zeruns/xt60-power-meter/03-Datasheet/_命名规范.md

# 03-Datasheet 命名规范

> 2026-09-05 整理。目的：统一规格书/文档命名，便于检索与复购。

## 命名格式

| 来源 | 格式 | 示例 |
|---|---|---|
| 立创商城器件 | `型号_分类_规格书[_语言]_C编号.pdf` | `SY8511BADC_DC-DC电源芯片_规格书_中文机翻_C4944084.pdf` |
| 厂商原版文档 | `型号_描述_文档类型_语言.pdf` | `TPS2116_电源多路复用器_规格书_英文.pdf` |
| 应用笔记/参考 | `厂商-文档号_主题_类型_语言.pdf` | `TI-ZHCA068_模数转换术语词汇表_中文.pdf` |
| 显示模组资料 | 子目录 `模组型号_描述`，内部 `模组型号_内容类型_版本.zip` | `TK018F3716_例程_ESP32_LVGL_QSPI.zip` |

**规则**：

1. **型号永远放在文件名最前面**，同型号多份文档（规格书/手册/EVM）靠前缀自然聚在一起排序；
2. 扩展名一律小写 `.pdf`；
3. 语言后缀：存在多语言版本时区分 `英文` / `中文` / `中文机翻`；单一中文原版可不加；
4. 立创商城文件的 **C 编号固定放在文件名最后**（复购检索键），WJ 文档编号已去除；
5. 机翻文档一律带 `中文机翻` 标记，以区别原厂中文文档。

## 器件身份备注（原名无法辨识的 4 份）

| 文件 | 身份 |
|---|---|
| `HSS2P10_100V-P沟道MOSFET_规格书_英文.pdf` | 华笙半导体 hs-semi，P 沟道 100V 快速开关 MOSFET，SOT-23L |
| `LRA8551A-T_零漂移轨到轨运放_规格书_中文.pdf` | 洛瑞微 lorysemi，零漂移低噪声轨到轨 CMOS 运放（SOT23-5，覆盖 LRA8551/8552/8554） |
| `NV3030B_TFT控制器驱动IC_规格书_英文.pdf` | 上海新相微，240RGB×320 TFT 控制器驱动 IC（TK018F3716 屏配套） |
| `TI-ZHCA068_模数转换术语词汇表_中文.pdf` | TI 应用报告 ZHCA068《术语词汇表：模数转换的规格和性能特点》 |

## 已完成整改（2026-09-05）

全部 22 项（根目录 17 文件 + 屏模组资料目录及其内部 8 项）均已按上述规范重命名完毕。
