zeruns/xt60-power-meter/05-生产文件/02-贴片/02-上板_V1/01-上板_V1-BOM.xlsx

No. | Quantity | Comment | Designator | Footprint | Manufacturer Part | 规格 | 单价 | 价格 | 立创商城编号 | 淘宝购买链接 | 备注：表中单价为立创商城商品页当前标价（人民币），查询日期 2026-09-16；总价见末行
1 | 1 | 4kHz | BUZZER1 | BUZ-SMD_3P-L5.0-W5.0-BL | SMD-5025-0340-12Ω | 贴片无源蜂鸣器，SMD-5025-0340-12Ω，3V/4kHz/5x5mm | ￥3.010 | ￥3.010 | C2693575
2 | 11 | 4.7uF | C1,C3,C6,C9,C10,C14,C20,C26,C27,C28,C31 | C0402 | CL05A475KP5NRNC | 贴片电容，0402，4.7uF/10V/±10%/X5R | ￥0.102 | ￥1.127 | C368809 | https://s.click.taobao.com/t
3 | 4 | 22uF | C2,C5,C8,C12 | C0402 | CL05A226MQ5QUNC | 贴片电容，0402，22uF/6.3V/±20%/X5R | ￥0.828 | ￥3.310 | C105226
4 | 15 | 100nF | C4,C7,C15,C21,C22,C23,C24,C29,C32,C37,C38,C42,C43,C45,C46 | C0402 | CL05A104KA5NNNC | 贴片电容，0402，100nF/25V/±10%/X5R | ￥0.037 | ￥0.552 | C100072 | https://s.click.taobao.com/t
5 | 1 | 100nF | C11 | C0603 | 0603B104K101NT | 贴片电容，0603，100nF/100V/±10%/X7R | ￥0.074 | ￥0.074 | C88219
6 | 4 | 10uF | C13,C18,C19,C30 | C0402 | CL05A106MQ5NUNC | 贴片电容，0402，10uF/6.3V/±20%/X5R | ￥0.157 | ￥0.629 | C15525
7 | 1 | 4.7uF | C16 | C1206 | GRM31CC72A475KE11L | 贴片电容，1206，4.7uF/100V/±10%/X7S | ￥2.669 | ￥2.669 | C237304
8 | 1 | 1uF | C17 | C1206 | 1206B105K101NT | 贴片电容，1206，1uF/100V/±10%/X7R | ￥0.356 | ￥0.356 | C91151
9 | 1 | 47pF | C25 | C0402 | 0402CG470J500NT | 贴片电容，0402，47pF/50V/±5%/C0G | ￥0.050 | ￥0.050 | C1567
10 | 4 | 220nF | C33,C34,C40,C44 | C0402 | CL05B224KO5NNNC | 贴片电容，0402，220nF/16V/±10%/X7R | ￥0.031 | ￥0.124 | C16772
11 | 1 | 1uF | C35 | C0402 | CL05A105KA5NQNC | 贴片电容，0402，1uF/25V/±10%/X5R | ￥0.060 | ￥0.060 | C52923
12 | 2 | 10nF | C36,C39 | C0402 | CL05B103KB5NNNC | 贴片电容，0402，10nF/50V/±10%/X7R | ￥0.030 | ￥0.061 | C15195
13 | 1 | 10pF | C41 | C0402 | CL05C100JB5NNNC | 贴片电容，0402，10pF/50V/±5%/C0G | ￥0.038 | ￥0.038 | C32949
14 | 1 | BTB0.408-24PLBDR-M41 | CN1 | CONN-SMD_BTB0.408-24PLBDR-M41 | BTB0.408-24PLBDR-M41 | 板对板连接器，BTB0.408-24PLBDR-M41，0.4mm间距/24P/双排立贴/镀金 | ￥1.309 | ￥1.309 | C42420567
15 | 1 | HX PM2.0-1x6P TP-YQ | CN2 | CONN-SMD_6P-P2.00_HX-PM2.0-1X6P-TP-YQ | HX PM2.0-1x6P TP-YQ | 排母连接器，HX PM2.0-1x6P TP-YQ，2.0mm间距/1×6P/立贴 | ￥1.248 | ￥1.248 | C42379205
16 | 4 | CUS10S30,H3F | D1,D3,D4,D13 | SOD-323_L1.8-W1.3-LS2.5-RD | CUS10S30,H3F | 肖特基二极管，CUS10S30，SOD-323，30V/300mA | ￥0.303 | ￥1.214 | C146335
17 | 4 | ESD9B5.0ST5G | D2,D5,D6,D7 | SOD-923_L0.8-W0.6-LS1.0-BI | ESD9B5.0ST5G | TVS二极管，ESD9B5.0ST5G，SOD-923，5V双向ESD防护/钳位15V | ￥0.280 | ￥1.120 | C111566
18 | 3 | ESD9B3.3ST5G-N | D8,D10,D11 | DFN1006-2L-BI | ESD9B3.3ST5G-N | ESD二极管，ESD9B3.3ST5G-N，DFN1006-2，3.3V双向/钳位8V | ￥0.149 | ￥0.448 | C316039
19 | 1 | SS210B | D9 | SMB_L4.6-W3.6-LS5.3-RD | SS210B | 肖特基二极管，SS210B，SMB(DO-214AA)，100V/2A | ￥0.241 | ￥0.241 | C18199186
20 | 1 | BZT52C12 | D12 | SOD-123_L2.7-W1.6-LS3.7-RD | BZT52C12 | 稳压二极管，BZT52C12，SOD-123，12V/350mW | ￥0.103 | ￥0.103 | C19077410 | https://s.click.taobao.com/t
21 | 2 | SMD0805-200-9V | F1,F2 | F0805 | SMD0805-200-9V | 自恢复保险丝，SMD0805-200-9V，0805，9V/保持2A/触断4A | ￥0.483 | ￥0.967 | C2843996
22 | 1 | S1206-FC-1.0A | F3 | F1206 | S1206-FC-1.0A | 一次性贴片保险丝，S1206-FC-1.0A，1206，1A/100V | ￥1.360 | ￥1.360 | C2691993
23 | 1 | ZX-MX1.25-2PWT | J1 | CONN-SMD_2P-P1.25_MEGASTAR_ZX-MX1.25-2PWT | ZX-MX1.25-2PWT | 线对板连接器，ZX-MX1.25-2PWT，1.25mm间距/2P/侧卧贴/1A | ￥0.179 | ￥0.179 | C7430468 | https://s.click.taobao.com/t
24 | 1 | 2.2uH | L1 | IND-SMD_L2.0-W1.6-B | FTC201610S2R2MBCA | 功率电感，FTC201610S2R2，0806，2.2uH/2.5A/饱和3A | ￥0.272 | ￥0.272 | C5832344
25 | 1 | 47uH | L2 | IND-SMD_L6.0-W6.0_FNR60XXS | FNR6045S470MT | 功率电感，FNR6045S470MT，6x6mm，47uH/1.3A/饱和1.5A/磁屏蔽 | ￥0.434 | ￥0.434 | C168087 | https://s.click.taobao.com/t
26 | 3 | BLM18PG121SN1D | L3,L4,L5 | L0603 | BLM18PG121SN1D | 贴片磁珠，BLM18PG121SN1D，0603，120Ω@100MHz/2A/DCR 50mΩ | ￥0.096 | ￥0.289 | C14709 | https://s.click.taobao.com/t
27 | 1 | XL-3210SURUGC | LED1 | LED-SMD_4P-L3.2-W1.5_XL-3210SURUGC | XL-3210SURUGC | 贴片LED，XL-3210SURUGC，3210侧发光，红(625nm)+翠绿(525nm)双色 | ￥0.196 | ￥0.196 | C965883 | https://s.click.taobao.com/t
28 | 1 | KT-0603R | LED2 | LED-SMD_L1.6-W0.8-R-RD | KT-0603R | 贴片LED，KT-0603R，0603，红色/645nm/20mA | ￥0.045 | ￥0.045 | C2286 | https://s.click.taobao.com/t
29 | 1 | SP30P25DNJ | Q1 | PDFN3333-8_L3.3-W3.3-P0.65-LS3.4-BL | SP30P25DNJ | P沟道MOSFET，SP30P25DNJ，PDFNWB-8L(3.3x3.3)，-30V/10A | ￥0.611 | ￥0.611 | C41355085
30 | 1 | AO3401A | Q2 | SOT-23_L2.9-W1.3-P1.90-LS2.4-BR | AO3401A | P沟道MOSFET，AO3401A，SOT-23，-30V/4.2A | ￥0.225 | ￥0.225 | C347476 | https://s.click.taobao.com/t
31 | 2 | AO3400A | Q3,Q5 | SOT-23-3_L2.9-W1.3-P1.90-LS2.4-BR | AO3400A | N沟道MOSFET，AO3400A，SOT-23，30V/5.8A | ￥0.228 | ￥0.456 | C347475 | https://s.click.taobao.com/t
32 | 1 | HSS2P10 | Q4 | SOT-23-3_L2.9-W1.6-P1.90-LS2.8-BR | HSS2P10 | P沟道MOSFET，HSS2P10，SOT-23L，-100V/2A | ￥0.788 | ￥0.788 | C845592
34 | 12 | 10kΩ | R1,R7,R10,R13,R18,R20,R21,R22,R32,R38,R41,R42 | R0402 | 0402WGF1002TCE | 贴片电阻，0402，10kΩ/±1%/62.5mW | ￥0.021 | ￥0.246 | C25744 | https://s.click.taobao.com/t
35 | 3 | 5.1kΩ | R2,R3,R4 | R0402 | 0402WGF5101TCE | 贴片电阻，0402，5.1kΩ/±1%/62.5mW | ￥0.013 | ￥0.040 | C25905 | https://s.click.taobao.com/t
36 | 1 | 32.4kΩ | R5 | R0402 | 0402WGF3242TCE | 贴片电阻，0402，32.4kΩ/±1%/62.5mW | ￥0.016 | ￥0.016 | C26974 | https://s.click.taobao.com/t
37 | 2 | 100kΩ | R6,R24 | R0402 | 0402WGF1003TCE | 贴片电阻，0402，100kΩ/±1%/62.5mW | ￥0.014 | ￥0.028 | C25741 | https://s.click.taobao.com/t
38 | 1 | 5.1Ω | R8 | R0402 | 0402WGJ051JTCE | 贴片电阻，0402，5.1Ω/±5%/62.5mW | ￥0.010 | ￥0.010 | C25174 | https://s.click.taobao.com/t
39 | 4 | 10Ω | R9,R23,R26,R40 | R0402 | 0402WGF100JTCE | 贴片电阻，0402，10Ω/±1%/62.5mW | ￥0.016 | ￥0.064 | C25077 | https://s.click.taobao.com/t
40 | 7 | 2.2kΩ | R11,R16,R19,R43,R44,R45,R46 | R0402 | 0402WGF2201TCE | 贴片电阻，0402，2.2kΩ/±1%/62.5mW | ￥0.032 | ￥0.227 | C25879 | https://s.click.taobao.com/t
41 | 1 | 10Ω | R12 | R0603 | 0603WAJ0100T5E | 贴片电阻，0603，10Ω/±5%/100mW | ￥0.013 | ￥0.013 | C25202 | https://s.click.taobao.com/t
42 | 1 | 470kΩ | R14 | R0805 | 0805W8F4703T5E | 贴片电阻，0805，470kΩ/±1%/125mW | ￥0.013 | ￥0.013 | C17709 | https://s.click.taobao.com/t
43 | 2 | 150kΩ | R15,R17 | R0805 | 0805W8F1503T5E | 贴片电阻，0805，150kΩ/±1%/125mW | ￥0.027 | ￥0.054 | C17470 | https://s.click.taobao.com/t
44 | 1 | 1kΩ | R25 | R0402 | 0402WGF1001TCE | 贴片电阻，0402，1kΩ/±1%/62.5mW | ￥0.013 | ￥0.013 | C11702 | https://s.click.taobao.com/t
45 | 2 | 0Ω | R27,R28 | R0402 | 0402WGF0000TCE | 贴片电阻（0Ω跳线），0402，0Ω/62.5mW | ￥0.015 | ￥0.030 | C17168 | https://s.click.taobao.com/t
46 | 4 | 49.9Ω | R30,R31,R35,R37 | R0402 | 0402WGF499JTCE | 贴片电阻，0402，49.9Ω/±1%/62.5mW | ￥0.015 | ￥0.061 | C25120 | https://s.click.taobao.com/t
47 | 1 | 100kΩ | R33 | R0805 | RT0805BRD07100KL | 贴片精密电阻，0805，100kΩ/±0.1%/125mW | ￥0.255 | ￥0.255 | C122537 | https://s.click.taobao.com/t
48 | 2 | 22Ω | R34,R36 | R0402 | 0402WGF220JTCE | 贴片电阻，0402，22Ω/±1%/62.5mW | ￥0.016 | ￥0.032 | C25092 | https://s.click.taobao.com/t
49 | 1 | 1kΩ | R39 | R0805 | RT0805BRD071KL | 贴片精密电阻，0805，1kΩ/±0.1%/125mW | ￥0.269 | ￥0.269 | C110774 | https://s.click.taobao.com/t
50 | 1 | MST-12D18G4 SPDT Slide Switch | SW1 | SW-SMD_MST-12D18G4-SPDT-SLIDE-SWITCH | MST-12D18G4 SPDT Slide Switch | 拨动开关，MST-12D18G4，SPDT/卧贴/12V 100mA | ￥0.486 | ￥0.486 | C49023767
51 | 2 | TS-1045-A13B3-D2 | SW2,SW4 | SW-SMD_L7.5-W8.0-P4.50_TS-1045-A13B3-D2 | TS-1045-A13B3-D2 | 轻触开关，TS-1045-A13B3-D2，SMD侧按/250gf/带定位柱/8x7.5mm | ￥0.628 | ￥1.256 | C557898
52 | 1 | TS-1088-AR02016 | SW3 | SW-SMD_L3.9-W3.0-P4.45 | TS-1088-AR02016 | 轻触开关，TS-1088-AR02016，SMD/160gf/12V/10万次，小龟按键 | ￥0.314 | ￥0.314 | C720477 | https://s.click.taobao.com/t
53 | 1 | TLV62084DSGR | U1 | WSON-8_L2.0-W2.0-P0.50-BL-EP_DSG | TLV62084DSGR | DC-DC同步降压芯片，TLV62084DSGR，WSON-8(2x2)，2MHz/2A/输入2.5~6V | ￥0.945 | ￥0.945 | C181488 | https://s.click.taobao.com/t
54 | 1 | TP4057 | U2 | SOT-23-6_L2.9-W1.6-P0.95-LS2.8-BR | TP4057 | 锂电池充电管理芯片，TP4057，SOT-23-6，输入4~6.5V/恒流恒压充电 | ￥0.250 | ￥0.250 | C725791 | https://s.click.taobao.com/t
55 | 1 | SY8511BADC | U3 | TSOT-23-6_L2.9-W1.6-P0.95-LS2.8-BR | SY8511BADC | DC-DC降压芯片，SY8511BADC，TSOT-23-6，输入100V/1.2A/200kHz | ￥4.070 | ￥4.070 | C4944084
56 | 1 | ESP32-S3-WROOM-1-N16R8 | U4 | WIRELM-SMD_ESP32-S3-WROOM-1 | ESP32-S3-WROOM-1-N16R8 | 主控WiFi+蓝牙模组，ESP32-S3-WROOM-1-N16R8，16MB Flash/8MB PSRAM/PCB天线 | ￥31.600 | ￥31.600 | C2913202 | https://s.click.taobao.com/t
57 | 1 | 8.192MHz | U5 | OSC-SMD_4P-L3.2-W2.5-CJ13-320001210A20 | OT2JI-111-8.192M | 有源晶振，OT2JI-111-8.192M，SMD3225-4P，8.192MHz/±10ppm/1.8~3.3V | ￥2.940 | ￥2.940 | C7425393 | https://s.click.taobao.com/t?skuId=4412713765749
58 | 1 | ADS131M02IRUKR | U6 | WQFN-20_L3.0-W3.0-P0.40-TL-EP1.7 | ADS131M02IRUKR | ADC芯片，ADS131M02IRUKR，WQFN-20(3x3)，双通道24位ΔΣ同步采样 | ￥16.800 | ￥16.800 | C5215160 | https://s.click.taobao.com/t
59 | 1 | LRA8551A-T | U7 | SOT-23-5_L2.9-W1.6-P0.95-LS2.8-BR | LRA8551A-T | 运算放大器，LRA8551A-T，SOT-23-5，零漂移/轨到轨/1.7MHz | ￥1.273 | ￥1.273 | C54333729
60 | 1 | SC7A20HTR | U8 | LGA-12_L2.0-W2.0-P0.50-TL | SC7A20HTR | 三轴加速度计，SC7A20HTR，LGA-12(2x2)，I2C/SPI/±16g/12bit | ￥1.749 | ￥1.749 | C19274408 | https://s.click.taobao.com/t
61 | 1 | AHT20 | U9 | SENSOR-SMD_L3.0-W3.0-P1.00-BR | AHT20 | 温湿度传感器，AHT20，SMD，I2C/±2%RH/±0.3℃ | ￥4.890 | ￥4.890 | C2757850
62 | 1 | TYPE-C 16PIN 2MD(073) | USB1 | USB_TYPE-C-16P | TYPE-C 16PIN 2MD(073) | USB连接器，TYPE-C 16PIN 2MD(073)，16P母座/卧贴/5V | ￥0.434 | ￥0.434 | C2765186
 |  |  |  |  |  |  | 总价 | ¥152.941
 |  |  |  |  |  |  | 元器件 | ￥91.944
 | 1 |  |  |  |  | 聚合物锂电池，带保护板/500mAh/MX1.25反向公插，长宽高 51x22x5mm | ￥8.200 | ￥8.200 |  | https://s.click.taobao.com/t
 | 1 |  |  |  |  | 导光柱，直径3mm，长5.5mm | ￥0.209 | ￥0.209 |  | https://uland.taobao.com/coupon/edetail?traceId=213e0aaa17899884014852849e0cd6
 | 1 |  |  |  |  | 1.83寸电容触摸LCD屏，240×284，QSPI，NV3030B，TK018F3716 | ￥14.810 | ￥14.810 |  | https://item.taobao.com/item.htm?id=1001917382287
 | 1 |  |  |  |  | 青稞纸，贴电池用 | ￥2.380 | ￥2.380 |  | https://s.click.taobao.com/t
 | 8 |  |  |  |  | 热熔螺母，M2.5*3.5*3.5 | ￥0.062 | ￥0.498 |  | https://uland.taobao.com/coupon/edetail?traceId=215048c017899891999342969e0c20
 | 2 |  |  |  |  | XT60带线接头 | ￥5.500 | ￥11.000 |  | https://s.click.taobao.com/t
 | 1 |  |  |  |  | 3D打印外壳 | ￥15.000 | ￥15.000
 | 1 |  |  |  |  | SMT钢网 | ￥8.900 | ￥8.900 |  | https://s.click.taobao.com/t
 |  |  |  |  |  |  |  |  | 立创商城优惠券领取链接 | https://activity.szlcsc.com/invite/D03E5B9CEAAE70A4.html
 |  |  |  |  |  |  |  | 128.33
