zeruns/xt60-power-meter/05-生产文件/02-贴片/01-下板/01-下板-BOM.xlsx

No. | Quantity | Comment | Designator | Footprint | Manufacturer Part | 规格 | 单价 | 价格 | 立创商城编号 | 淘宝购买链接 | 备注：表中单价为立创商城商品页当前标价（人民币），查询日期 2026-09-16；总价见末行
1 | 1 | XT60PW-M | CN1 | CONN-TH_XT60PW-M | XT60PW-M | XT60电源连接器（公头），AMASS XT60PW-M，卧式穿板焊接 | ￥3.300 | ￥3.300 | C98732 | https://s.click.taobao.com/t
2 | 1 | XT60PW-F | CN2 | TH_2P-XT60PW-F | XT60PW-F | XT60电源连接器（母头），AMASS XT60PW-F，卧式穿板焊接 | 3.9400 | ￥3.940 | C428722 | https://s.click.taobao.com/t
3 | 5 | BTC-1842-BT01 | CU1,CU2,CU3,CU4,CU5 | CONN-SMD_BTC-1842-BT01 | BTC-1842-BT01 | 导电铜块，BTC-1842-BT01，SMD/18×4×2mm/黄铜镀锡 | 0.9886 | ￥4.943 | C42455226 | https://s.click.taobao.com/t
4 | 1 | SMBJ100A | D1 | SMB_L4.6-W3.6-LS5.3-RD | SMBJ100A | TVS二极管，SMBJ100A，SMB(DO-214AA)，单向100V/600W/钳位162V | 0.6880 | ￥0.688 | C151249 | https://s.click.taobao.com/t
5 | 1 | HX PZ2.0-1x6P TP-YQ | H1 | HDR-SMD_6P-P2.00-V-M-LS4.4-L_XKB-R1 | HX PZ2.0-1x6P TP-YQ | 排母连接器，2.0mm间距/1×6P/立贴/反脚位/针长10mm | 0.4706 | ￥0.471 | C41417345 | https://s.click.taobao.com/t
6 | 1 | 1mΩ | R1 | RES-SMD_SBB-M-1F-Y-T5 | SBB-M-1F-Y-T5 | 四端开尔文分流电阻，SBB-M-1F-Y-T5，1mΩ/5W/±1%/±75ppm | 3.6900 | ￥3.690 | C469457 | https://s.click.taobao.com/t
 |  |  |  |  |  |  | 总价 | ￥17.031
 |  |  |  |  |  |  |  |  | 立创商城优惠券领取链接 | https://activity.szlcsc.com/invite/D03E5B9CEAAE70A4.html
