zeruns/xt60-power-meter/05-生产文件/03-外壳3D打印文件/上盖.3MF

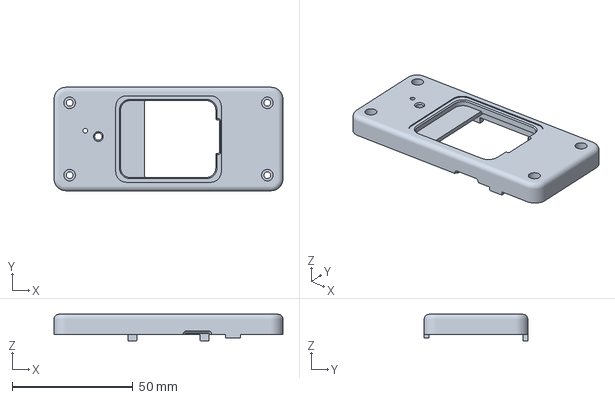
[picture p3: CAD file, 2026-10-08]
05-生产文件/03-外壳3D打印文件/上盖.3MF
95.0 x 43.0 x 11.0 mm
