zeruns/xt60-power-meter/05-生产文件/03-外壳3D打印文件/合并打印.3mf

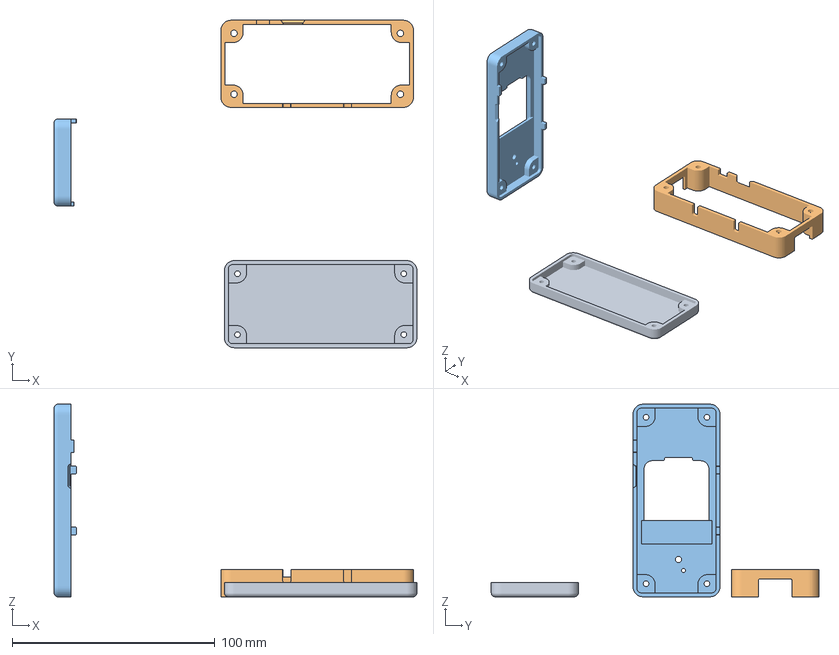
[picture p4: CAD file, 2026-10-08]
05-生产文件/03-外壳3D打印文件/合并打印.3mf
178.9 x 161.5 x 95.0 mm
底盖
中框
上盖
