zeruns/xt60-power-meter/04-外壳设计/中框.SLDPRT

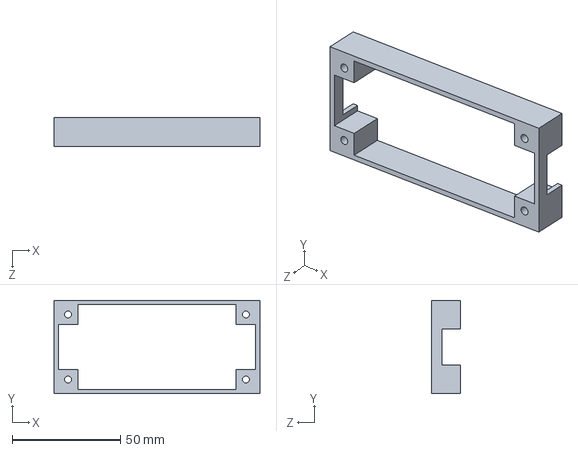
[picture p5: CAD file, 2026-10-08]
04-外壳设计/中框.SLDPRT
95.0 x 43.0 x 13.5 mm
