zeruns/xt60-power-meter/05-生产文件/03-外壳3D打印文件/中框.3MF

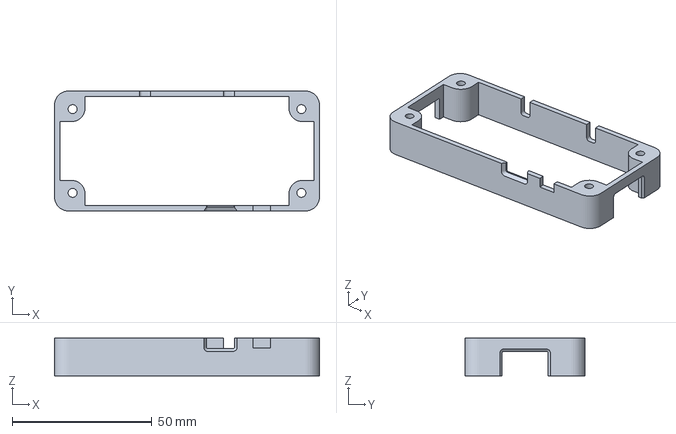
[picture p6: CAD file, 2026-10-08]
05-生产文件/03-外壳3D打印文件/中框.3MF
95.0 x 43.0 x 13.5 mm
