zeruns/xt60-power-meter/05-生产文件/03-外壳3D打印文件/底盖.3mf

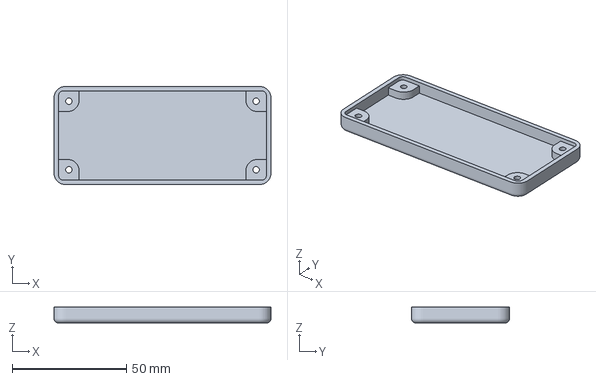
[picture p7: CAD file, 2026-10-08]
05-生产文件/03-外壳3D打印文件/底盖.3mf
95.0 x 43.0 x 7.00 mm
