zeruns/xt60-power-meter/04-外壳设计/外壳装配体.SLDASM

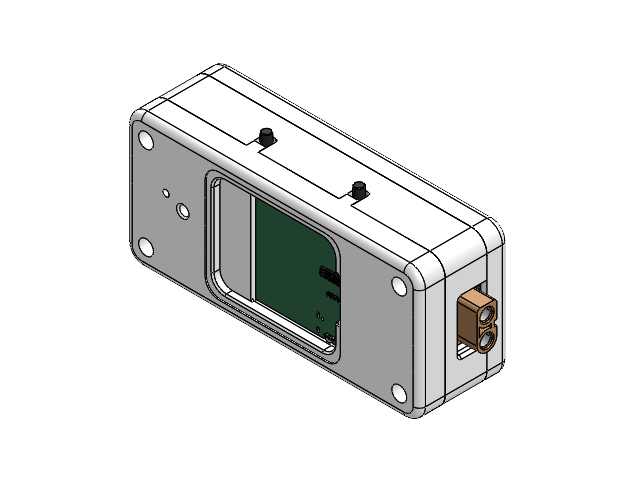
[picture p8: CAD file, 2026-10-08]
04-外壳设计/外壳装配体.SLDASM
SMB_L4.6-W3.6-LS5.3-RD~SMB_L4.6-W3.6-LS5.3-RD~CHkK.step
CONN-TH_XT60PW-M~CONN-TH_XT60PW-M~NLxI.step
TH_2P-XT60PW-F~TH_2P-XT60PW-F~r0KK.step
RES-SMD_SBB-M-1F-Y-T5~RES-SMD_SBB-M-1F-Y-T5~DRAF.step
CONN-SMD_BTC-1842-BT01~CONN-SMD_BTC-1842-BT01~lrje.step x 5
HDR-SMD_6P-P2.00-V-M-LS4.4-L_XKB-R1~HDR-SMD_6P-P2.00-V-M-LS4.4-L_XKB-R1~AGqm.step
Board~lj8n.step
中框
C0402~C0402_L1.0-W0.5-H0.5~iRhJ.step x 43
SOT-23-3_L2.9-W1.6-P1.90-LS2.8-BR~SOT-23-3L_L2.9-W1.6-H1.1-LS2.8-P0.95~3Ph4.step
WQFN-20_L3.0-W3.0-P0.40-TL-EP1.7~WQFN-20_L3.0-W3.0-H0.8-P0.40-TL-EP1.7~yOUk.step
PDFN3333-8_L3.3-W3.3-P0.65-LS3.4-BL~PDFN3333-8_L3.3-W3.3-P0.65-LS3.4-BL~Qcuu.step
WIRELM-SMD_ESP32-S3-WROOM-1~WIRELM-SMD_ESP32-S3-WROOM-1~ZIDr.step
SOD-323_L1.8-W1.3-LS2.5-RD~SOD-323_L1.8-W1.3-LS2.5-RD~OhwX.step x 4
C1206~C1206_L3.2-W1.6-H1.3~eSGD.step x 2
TSOT-23-6_L2.9-W1.6-P0.95-LS2.8-BR~TSOT-23-6_L2.9-W1.6-H1.1-LS2.8-P0.95~vyBI.step
SENSOR-SMD_L3.0-W3.0-P1.00-BR~SENSOR-SMD_L3.0-W3.0-P1.00-BL~TEV3.step
CONN-SMD_2P-P1.25_MEGASTAR_ZX-MX1.25-2PWT~CONN-SMD_2P-P1.25_MEGASTAR_ZX-MX1.25-2PWT~wOmS.step
SOT-23-6_L2.9-W1.6-P0.95-LS2.8-BR~SOT-23-6_L2.9-W1.6-H1.5-LS2.8-P0.95~tY5K.step
IND-SMD_L2.0-W1.6-B~IND-SMD_L2.0-W1.6-B~Fn8O.step
R0603~R0603~Tp1J.step
R0805~R0805_L2.0-W1.3-H0.6~w2o1.step x 5
F0805~F0805_L2.1-W1.4-H0.8~PwN9.step x 2
R0402~R0402_L1.0-W0.5-H0.4~yztK.step x 39
SW-SMD_MST-12D18G4-SPDT-SLIDE-SWITCH~SW-SMD_MST-12D18G4-SPDT-SLIDE-SWITCH~sU5d.step
SOT-23-3_L2.9-W1.3-P1.90-LS2.4-BR~SOT-23-3P_L2.9-W1.3-H1.0-LS2.4-P0.95~x4Bm.step x 2
SOT-23_L2.9-W1.3-P1.90-LS2.4-BR~SOT-23-3P_L2.9-W1.3-H1.0-LS2.4-P0.95~x4Bm.step
CONN-SMD_BTB0.408-24PLBDR-M41~CONN-SMD_BTB0.408-24PLBDR-M41~3VoG.step
CONN-SMD_6P-P2.00_HX-PM2.0-1X6P-TP-YQ~CONN-SMD_6P-P2.00_HX-PM2.0-1X6P-TP-YQ~gmyt.step
WSON-8_L2.0-W2.0-P0.50-BL-EP_DSG~WSON-8_L2.0-W2.0-H0.8-P0.50~izss.step
IND-SMD_L6.0-W6.0_FNR60XXS~IND-SMD_L6.0-W6.0-H2.8~AGfr.step
OSC-SMD_4P-L3.2-W2.5-CJ13-320001210A20~OSC-SMD_4P-L3.2-W2.5-CJ13-320001210A20~qHqt.step
SOD-123_L2.7-W1.6-LS3.7-RD~SOD-123_L2.7-W1.6-H1.4-LS3.7~TlDH.step
C0603~C0603_L1.6-W0.8-H0.8~jHWH.step
SMB_L4.6-W3.6-LS5.3-RD~SMB_L4.6-W3.6-LS5.3-RD~uK23.step
L0603~L0603_L1.6-W0.8-H0.5_BEAD~0wL0.step x 3
LED-SMD_L1.6-W0.8-R-RD~LED0603_L1.6-W0.8-H0.6~hOrp.step
USB_TYPE-C-16P~USB-C-SMD_TYPE-C-6PIN-2MD-073~608R.step
SOD-923_L0.8-W0.6-LS1.0-BI~SOD-923_L0.8-W0.6-H0.5-LS1.0~RgEq.step x 4
LED-SMD_4P-L3.2-W1.5_XL-3210SURUGC~LED-SMD_4P-L3.2-W1.5_XL-3210SURUGC~yK8K.step
BUZ-SMD_3P-L5.0-W5.0-BL~BUZ-SMD_3P-L5.0-W5.0-H3.0-BL~VJEj.step
DFN1006-2L-BI~DFN1006-2L-BI~nblW.step x 3
F1206~F1206_L3.2-W1.7-H0.6~HgEj.step
SW-SMD_L3.9-W3.0-P4.45~SW-SMD_L3.9-W2.9-H2.0-LS4.8~3HFB.step
SW-SMD_L7.5-W8.0-P4.50_TS-1045-A13B3-D2~SW-SMD_L7.5-W8.0-P4.50_TS-1045-A13B3-D2~0YKv.step x 2
LGA-12_L2.0-W2.0-P0.50-TL~LGA-12_L2.0-W2.0-H1.0-P0.50~G2pr.step
SOT-23-5_L2.9-W1.6-P0.95-LS2.8-BR~SOT-23-5_L2.9-W1.6-P0.95-LS2.8-BR~QRz2.step
Board~DWGG.step
上盖
底盖
