zeruns/xt60-power-meter/(list of files, cad)

Other CAD files:
03-Datasheet/TK018F3716_1.83寸LCD模组资料/TK018F3716_机构图.dwg
04-外壳设计/上盖.SLDPRT
04-外壳设计/底盖.SLDPRT
