zeruns/xt60-power-meter/02-Software/XT60-Power-Meter-Firmware/docs/images/oshwhub/ui-measure.png

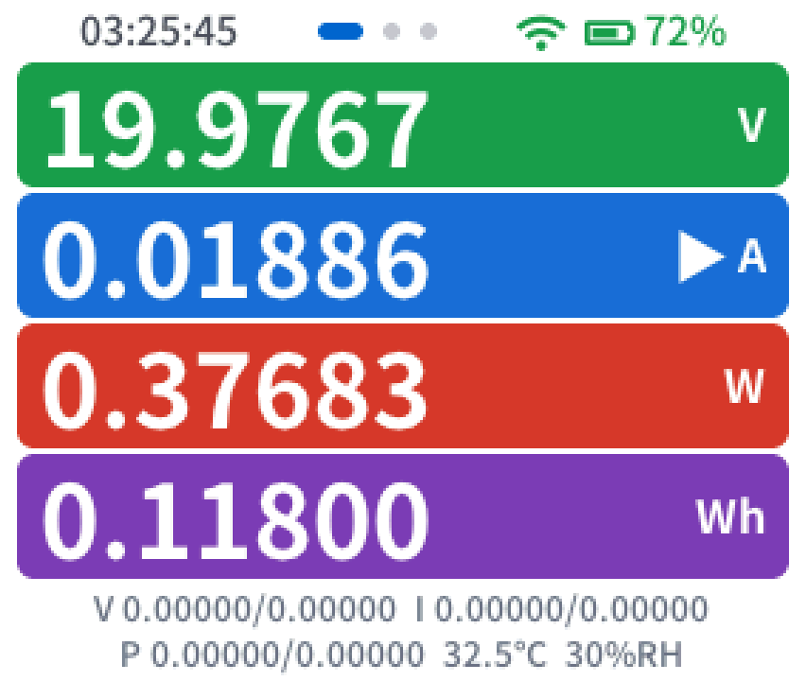
02-Software/XT60-Power-Meter-Firmware/docs/images/oshwhub/ui-measure.png
