zeruns/xt60-power-meter/01-Hardware/02-上板原理图_V2.pdf

# 3.3V Buck DC/DC（USB/电池供电）

## 最大输出电流2A

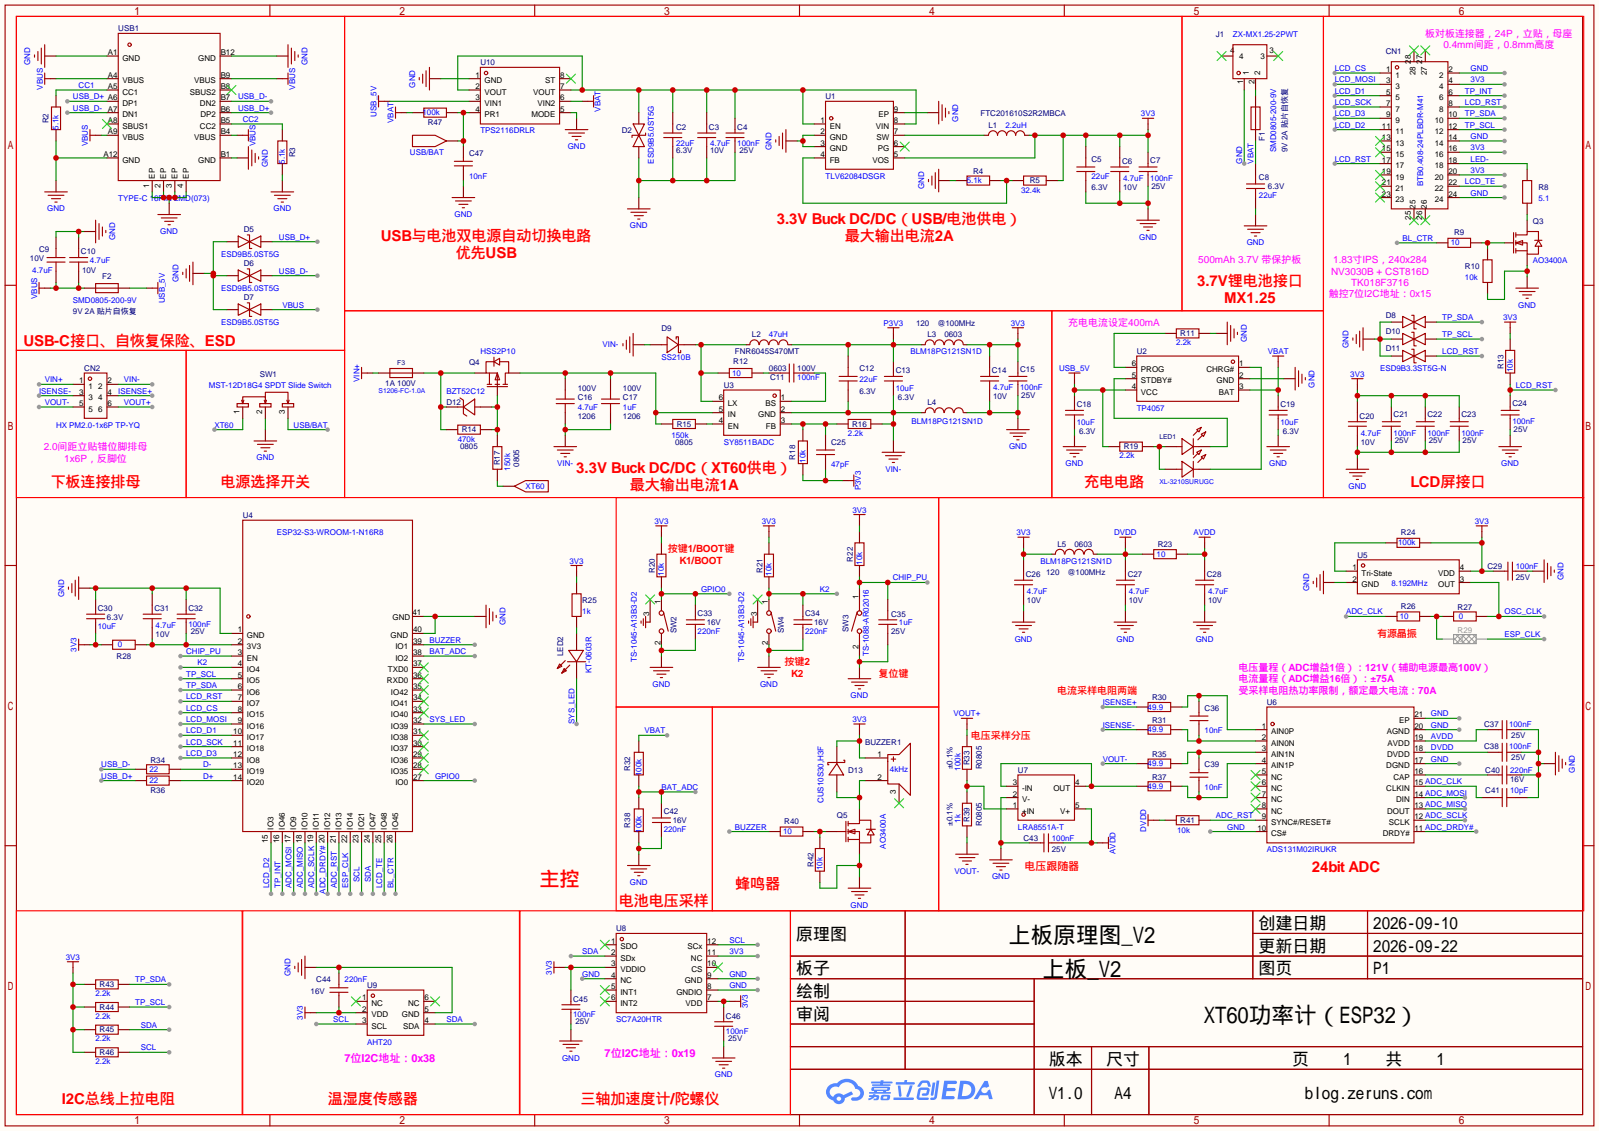
[picture p10: page 1]

USB-C接口、自恢复保险、ESD

MST-12D18G4 SPDT Slide Switch

原理图 | 上板原理图_V2 | 创建日期 | 2026-09-10

更新日期 | 2026-09-22

V1.0 | A4 | blog.zeruns.com
