zeruns/xt60-power-meter/01-Hardware/02-下板原理图.pdf

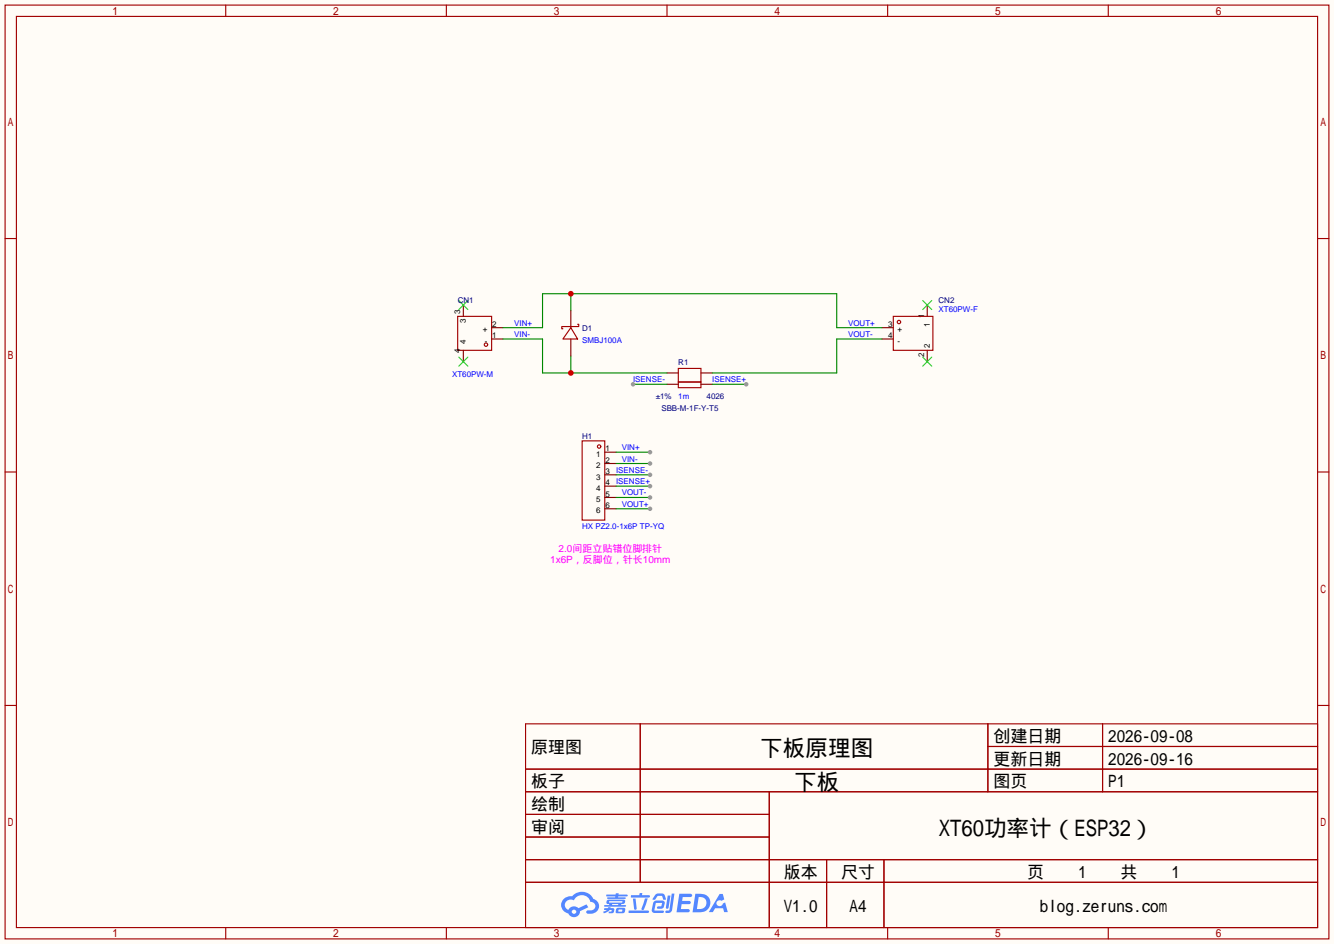
[picture p11: page 1]

原理图 | 下板原理图 | 创建日期 | 2026-09-08

更新日期 | 2026-09-16

板子 | 下板 | 图页 | P1
绘制 | | XT60功率计（ESP32）
审阅

V1.0 | A4 | blog.zeruns.com
