zeruns/xt60-power-meter/05-生产文件/02-贴片/01-下板/03-下板-位号图.pdf

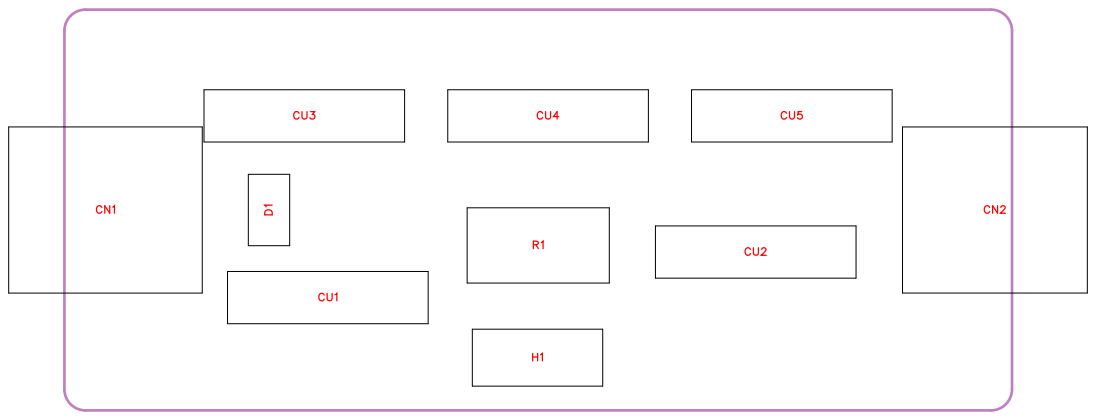
[picture p12: page 1]

# XT60功率计-下板_V1.0

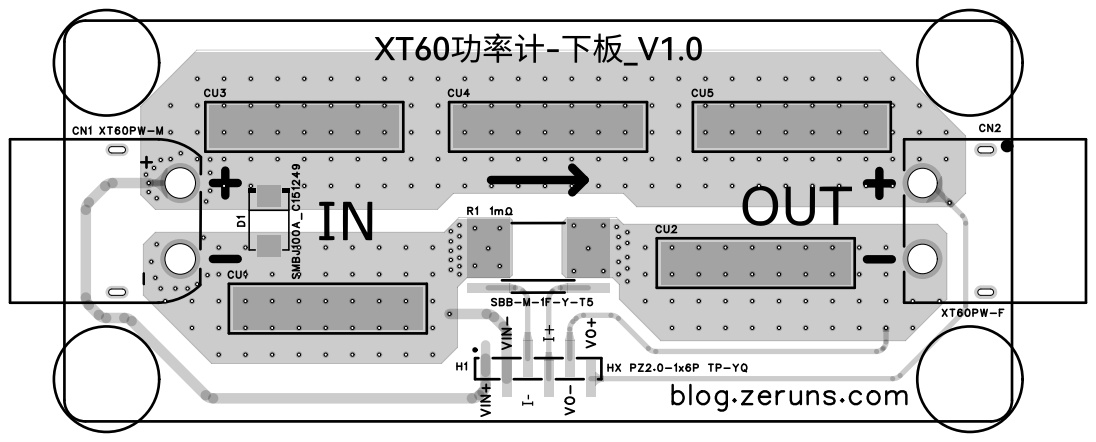
[picture p13: page 3]

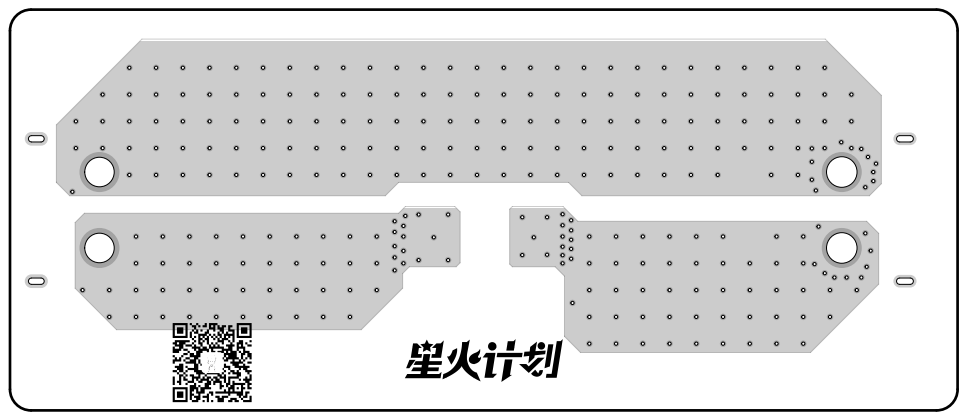
[picture p14: page 4]
