zeruns/xt60-power-meter/05-生产文件/02-贴片/02-上板_V1/03-上板_V1-位号图.pdf

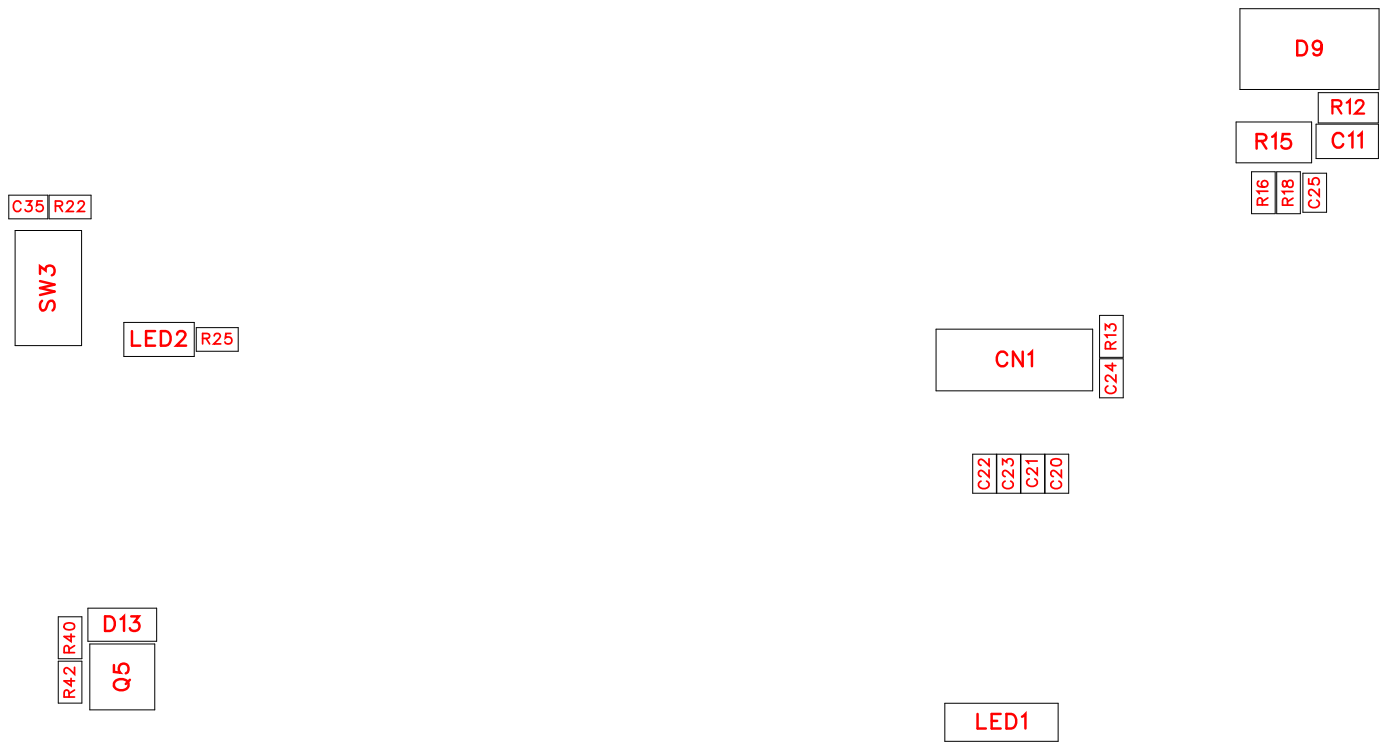
[picture p15: page 1]

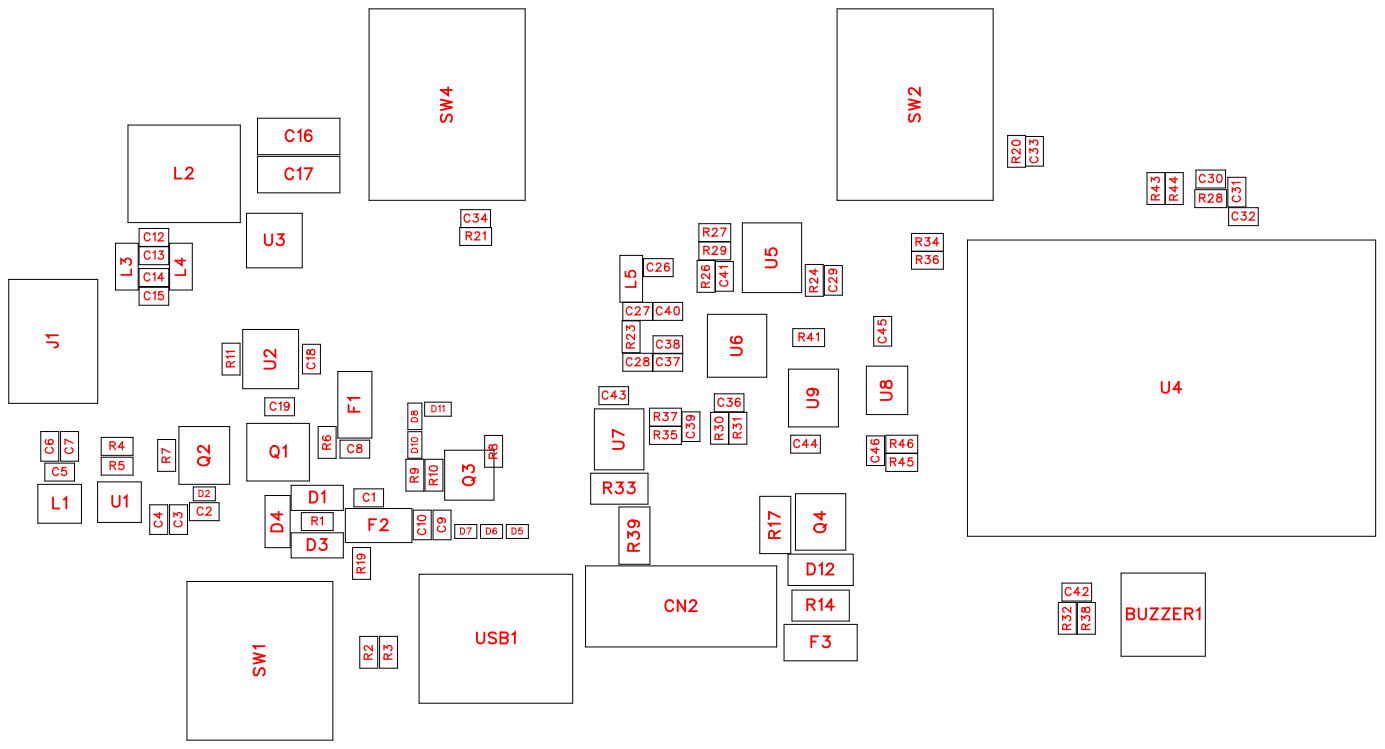
[picture p16: page 2]

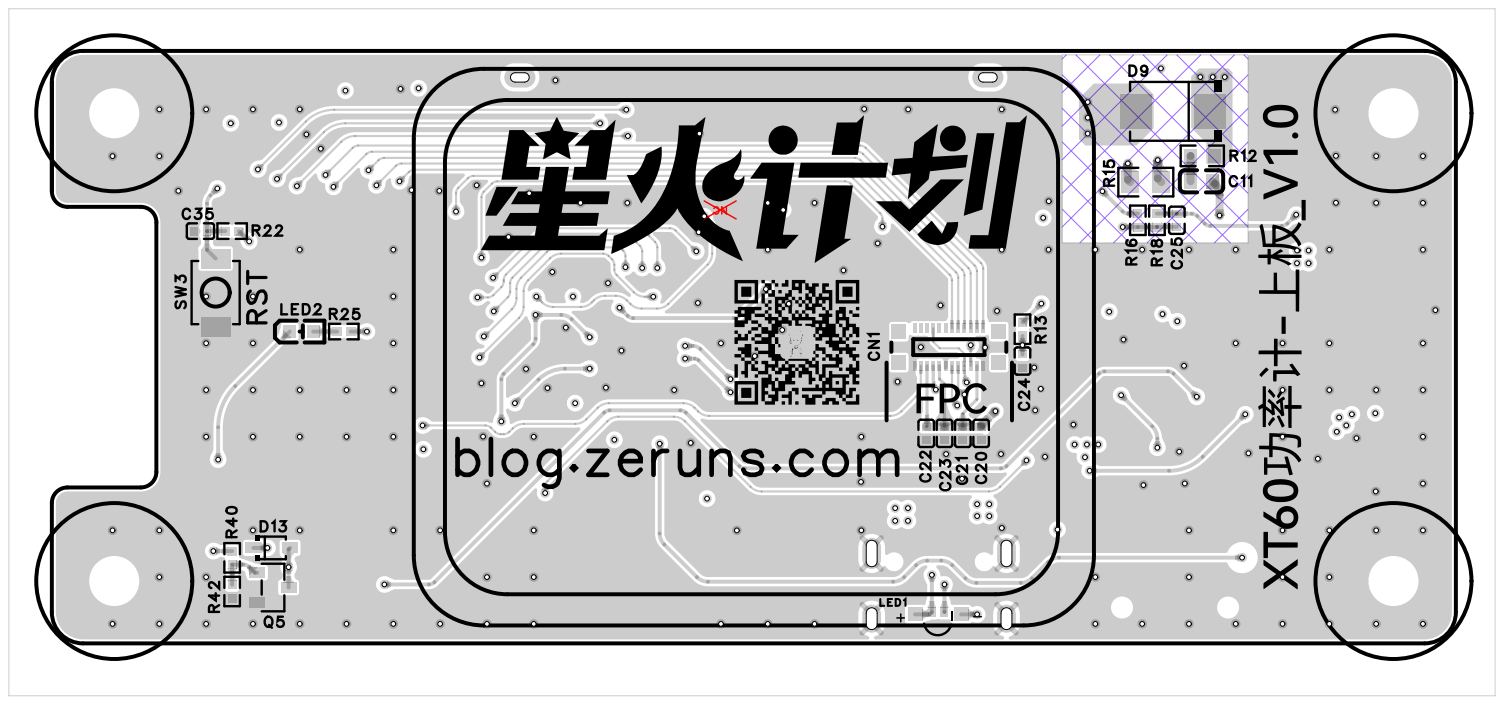
[picture p17: page 3]

K2 | K1/BOOT

# SW4 C¹⁰ C⁹

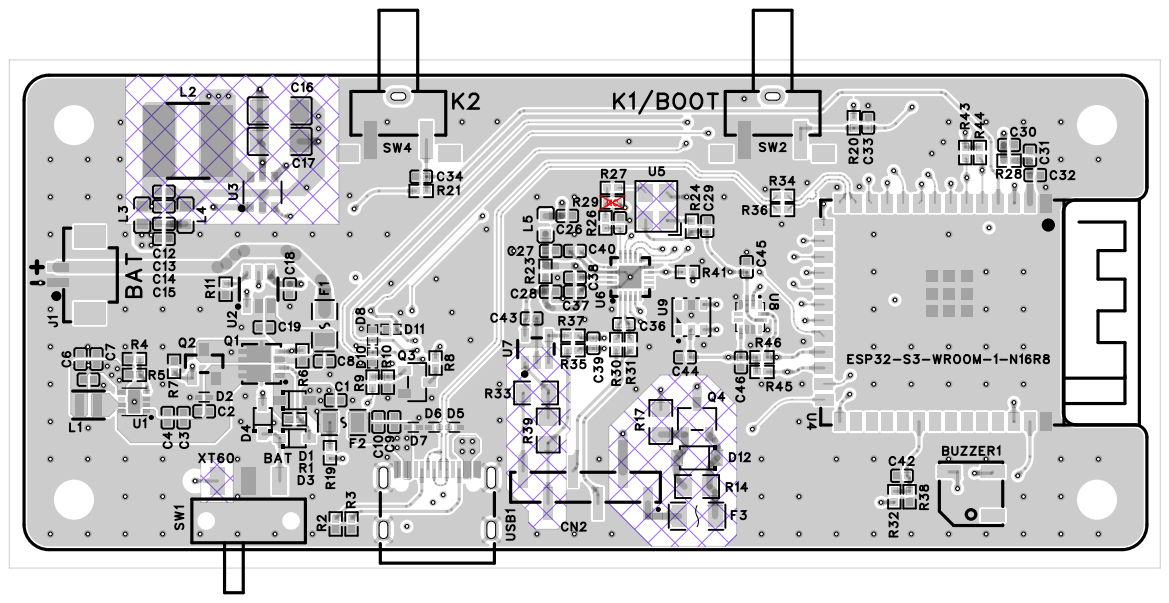
[picture p18: page 4]

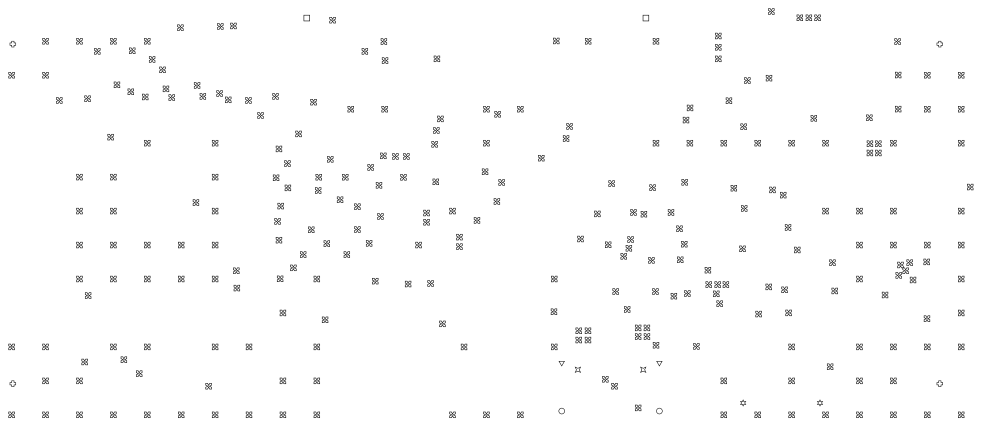
[picture p19: page 5]
