zeruns/xt60-power-meter/05-生产文件/02-贴片/03-上板_V2/03-上板_V2-位号图.pdf

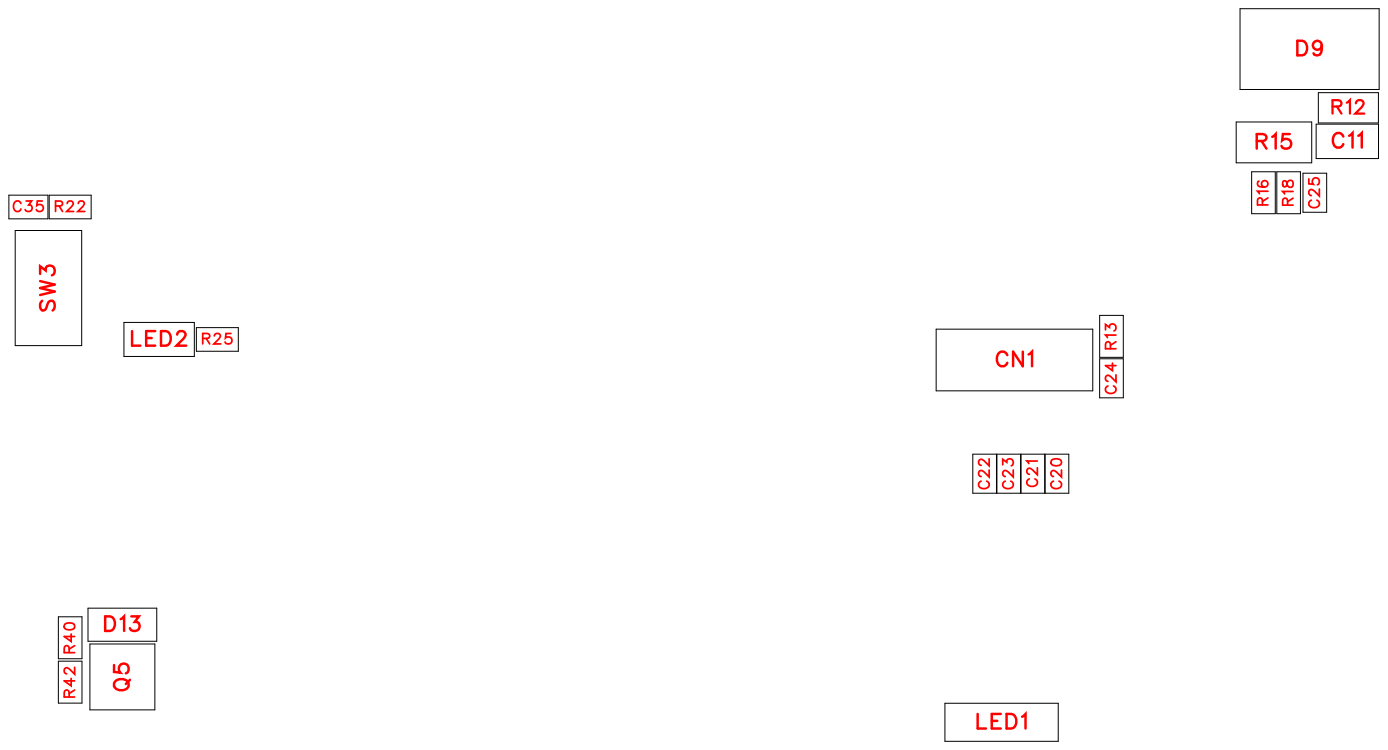
[picture p20: page 1]

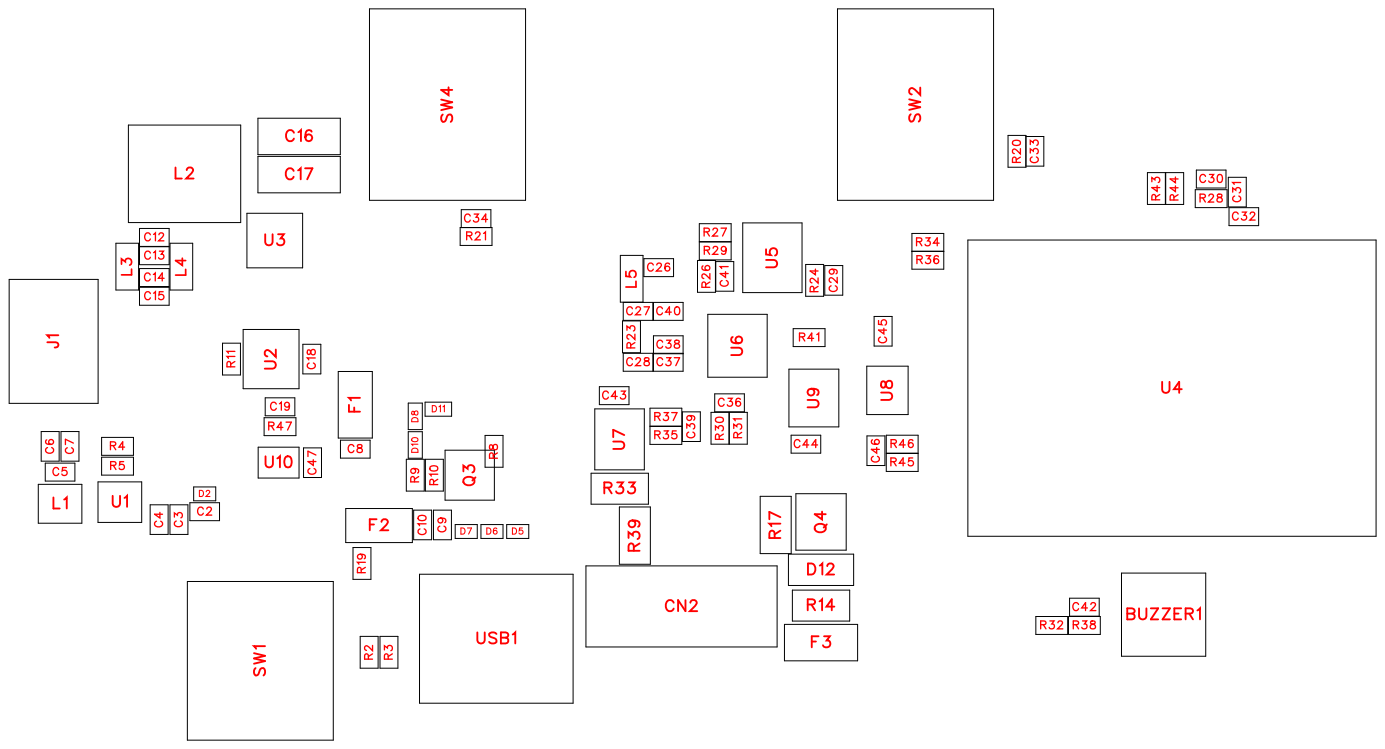
[picture p21: page 2]

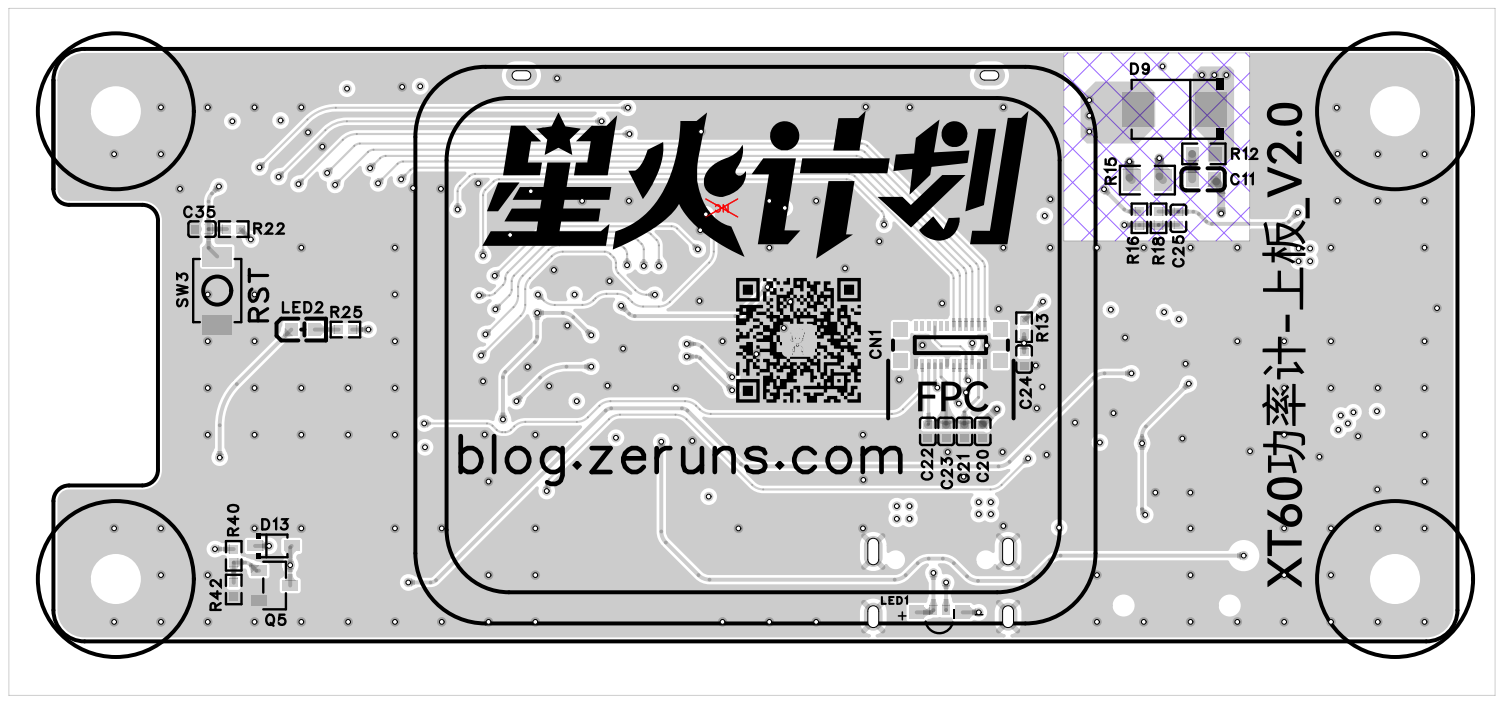
[picture p22: page 3]

K2 | K1/BOOT

# SW4 C¹⁰ C⁹

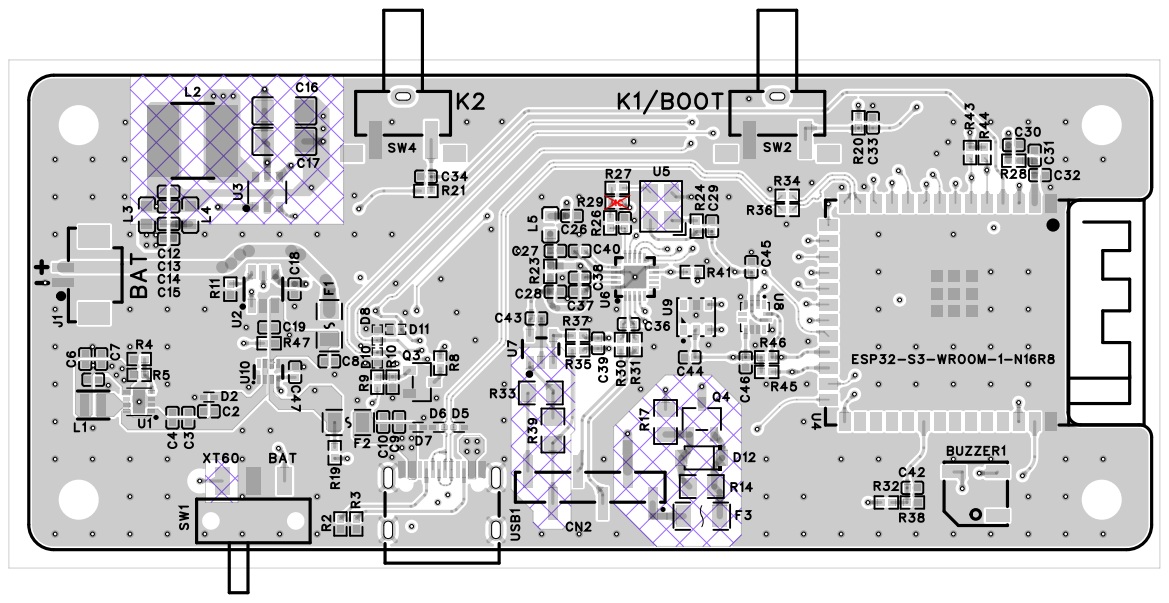
[picture p23: page 4]

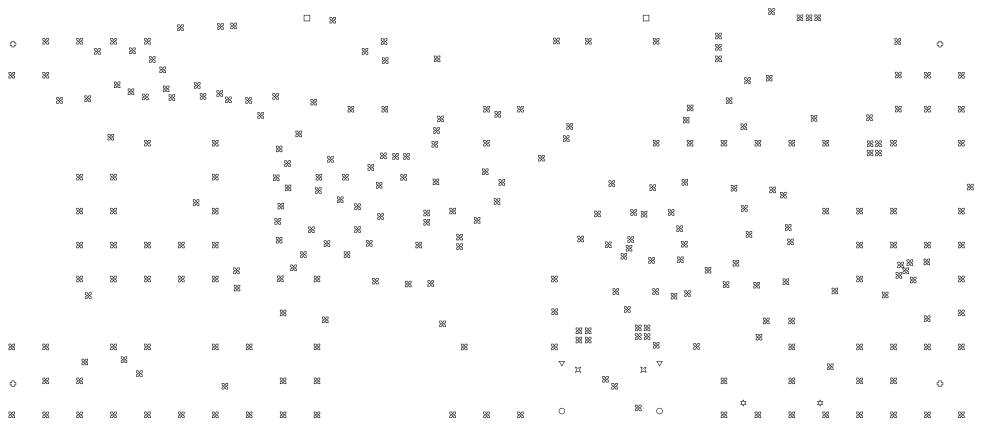
[picture p24: page 5]
