zeruns/xt60-power-meter/01-Hardware/02-上板原理图_V1.pdf

## 3.7V锂电池接口

# 3.3V Buck DC/DC（USB/电池供电）

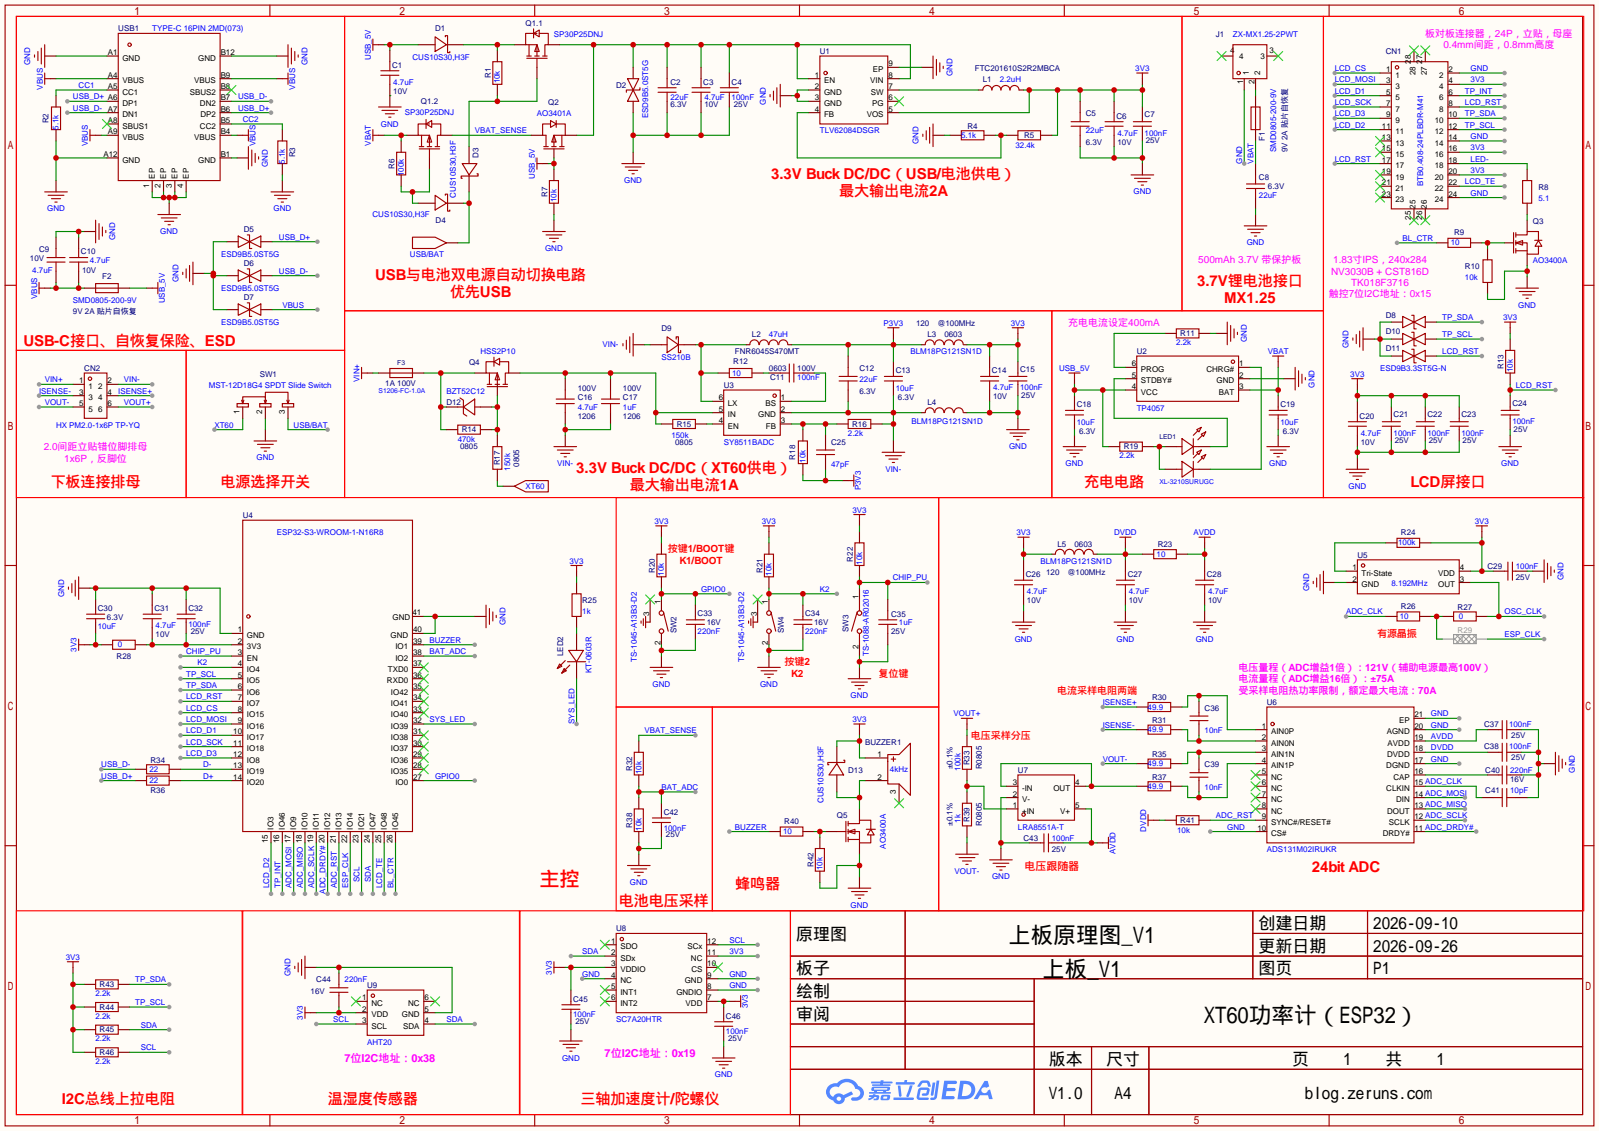
[picture p25: page 1]

USB-C接口、自恢复保险、ESD

MST-12D18G4 SPDT Slide Switch

原理图 | 上板原理图_V1 | 创建日期 | 2026-09-10

更新日期 | 2026-09-26

板子 | 上板_V1 | 图页 | P1
绘制 | | XT60功率计（ESP32）
审阅

V1.0 | A4 | blog.zeruns.com
