zeruns/xt60-power-meter/02-Software/XT60-Power-Meter-Firmware/components/drivers/ads131m02/src/ads131m02.c

/**
 * @file ads131m02.c
 * @brief ADS131M02 双通道 24bit 同步采样 ΔΣ ADC 驱动（SPI3+GDMA 引擎，DRDY ISR 直启）
 *
 * 器件：TI ADS131M02，2 通道同步采样 24bit ΔΣ ADC。
 *   AIN0 —— **电流**，PGA 增益 16x（1mΩ 四端开尔文分流器 ISENSE±）
 *   AIN1 —— **电压**，PGA 增益 1x（U7 电压跟随器 + 101:1 精密分压 R33 100kΩ / R39 1kΩ）
 * ⚠ 通道与直觉相反，依据上板原理图 V2 的实际接法；GAIN1 = 0x04，详见 ADS_GAIN1_VALUE 注释。
 * 引脚：见 board_pins.h 的 BOARD_PIN_ADC_*。
 *
 * 阅读顺序建议：
 *   ① 命令编码宏（下方 ADS_CMD_* / ADS_CMD_RREG / ADS_CMD_WREG）；
 *   ② ads131m02_engine（ads131m02_engine.c）—— SPI3+GDMA 帧引擎：
 *      DRDY ISR 内直接启动一帧 96bit DMA 传输（M2，见该文件头注释）；
 *   ③ ads131m02_init()  —— 建引擎、硬复位、UNLOCK、写 GAIN1/CLOCK、装 DRDY 中断；
 *   ④ ads131m02_read()  —— 从引擎消费一帧 -> CRC 校验 -> 取 CH0 / CH1。
 *
 * ============================================================
 * SPI 时序要点（TI 数据手册）
 * ============================================================
 *   · SPI mode 1（CPOL = 0, CPHA = 1）：SCLK 空闲低；数据在 SCLK 上升沿改变、
 *     下降沿锁存（主机与从机一致），故主机侧使用 mode 1。
 *   · 命令与数据都是 24bit 字、MSB 先出；16bit 命令码 MSB 对齐（cmd << 8）。
 *   · 命令响应出现在「命令帧之后的那一帧」的首字（TI 手册原文：the device outputs
 *     the register contents in the command response word of the following frame）。
 *     因此读寄存器分两次事务、各时钟一整帧，响应在第二帧首字。见 ads_read_reg()。
 *   · 转换数据帧 = [STATUS][CH0][CH1][输出CRC] = 4 个 24bit 字 = 12 字节。
 *     输出 CRC 恒在帧尾（不可关闭），必须整帧 4 字读取（见 ADS_FRAME_WORDS 注释）。
 *
 * ============================================================
 * 为什么用 SPI3_HOST，而不是文档里写的「独占 SPI2」
 * ============================================================
 * docs/hardware_pinout.md §5 要求 ADS131M02「独占 SPI2」，但其本意是
 * 「测量链路独占一条不被其他设备事务插入打断的总线」，不是字面上的外设编号
 * ——该结论写在 LCD 分配之前。当前 LCD（QSPI 4bit）已占用 SPI2_HOST，
 * 而 ESP32-S3 的一个 SPI 外设同一时刻只能映射一组引脚（LCD 在 IO15~18，
 * ADC 在 IO9~12，无法共存），因此这里改用 SPI3_HOST：同样满足「独占、不被打断」，
 * 且不改动已经跑通的 LCD 驱动。
 *
 * ============================================================
 * 硬件注意：本板 ADS131M02 没有片选（CS）引脚
 * ============================================================
 * hardware_pinout.md 的连接表只有 SCLK / MOSI / MISO / DRDY# / RESET# / CLK 六项，
 * 没有 CS —— 即片选在硬件上常接地、器件永远处于选中状态。因此：
 *   · spi_device 配置 spics_io_num = -1（不让 SPI 主机去驱动不存在的片选）；
 *   · 帧边界只能靠「24bit 字的整数倍」保证，故一次采样必须放在同一个 SPI 事务里
 *     连续交换 4 个字 = 一整帧（STATUS+CH0+CH1+CRC，ads_xfer_raw 就是这么做的），
 *     绝不可拆成多次事务，否则帧错位。
 *   · 若上板后读数恒为乱码或固定值，先确认硬件 CS 是否真的接地。
 *
 * ============================================================
 * 上板调试要点（读不到 / 读数不对时按顺序排查）
 * ============================================================
 *   · 【时钟来源】本板 ADC 的 MCLK 由 R27 / R29 两个 0Ω 电阻二选一：
 *       R27 = 由 ESP32 在 IO14(BOARD_PIN_ADC_CLK) 输出 8.192MHz；
 *       R29 = 板载 8.192MHz 有源晶振直接供给。
 *     本驱动默认按「板载晶振」实现——IO14 只配成高阻输入、不输出时钟。
 *     若实焊的是 R27，ADC 就没有时钟：DRDY# 永远不来，ads131m02_read() 会恒返回
 *     ESP_ERR_TIMEOUT。此时需要另行实现 IO14 的 8.192MHz 输出
 *     （LEDC 无法精确产生该频率，建议用 MCPWM 或 RMT 分频）。
 *   · 【通信锚点】复位后读 ID 寄存器，其高字节固定为 0x22（手册复位值 22xxh，
 *     低 8 位“可能变化”）。ID 读不到/高字节不对，说明 SPI 通路或字序有问题。
 *   · 【响应槽位】寄存器访问的响应在「命令帧之后那一帧」的首字（rx[0]）。
 *     若读回值随每次上电变化（像转换数据），说明时钟的字数没凑够整帧、
 *     没走到响应帧——这是本驱动曾踩过的坑，见 ADS_FRAME_WORDS 注释。
 *     需要看原始字时把本文件日志级别开到 DEBUG，ads_read_reg() 会打印帧内原始字。
 *   · 【帧错位】没有 CS 时若帧错位，读出的电压/电流会呈现规律的错位关系。
 *     排查点：MODE 寄存器里的字长设置、是否启用了 CRC。
 *   · 【中断与内存】DRDY ISR 内只做三件事：计数、唤醒消费者（xSemaphoreGiveFromISR）、
 *     重臂 DMA 描述符并启动一帧（内存写 + inline LL，全是 IRAM 安全操作），
 *     不做阻塞调用、不读 flash；且 ISR 与 ads131m02_read() 均不访问 PSRAM
 *     （见 hardware_pinout.md §6 的硬约束）。
 * ============================================================
 */
#include "ads131m02.h"
#include "ads131m02_engine.h"

#include <stdbool.h>
#include <stdint.h>
#include <stdatomic.h>

#include "board_pins.h"

#include "driver/gpio.h"
#include "esp_attr.h"
#include "esp_log.h"
#include "freertos/FreeRTOS.h"
#include "freertos/semphr.h"
#include "freertos/task.h"

/** 日志标签 */
static const char *TAG = "ads131m02";

/* ============================================================
 * SPI 参数（引擎 init 的输入）
 * ============================================================ */
/** 目标 SCLK = 20MHz（M2 正式档；4MHz 为二分实验档已排除 burst 因素）。 */
#define ADS_SPI_CLK_HZ (20 * 1000 * 1000)
/** 从机数据有效延迟（SCLK 沿→MISO 数据有效）：t_p(SCDO) 最大 20ns，供引擎时序补偿 */
#define ADS_SPI_INPUT_DELAY_NS 20

/** 24bit 字长（字节） */
#define ADS_WORD_BYTES 3
/**
 * 一帧 = STATUS + CH0 + CH1 + 输出CRC，共 4 个 24bit 字（12 字节）。
 * ⚠ 手册 §8.5.1.7：输出 CRC **不可关闭、恒在帧尾**（16bit CRC 占第 4 字
 * 高 2 字节，末字节补 0）。此前驱动只读 3 字（漏掉 CRC 字）——无 CS 接法
 * 下一次 DRDY 假边沿/时钟抖动就会让字计数错位，读到 [CH1][STATUS][CH0]
 * 这类错位帧，毛刺值恰为 STATUS 字本身（实测 I 尖峰=0x050300=STATUS<<8），
 * 且错位持续数秒不自愈。整帧 4 字读取 + CRC-16 校验可根治。
 */
#define ADS_FRAME_WORDS 4
/** 输出 CRC 字节覆盖范围：帧前 3 字（STATUS+CH0+CH1）共 9 字节 */
#define ADS_CRC_COVER_BYTES (3 * ADS_WORD_BYTES)

/**
 * 帧同步模型（本驱动所有 SPI 访问都遵守，出问题先看这里）
 *
 * 本器件的**帧边界由 DRDY# 界定**：主机在每个 DRDY 下降沿之后时钟**恰好一帧**
 * （4 个字 = 12 字节）。命令字放在帧的首字，其**响应出现在下一帧的首字**
 * （TI 手册：the device outputs the register contents in the command response
 *   word of the following frame；TI E2E 亦明确"next frame"）。
 *
 * 所以寄存器访问 = 「等 DRDY → 时钟一帧发命令」+「等 DRDY → 时钟一帧读响应」，
 * 见 ads_read_reg() / ads_write_reg() / ads_send_cmd()——引擎的
 * ads_engine_xfer_frame() 把「等 DRDY + 交换一帧」打包成不可分割的一次调用。
 * 流式采样帧由 DRDY ISR 在引擎内直接 kick（M2），消费者只管按序取帧。
 *
 * ⚠ 曾踩的坑：不等 DRDY、一次性时钟两个帧就想一次读完响应。结果帧边界漂移，
 *   读到的"响应"其实是转换数据 —— 表现为读回值随每次上电都不同
 *   （GAIN1 读到 0x0013/0x40A6/0x00A6，ID 读到 0x2818/0x333E）。
 *   而 ads131m02_read()（等 DRDY 后读一帧）一直是对的，正说明帧同步是关键。
 */

/**
 * 并发模型（所有 SPI 访问的串行化规则，出并发问题先看这里）
 *
 * 访问者有两类，且运行期可能并发：
 *   ① ads131m02_read()        —— 测量核高频采样（消费引擎流式帧）；
 *   ② ads_read_reg/write_reg/send_cmd() —— init 写配置 + 运行期诊断/自检读寄存器。
 * 本板无片选，帧边界只靠「DRDY 后时钟整帧」维持（见上）：两路访问一旦
 * 交错时钟，就会互相吞 DRDY、帧错位，读到的值全乱。
 *
 * 规则：**任何 SPI 访问都必须持有 s_bus_mutex**。维护访问（②）在锁内
 * 额外「暂停流式 → 两帧交换 → 恢复流式」（ads_engine_set_stream）：
 *   · 暂停后 DRDY ISR 只打时间戳不再 kick，维护帧独占总线；
 *   · 采样侧取不到锁只丢几帧（4kHz 下一帧 250µs），槽环由引擎计数，
 *     不产生错位；ADS_MUTEX_TIMEOUT_MS 按一次两帧维护访问的最坏持锁取值。
 */

/* ============================================================
 * 命令编码（手册 Table 8-11）
 * ============================================================ */
#define ADS_CMD_NULL   0x0000u /**< 空命令：响应为 STATUS 寄存器 */
#define ADS_CMD_UNLOCK 0x0655u /**< 解锁寄存器写保护（与 LOCK 0x0555 成对） */

/**
 * RREG：格式 101a aaaa annn nnnn
 *   6bit 寄存器地址在 [12:7]，7bit 字数（寄存器个数 - 1）在 [6:0]
 *   （对应本文件宏实现里的 addr << 7 与 n 掩码 0x7F）。
 * @param addr 起始寄存器地址
 * @param n 连续读取的寄存器个数（1 ~ 128）
 */
#define ADS_CMD_RREG(addr, n) \
    (0xA000u | (((uint32_t)(addr) & 0x7Fu) << 7) | (((uint32_t)(n) - 1u) & 0x7Fu))

/**
 * WREG：格式 011a aaaa annn nnnn（位域含义同 RREG）
 * @param addr 起始寄存器地址
 * @param n 连续写入的寄存器个数（1 ~ 128）
 */
#define ADS_CMD_WREG(addr, n) \
    (0x6000u | (((uint32_t)(addr) & 0x7Fu) << 7) | (((uint32_t)(n) - 1u) & 0x7Fu))

/* ============================================================
 * 寄存器
 * ============================================================ */
#define ADS_REG_ID    0x00u /**< 器件 ID（只读，手册典型值见 ADS_DEV_ID_TYPICAL） */
#define ADS_REG_CLOCK 0x03u /**< 时钟/采样率：CH_EN、TBM、OSR[2:0]、PWR[1:0] */
#define ADS_REG_GAIN1 0x04u /**< 增益：CH0 = PGAGAIN0[2:0]（低 3 位），CH1 = PGAGAIN1[2:0]（bit6:4） */
/**
 * CH0(AIN0) = 16x（电流）、CH1(AIN1) = 1x（电压）→ 0x04。
 *
 * ⚠ 两处曾出错，都在此注释固化（依据：手册 §8.6.5 Table 8-18 + 原理图 V2）：
 *
 * 1) 增益编码是**线性表**，不是反向表（手册 Table 8-18 原文）：
 *      PGAGAINn[2:0]: 000b=1, 001b=2, 010b=4, 011b=8, 100b=16, 101b=32, 110b=64, 111b=128
 *
 * 2) **通道接法与直觉相反**（见 01-Hardware/02-上板原理图_V2.pdf）：
 *      AIN0P/AIN0N（CH0）← ISENSE+ / ISENSE-，即**电流**（1mΩ 四端分流器，需 16x）
 *      AIN1P/AIN1N（CH1）← 电压跟随器 U7 输出 / VOUT-，即**电压**（101:1 分压，需 1x）
 *    原理图标注亦印证：电压量程 121V@1x、电流量程 ±75A@16x。
 *
 *    曾误写 0x40（把 CH0 当电压、CH1 当电流），导致电压/电流互换；
 *    还曾误按"反向增益表"写 0x37，把电流通道设成 8x、电压通道设成 128x。
 *
 * CH1 = 000b → 1x（bit6:4）；CH0 = 100b → 16x（bit2:0）=> 0x04。
 */
#define ADS_GAIN1_VALUE 0x0004u
/** 器件 ID 手册典型值；作为本驱动最可靠的通信验证锚点（已上板实测一致） */
#define ADS_DEV_ID_TYPICAL 0x2205u

/* ============================================================
 * CLOCK 寄存器位定义（手册 §8.6.4 Table 8-17，复位值 0x030E）
 *   bit9    CH1_EN / bit8 CH0_EN：两通道均使能；
 *   bit5    TBM：0 = OSR 由 bit[4:2] 决定（1 = Turbo，OSR 固定 64）；
 *   bit[4:2] OSR[2:0]：000=128 / 001=256 / 010=512 / 011=1024（本工程）
 *                      / 100=2048 / 101=4096 / 110=8192 / 111=16384；
 *   bit[1:0] PWR[1:0]：10 = HR（高分辨率，保持复位值 10）。
 *
 * HR 模式 f_MOD = f_CLKIN/2 = 4.096MHz，ODR = f_MOD/OSR = 4000 Hz
 * （本工程档位，恰为芯片复位档；写入值 0x030E = 复位值，仍显式写入并回读
 *   以保证采样率确定）。
 *
 * ⚠ DRDY 抑制机制（SBAS853 §8.5.1.5 原文）：
 *   "The DRDY pulse is blocked when new conversions complete while conversion
 *    data are read."——主机读取窗口跨越转换完成时刻时 DRDY 被抑制。
 *   2026-10 排查实录：当时 4MHz SPI + 任务调度路径下"等 DRDY+读帧"周期约 3ms，
 *   在 4kHz 档（250µs/帧）必然跨越转换完成，DRDY 塌到 ~310Hz；曾以
 *   OSR=8192（ODR=500Hz）加余量绕过。
 *   现方案（M1 基线）：SPI 提到 20MHz + DMA 把读窗压到 µs 级，读窗固定在
 *   DRDY 之后 µs 级启动、远离下一个 250µs 转换完成时刻，从机制上避开抑制
 *   条件，恢复 4kHz。DRDY→SPI 启动延迟 δ 由 ads131m02_get_stats() 实测
 *   （验收 p99≤20µs），频率护栏保证任何自动降档都不影响该预算。
 *   （若实测 ODR 需调整，改 OSR 档位即可：每 +1 档 ODR 减半。）
 * ============================================================ */
#define ADS_CLOCK_CH_EN_MASK  0x0300u /**< CH1_EN | CH0_EN */
#define ADS_CLOCK_OSR_SHIFT   2
#define ADS_CLOCK_OSR_1024    (0x03u << ADS_CLOCK_OSR_SHIFT) /**< OSR[2:0]=011 → 过采样 1024×（= 芯片复位档） */
#define ADS_CLOCK_PWR_HR      (0x02u)                         /**< PWR[1:0]=10 HR */
#define ADS_CLOCK_VALUE       (ADS_CLOCK_CH_EN_MASK | ADS_CLOCK_OSR_1024 | ADS_CLOCK_PWR_HR) /**< 0x030E（恰为复位值） */
/** 配置后的输出数据率（Hz）：4.096MHz ÷ 1024 = 4000Hz（250µs/样本） */
#define ADS_ODR_HZ            4000u

/* ============================================================
 * 时序参数
 * ============================================================ */
#define ADS_RESET_LOW_MS    2   /**< RESET# 低电平保持（手册要求 ≥ 2048·t_CLKIN，
                                 *   8.192MHz 下约 250µs；取 2ms 留裕量） */
#define ADS_POWERUP_MS      50  /**< 复位释放后等待（上电 + 时钟起振） */
#define ADS_CMD_GAP_MS      2   /**< 命令之间留出的间隔 */
#define ADS_DRDY_TIMEOUT_MS 100 /**< 等 DRDY# 超时（一帧 250µs，100ms 为数百倍余量） */
/**
 * 取总线互斥锁超时。
 * 「等 DRDY + 交换帧」整个序列都在锁内（见文件头并发模型），因此一次两帧的
 * 寄存器访问最坏持锁 ≈ 2×ADS_DRDY_TIMEOUT_MS，取 300ms 留裕量；
 * 采样侧取不到锁只丢一帧（4kHz 下一帧 250µs），不构成问题。
 */
#define ADS_MUTEX_TIMEOUT_MS 300

/** 是否已初始化 */
static bool s_initialized = false;
/** SPI 事务互斥锁：读采样与维护访问统一持锁，见文件头并发模型 */
static SemaphoreHandle_t s_bus_mutex = NULL;
/** 采样侧统计（单写者：采样任务；诊断/验收用，δ 统计在引擎侧） */
static uint32_t s_read_ok = 0;      /**< 成功读取帧数 */
static uint32_t s_crc_fail = 0;     /**< CRC 校验失败帧数 */
static uint32_t s_read_timeout = 0; /**< 等帧超时次数（槽满丢帧是瞬态，不计入） */
static uint32_t s_crc_fail_streak = 0; /**< 连续 CRC 失败计数（M3 重同步触发用） */

/** 连续 CRC 失败多少帧判定帧错位并请求重同步（无 CS 下 4 连败即不自愈） */
#define ADS_CRC_RESYNC_AFTER 4u

/** 帧重同步请求（read() 置位、采样循环经 ads131m02_resync_if_needed 消费） */
static atomic_bool s_resync_req = false;

/**
 * @brief 16bit 命令/寄存器值 -> 线上 24bit 字（MSB 对齐）
 */
#define ADS_W(value16) (((uint32_t)(value16)&0xFFFFu) << 8)

/**
 * @brief 把 24bit 码值按二进制补码符号扩展到 32bit
 * @param word24 24bit 原始码值
 * @return 符号扩展后的 32bit 有符号值
 */
static inline int32_t ads_sign_extend24(uint32_t word24)
{
    return (int32_t)((word24 & 0x800000u) ? (word24 | 0xFF000000u) : word24);
}

/**
 * @brief CRC-16/CCITT（手册 §8.3.12 表 8-7 默认多项式）
 *
 * 多项式 x¹⁶+x¹²+x⁵+1（0x1021），初值 0xFFFF，MSB 先入、不反转。
 * 覆盖帧内前 3 字（STATUS+CH0+CH1）共 9 字节；结果与第 4 字高 2 字节比对。
 */
static uint16_t ads_crc16_ccitt(const uint8_t *data, size_t len)
{
    uint16_t crc = 0xFFFFu;
    for (size_t i = 0; i < len; i++) {
        crc ^= (uint16_t)data[i] << 8;
        for (int b = 0; b < 8; b++) {
            crc = (crc & 0x8000u) ? (uint16_t)((crc << 1) ^ 0x1021u) : (uint16_t)(crc << 1);
        }
    }
    return crc;
}

/**
 * @brief DRDY# 处理与帧传输全部在引擎内（M2）：
 *   DRDY ISR 直接 kick 一帧 GDMA 传输（drdy_isr → engine_kick，
 *   见 ads131m02_engine.c）；本文件不再自持 ISR/信号量/传输原语。
 */

/**
 * @brief 交换一帧（4 字 × 24bit）：引擎的「等 DRDY + DMA 传输」一体调用
 *
 * 引擎把「等 DRDY → 启动帧」打包（ads_engine_xfer_frame），帧边界仍由
 * DRDY 界定。本驱动的两帧寄存器协议 = 连续两次本调用（见 ads_read_reg）。
 *
 * @param tx 待发送 4 字（NULL=全 NULL 帧）
 * @param rx 输出 4 字
 * @param word_count 字数（引擎帧长固定 4，参数保留兼容调用方）
 * @return ESP_OK 成功；ESP_ERR_TIMEOUT 等 DRDY 超时
 */
static esp_err_t ads_xfer_raw(const uint32_t *tx, uint32_t *rx, size_t word_count)
{
    (void)word_count;
    return ads_engine_xfer_frame(tx, rx, ADS_DRDY_TIMEOUT_MS);
}

/**
 * @brief 取总线互斥锁（所有 SPI 访问的统一入口，见文件头「并发模型」）
 *
 * @return true 已持锁；false 超时（有其他访问者长时间占用）
 */
static bool ads_bus_lock(void)
{
    /* xSemaphoreTake：申请互斥锁，最多等待 ADS_MUTEX_TIMEOUT_MS 毫秒。
     * pdMS_TO_TICKS 把毫秒换算成 FreeRTOS 的 tick（系统节拍），直接把毫秒数
     * 传进去会算错等待时长。返回 pdTRUE = 拿到锁，pdFALSE = 等待超时。 */
    return xSemaphoreTake(s_bus_mutex, pdMS_TO_TICKS(ADS_MUTEX_TIMEOUT_MS)) == pdTRUE;
}

/** @brief 归还总线互斥锁（与 ads_bus_lock() 成对） */
static void ads_bus_unlock(void)
{
    xSemaphoreGive(s_bus_mutex);
}

/**
 * @brief 读一个寄存器（DRDY 同步的「两帧」访问，维护模式）
 *
 * ⚠ 关键：本器件的帧边界由 DRDY# 界定，主机必须「每个 DRDY 周期时钟恰好一帧」。
 *   事务结构：
 *     帧 N   ：[RREG 命令字][dummy][dummy]       ← 命令放在帧首字
 *     帧 N+1 ：[寄存器内容][dummy][dummy]        ← 响应出现在下一帧的首字
 *   因此分两次事务、各等一次 DRDY（引擎的 xfer_frame 内含等待）。
 *
 *   曾踩的坑：一次性时钟 2 帧（不等 DRDY）→ 帧边界漂移，读到的"响应"是转换数据，
 *   表现为读回值随每次上电变化、ID 读出 0x2818/0x333E 这类非法值。
 *   （TI 手册：the device outputs the register contents in the command
 *     response word of the following frame；TI E2E 亦明确"next frame"。）
 *
 * @param addr  寄存器地址
 * @param value 输出：寄存器值（16bit）
 * @return ESP_OK 成功；ESP_ERR_TIMEOUT 等 DRDY 超时；其他为 SPI 错误
 */
static esp_err_t ads_read_reg(uint8_t addr, uint16_t *value)
{
    uint32_t tx[ADS_FRAME_WORDS] = { 0 };
    uint32_t rx[ADS_FRAME_WORDS] = { 0 };

    /* 维护访问：持锁 + 暂停流式（帧起点/总线独占，见文件头并发模型）。
     * 两帧都完成才放锁，中途任何错误路径都统一在解锁处归还。 */
    if (!ads_bus_lock()) {
        return ESP_ERR_TIMEOUT;
    }
    const bool stream_was_on = ads_engine_set_stream(false);

    /* 帧 N：发 RREG（xfer_frame 内含「等 DRDY」） */
    tx[0] = ADS_W(ADS_CMD_RREG(addr, 1));
    esp_err_t err = ads_xfer_raw(tx, rx, ADS_FRAME_WORDS);
    if (err != ESP_OK) {
        ESP_LOGE(TAG, "RREG 0x%02X 命令帧失败: %s", addr, esp_err_to_name(err));
        goto done;
    }

    /* 帧 N+1：帧首字即寄存器内容 */
    tx[0] = ADS_W(ADS_CMD_NULL);
    err = ads_xfer_raw(tx, rx, ADS_FRAME_WORDS);
    if (err != ESP_OK) {
        ESP_LOGE(TAG, "RREG 0x%02X 响应帧失败: %s", addr, esp_err_to_name(err));
        goto done;
    }

    *value = (uint16_t)(rx[0] >> 8);

    /* 诊断：开 DEBUG 级日志可看到整帧原始字，便于核对 */
    ESP_LOGD(TAG, "RREG 0x%02X -> 0x%04X（响应帧: %06X %06X %06X）", addr, *value, (unsigned)rx[0],
             (unsigned)rx[1], (unsigned)rx[2]);

done:
    ads_engine_set_stream(stream_was_on);
    ads_bus_unlock();
    return err;
}

/**
 * @brief 写一个寄存器（DRDY 同步的「两帧」访问）
 *
 * 帧 N   ：[WREG 命令字][要写入的数据][dummy]   ← WREG 的数据字紧跟命令字
 * 帧 N+1 ：[WREG 应答字][dummy][dummy]
 * 应答字格式 010a aaaa ammm mmmm（mmm mmmm = 实际写入个数 - 1），
 * 借它确认写入真的生效（未解锁时 WREG 会被静默丢弃）。
 *
 * @param addr  寄存器地址
 * @param value 待写入的值（16bit）
 * @return ESP_OK 成功；ESP_ERR_INVALID_RESPONSE 应答格式不符；其他为 DRDY/SPI 错误
 */
static esp_err_t ads_write_reg(uint8_t addr, uint16_t value)
{
    uint32_t tx[ADS_FRAME_WORDS] = { 0 };
    uint32_t rx[ADS_FRAME_WORDS] = { 0 };

    /* 维护访问：持锁 + 暂停流式，两帧完成才放锁 */
    if (!ads_bus_lock()) {
        return ESP_ERR_TIMEOUT;
    }
    const bool stream_was_on = ads_engine_set_stream(false);

    /* 帧 N：发 WREG + 数据（xfer_frame 内含「等 DRDY」） */
    tx[0] = ADS_W(ADS_CMD_WREG(addr, 1));
    tx[1] = ADS_W(value);
    esp_err_t err = ads_xfer_raw(tx, rx, ADS_FRAME_WORDS);
    if (err != ESP_OK) {
        ESP_LOGE(TAG, "WREG 0x%02X 命令帧失败: %s", addr, esp_err_to_name(err));
        goto done;
    }

    /* 帧 N+1：取应答字 */
    tx[0] = ADS_W(ADS_CMD_NULL);
    err = ads_xfer_raw(tx, rx, ADS_FRAME_WORDS);
    if (err != ESP_OK) {
        ESP_LOGE(TAG, "WREG 0x%02X 应答帧失败: %s", addr, esp_err_to_name(err));
        goto done;
    }

    const uint16_t ack = (uint16_t)(rx[0] >> 8);
    /* 应答高 3 位应为 010b（0x4000 段），低 7 位为「写入个数 - 1」= 0 */
    if ((ack & 0xE000u) != 0x4000u || (ack & 0x7Fu) != 0u) {
        ESP_LOGE(TAG, "WREG 0x%02X=0x%04X 应答异常: 0x%04X（应答帧: %06X %06X %06X）", addr, value,
                 ack, (unsigned)rx[0], (unsigned)rx[1], (unsigned)rx[2]);
        err = ESP_ERR_INVALID_RESPONSE;
        goto done;
    }
    ESP_LOGI(TAG, "WREG 0x%02X=0x%04X 已确认（应答 0x%04X）", addr, value, ack);

done:
    ads_engine_set_stream(stream_was_on);
    ads_bus_unlock();
    return err;
}

/**
 * @brief 发送一条无数据命令，并可选取回它在下一帧的响应字
 *
 * @param cmd      16bit 命令码
 * @param response 输出：下一帧首字（高 16bit 对齐）；为 NULL 则不多读一帧
 * @return ESP_OK 成功；其他为 DRDY/SPI 错误
 */
static esp_err_t ads_send_cmd(uint16_t cmd, uint16_t *response)
{
    uint32_t tx[ADS_FRAME_WORDS] = { 0 };
    uint32_t rx[ADS_FRAME_WORDS] = { 0 };

    /* 命令同样是维护访问：持锁 + 暂停流式 */
    if (!ads_bus_lock()) {
        return ESP_ERR_TIMEOUT;
    }
    const bool stream_was_on = ads_engine_set_stream(false);

    /* 帧 N：发命令（xfer_frame 内含「等 DRDY」） */
    tx[0] = ADS_W(cmd);
    esp_err_t err = ads_xfer_raw(tx, rx, ADS_FRAME_WORDS);
    if (err != ESP_OK) {
        ESP_LOGE(TAG, "命令 0x%04X 帧失败: %s", cmd, esp_err_to_name(err));
        goto done;
    }

    if (response == NULL) {
        goto done;
    }

    /* 帧 N+1：响应帧 */
    tx[0] = ADS_W(ADS_CMD_NULL);
    err = ads_xfer_raw(tx, rx, ADS_FRAME_WORDS);
    if (err != ESP_OK) {
        ESP_LOGE(TAG, "命令 0x%04X 响应帧失败: %s", cmd, esp_err_to_name(err));
        goto done;
    }
    *response = (uint16_t)(rx[0] >> 8);

done:
    ads_engine_set_stream(stream_was_on);
    ads_bus_unlock();
    return err;
}

/**
 * @brief 应用寄存器配置序列：UNLOCK → GAIN1 → CLOCK（init 与运行期重同步共用）
 *
 * 提取自 ads131m02_init() 的 ⑦⑨⑩.1：任何需要"重新配置芯片"的路径
 * （初始化、CRC 连败重同步）都走同一份序列，避免两处漂移。
 *
 * @return ESP_OK 全部写入并回读一致；其他=关键寄存器配置失败
 */
static esp_err_t ads_apply_config(void)
{
    /* 解锁寄存器写保护（WREG 前必须，否则写入被静默丢弃） */
    esp_err_t err = ads_send_cmd(ADS_CMD_UNLOCK, NULL);
    if (err != ESP_OK) {
        return err;
    }
    /* vTaskDelay：让当前任务休眠指定 tick 数，休眠期间 CPU 让给其他任务运行；
     * 这里留出芯片处理命令的间隔（ADS_CMD_GAP_MS = 2ms）。 */
    vTaskDelay(pdMS_TO_TICKS(ADS_CMD_GAP_MS));

    /* GAIN1：CH0=16x（电流）/ CH1=1x（电压） */
    err = ads_write_reg(ADS_REG_GAIN1, ADS_GAIN1_VALUE);
    if (err != ESP_OK) {
        ESP_LOGE(TAG, "GAIN1 写入未确认: %s", esp_err_to_name(err));
    }
    vTaskDelay(pdMS_TO_TICKS(ADS_CMD_GAP_MS));

    /* 回读校验 GAIN1（写入未生效如未解锁，这里会暴露） */
    uint16_t gain1_readback = 0;
    err = ads_read_reg(ADS_REG_GAIN1, &gain1_readback);
    if (err != ESP_OK) {
        return err;
    }
    if (gain1_readback == ADS_GAIN1_VALUE) {
        ESP_LOGI(TAG, "GAIN1 写入并回读一致（0x%04X），寄存器访问正常", gain1_readback);
    } else {
        ESP_LOGE(TAG, "GAIN1 回读不一致（回读=0x%04X 写入=0x%04X）", gain1_readback,
                 ADS_GAIN1_VALUE);
    }
    vTaskDelay(pdMS_TO_TICKS(ADS_CMD_GAP_MS));

    /* CLOCK：HR 模式 + OSR=1024 档 → ODR=4000SPS */
    err = ads_write_reg(ADS_REG_CLOCK, ADS_CLOCK_VALUE);
    if (err != ESP_OK) {
        ESP_LOGE(TAG, "CLOCK(采样率) 写入未确认: %s", esp_err_to_name(err));
    }
    vTaskDelay(pdMS_TO_TICKS(ADS_CMD_GAP_MS));

    uint16_t clock_readback = 0;
    if (ads_read_reg(ADS_REG_CLOCK, &clock_readback) == ESP_OK) {
        if (clock_readback == ADS_CLOCK_VALUE) {
            ESP_LOGI(TAG, "CLOCK 回读 0x%04X：HR 模式 OSR=1024 档，ODR=%u SPS", clock_readback,
                     ADS_ODR_HZ);
        } else {
            ESP_LOGW(TAG, "CLOCK 回读 0x%04X 与目标 0x%04X 不符", clock_readback, ADS_CLOCK_VALUE);
        }
    }
    return ESP_OK;
}

/**
 * @brief 运行期重同步（M3 容错）：CRC 连败 → 硬复位 + 重新配置
 *
 * 无 CS 接法下帧错位不自愈（手册 §8.5.1.7），连续 CRC 失败即判定帧边界
 * 已错乱。最小闭环：停流式 → RESET# 硬复位 → 重新应用配置 → 清计数。
 * 仍然失败由调用方再触发（有限次），避免无限复位循环。
 *
 * @return ESP_OK 重同步完成（配置生效）；其他=复位后仍配置失败
 */
static esp_err_t ads_resync(void)
{
    ESP_LOGW(TAG, "帧重同步：RESET# 硬复位 + 重新配置（连续 CRC 失败触发）");
    ads_engine_set_stream(false);

    /* SYNC#/RESET# 低电平 2ms（≥ 手册 2048·t_CLKIN≈250µs）→ 等 POR 完成 */
    gpio_set_level(BOARD_PIN_ADC_RST, 0);
    vTaskDelay(pdMS_TO_TICKS(ADS_RESET_LOW_MS));
    gpio_set_level(BOARD_PIN_ADC_RST, 1);
    vTaskDelay(pdMS_TO_TICKS(ADS_POWERUP_MS));

    const esp_err_t err = ads_apply_config();
    if (err == ESP_OK) {
        ESP_LOGI(TAG, "重同步完成：寄存器配置已恢复");
    }
    return err;
}

esp_err_t ads131m02_init(void)
{
    if (s_initialized) {
        ESP_LOGW(TAG, "已初始化，忽略重复调用");
        return ESP_ERR_INVALID_STATE;
    }

    esp_err_t err = ESP_OK;

    /* ---- ① 同步对象：SPI 事务互斥锁（DRDY 同步由引擎内部处理） ---- */
    /* xSemaphoreCreateMutex：创建一个 FreeRTOS 互斥量，保证同一时刻只有一个任务
     * 能进入「SPI 访问」临界区；同任务重复取锁会死锁（故 read() 内不调 ads_resync）。
     * 返回 NULL 表示堆内存不足。 */
    s_bus_mutex = xSemaphoreCreateMutex();
    if (s_bus_mutex == NULL) {
        ESP_LOGE(TAG, "创建互斥锁失败（内存不足）");
        err = ESP_ERR_NO_MEM;
        goto fail_sync;
    }

    /* ---- ② RESET#(SYNC#) 脚：输出，先保持高（不复位） ---- */
    /* gpio_config 一次性配置一个引脚的默认电平/方向/上下拉/中断：
     *   pin_bit_mask ：位掩码，bit n 对应 GPIO n（1ULL << 引脚号）；
     *   mode         ：GPIO_MODE_OUTPUT = 推挽输出；
     *   pull_up/down ：本脚由驱动外部拉高，不需要内部上下拉；
     *   intr_type    ：主机不用该脚中断，禁用（DRDY 中断在引擎里单独装）。 */
    const gpio_config_t rst_cfg = {
        .pin_bit_mask = 1ULL << BOARD_PIN_ADC_RST,
        .mode = GPIO_MODE_OUTPUT,
        .pull_up_en = GPIO_PULLUP_DISABLE,
        .pull_down_en = GPIO_PULLDOWN_DISABLE,
        .intr_type = GPIO_INTR_DISABLE,
    };
    err = gpio_config(&rst_cfg);
    if (err != ESP_OK) {
        ESP_LOGE(TAG, "RESET# 脚 IO%d 配置失败: %s", BOARD_PIN_ADC_RST, esp_err_to_name(err));
        goto fail_sync;
    }
    gpio_set_level(BOARD_PIN_ADC_RST, 1);

    /* ---- ③ CLKIN 脚：高阻输入（时钟默认由板载晶振供给，见文件头调试要点） ---- */
    const gpio_config_t clk_cfg = {
        .pin_bit_mask = 1ULL << BOARD_PIN_ADC_CLK,
        .mode = GPIO_MODE_INPUT,
        .pull_up_en = GPIO_PULLUP_DISABLE,
        .pull_down_en = GPIO_PULLDOWN_DISABLE,
        .intr_type = GPIO_INTR_DISABLE,
    };
    err = gpio_config(&clk_cfg);
    if (err != ESP_OK) {
        ESP_LOGE(TAG, "时钟脚 IO%d 配置失败: %s", BOARD_PIN_ADC_CLK, esp_err_to_name(err));
        goto fail_sync;
    }

    /* ---- ④ 建 SPI3+GDMA 帧引擎（M2：DRDY ISR 直启） ----
     * ⚠ MISO 时序护栏：t_p(SCDO) 最大 20ns（SBAS853 §6.7），20MHz 半周期
     * 仅 25ns，裕量趋近 0；引擎按 input_delay_ns 做时序补偿，20MHz 下的位错
     * 由 CRC 帧校验兜底（crc_fail 计数即告警），必要时降频重测（4kHz 不受影响）。 */
    err = ads_engine_init(BOARD_PIN_ADC_MOSI, BOARD_PIN_ADC_MISO, BOARD_PIN_ADC_SCLK,
                          ADS_SPI_CLK_HZ, ADS_SPI_INPUT_DELAY_NS);
    if (err != ESP_OK) {
        ESP_LOGE(TAG, "SPI3+GDMA 引擎初始化失败: %s", esp_err_to_name(err));
        goto fail_sync;
    }

    /* ---- ⑤ DRDY# 下降沿中断 ----
     * 必须**早于**任何寄存器访问安装：本器件的帧由 DRDY 界定，
     * 寄存器访问与采样同样「等 DRDY 再时钟一帧」，
     * 否则帧边界漂移、读到的"响应"其实是转换数据（详见 ads_read_reg 注释）。 */
    err = ads_engine_attach_drdy(BOARD_PIN_ADC_DRDY);
    if (err != ESP_OK) {
        ESP_LOGE(TAG, "DRDY# 中断安装失败（IO%d）: %s", BOARD_PIN_ADC_DRDY, esp_err_to_name(err));
        goto fail_sync;
    }

    /* ---- ⑥ 硬复位：RESET# 低脉冲，随后等待上电与时钟起振 ---- */
    gpio_set_level(BOARD_PIN_ADC_RST, 0);
    vTaskDelay(pdMS_TO_TICKS(ADS_RESET_LOW_MS));
    gpio_set_level(BOARD_PIN_ADC_RST, 1);
    vTaskDelay(pdMS_TO_TICKS(ADS_POWERUP_MS));

    /* ---- ⑦⑨⑩⑩.1 应用寄存器配置：UNLOCK → GAIN1 → CLOCK ----
     * 详细序列（含各步取舍）见 ads_apply_config()；init 与运行期重同步
     * （CRC 连败自恢复）共用同一份配置，避免两处漂移。
     * 不发软件 RESET 的原因（依据手册 §8.4.1.3 / §8.5.1.11）：
     *   软件 RESET(0011h) 只在"整帧时钟完整"时才被锁存，帧不完整时器件只会
     *   回显 0011h 且不复位；第⑥步的 SYNC/RESET# 引脚硬复位已经完整完成复位。 */
    err = ads_apply_config();
    if (err != ESP_OK) {
        goto fail_dev;
    }

    /* ---- ⑪ 通信判定：读器件 ID ----
     * 手册 ID 寄存器（00h）复位值标注为 22xxh：高字节（含 CHANCNT）固定为 0x22，
     * 低 8 位为保留位且“可能变化（subject to change）”。因此只校验高字节 0x22，
     * 不把低 8 位写死（早期代码精确比对 0x2205，换硅片版本会误报警告）。 */
    uint16_t dev_id = 0;
    err = ads_read_reg(ADS_REG_ID, &dev_id);
    if (err != ESP_OK) {
        goto fail_dev;
    }
    if ((dev_id & 0xFF00u) == (ADS_DEV_ID_TYPICAL & 0xFF00u)) {
        ESP_LOGI(TAG, "通信验证通过（器件 ID=0x%04X，高字节与手册 0x22 一致）", dev_id);
    } else {
        ESP_LOGW(TAG, "器件 ID 回读 0x%04X，高字节应为 0x22（手册复位值 22xxh），"
                      "排查见文件头调试要点", dev_id);
    }

    /* ---- ⑫ 寄存器体检：把决定"读数怎么解释"的位逐一打印出来 ----
     * 这一步是"核查驱动与硬件是否一致"的依据（对应手册 §8.6）：
     *   MODE(02h)   ：WLENGTH（字长，必须 24bit）、CRC 是否启用（启用则一帧变 4 字）、
     *                 DRDY_SEL / DRDY_FMT（DRDY 行为）；
     *   STATUS(01h) ：WLENGTH 回读、RESET/F_RESYNC（是否发生过复位/重同步）、
     *                 DRDY0/DRDY1（哪些通道有新数据）；
     *   CH0/CH1_CFG ：MUX（必须 00=外部 AIN 输入）、DCBLK（默认关闭）、PHASE；
     *   THRSHLD_LSB ：DCBLOCK[3:0]（0=直流阻断滤波器关闭，本工程读直流必须为 0）。
     * 任何一项与预期不符，都会直接导致"读数不对"，因此开机就查。 */
    {
        uint16_t mode = 0, status = 0, ch0cfg = 0, ch1cfg = 0, thr = 0, gain = 0;
        bool ok = true;
        ok &= (ads_read_reg(0x02u, &mode) == ESP_OK);
        ok &= (ads_read_reg(0x01u, &status) == ESP_OK);
        ok &= (ads_read_reg(0x09u, &ch0cfg) == ESP_OK);
        ok &= (ads_read_reg(0x0Eu, &ch1cfg) == ESP_OK); /* 0x0E = CH1_CFG（0x0A 是 CH0_OCAL_MSB） */
        ok &= (ads_read_reg(0x08u, &thr) == ESP_OK);
        ok &= (ads_read_reg(ADS_REG_GAIN1, &gain) == ESP_OK);
        if (ok) {
            const uint16_t wlen_mode = (uint16_t)((mode >> 8) & 0x03u);
            const uint16_t wlen_stat = (uint16_t)((status >> 8) & 0x03u);
            uint16_t dcblock = (uint16_t)(thr & 0x0Fu);
            uint16_t mux0 = (uint16_t)(ch0cfg & 0x03u);
            uint16_t mux1 = (uint16_t)(ch1cfg & 0x03u);
            /* GAIN1: PGAGAIN1[2:0] = bit6:4（CH1=电压）, PGAGAIN0[2:0] = bit2:0（CH0=电流）
             * 线性编码：000b=1x 001b=2x 010b=4x 011b=8x 100b=16x 101b=32x 110b=64x 111b=128x */
            static const uint16_t gain_lut[8] = { 1, 2, 4, 8, 16, 32, 64, 128 };
            const uint16_t g0 = (uint16_t)(gain & 0x07u);          /* CH0 = 电流 */
            const uint16_t g1 = (uint16_t)((gain >> 4) & 0x07u);   /* CH1 = 电压 */
            /* MODE bit13 = REG_CRC_EN，bit12 = RX_CRC_EN；bit4 = TIMEOUT */
            const bool crc_on = ((mode >> 12) & 0x03u) != 0u;
            ESP_LOGI(TAG, "寄存器体检: MODE=0x%04X(字长=%s CRC=%s 超时保护=%s) "
                          "STATUS=0x%04X(字长=%s DRDY=%u%u) "
                          "GAIN1=0x%04X(CH0电流=%ux CH1电压=%ux) "
                          "CH0_CFG=0x%04X(MUX0=%u) CH1_CFG=0x%04X(MUX1=%u) DCBLOCK=%u",
                     mode, (wlen_mode == 1) ? "24bit" : "非24bit(异常)",
                     crc_on ? "开(一帧4字!)" : "关",
                     ((mode >> 4) & 0x01u) ? "开" : "关",
                     status, (wlen_stat == 1) ? "24bit" : "异常",
                     (unsigned)((status >> 1) & 1u), (unsigned)(status & 1u),
                     gain, gain_lut[g0], gain_lut[g1],
                     ch0cfg, mux0, ch1cfg, mux1, dcblock);
            if (g0 != 4u) {
                ESP_LOGE(TAG, "CH0(电流通道) PGA 增益 = %ux，应为 16x（PGAGAIN0=100b）", gain_lut[g0]);
            }
            if (g1 != 0u) {
                ESP_LOGE(TAG, "CH1(电压通道) PGA 增益 = %ux，应为 1x（PGAGAIN1=000b）", gain_lut[g1]);
            }
            if (wlen_mode != 1 || wlen_stat != 1) {
                ESP_LOGE(TAG, "字长不是 24bit：一帧字数与驱动假设不符，采样数据会错位，"
                              "请把 WLENGTH 改为 01b");
            }
            if (mux0 != 0u) {
                ESP_LOGE(TAG, "CH0 MUX=%u 不是外部 AIN0 输入（应为 00b）", mux0);
            }
            if (mux1 != 0u) {
                ESP_LOGE(TAG, "CH1 MUX=%u 不是外部 AIN1 输入（应为 00b）", mux1);
            }
            if (dcblock != 0u) {
                ESP_LOGW(TAG, "DCBLOCK=%u 非 0：直流阻断滤波器已启用，直流电压/电流会被滤掉，"
                              "本工程读直流必须为 0", dcblock);
            }
            if (crc_on) {
                ESP_LOGE(TAG, "输入/寄存器 CRC 已启用（RX_CRC_EN/REG_CRC_EN）：帧内容与驱动假设"
                              "不同（驱动按 [STATUS][CH0][CH1][输出CRC] 固定 4 字解析），需人工核对");
            }
        } else {
            ESP_LOGW(TAG, "寄存器体检失败（读寄存器出错），跳过");
        }
    }

    /* 开启流式：此后 DRDY ISR 每个边沿直接 kick 一帧（M2 数据面正式启动） */
    ads_engine_set_stream(true);

    s_initialized = true;
    ESP_LOGI(TAG, "初始化完成（SPI3 引擎 mode1 %d Hz，CH0=16x 电流 / CH1=1x 电压，"
                  "ODR=%u SPS，DRDY#=IO%d）",
             ADS_SPI_CLK_HZ, ADS_ODR_HZ, BOARD_PIN_ADC_DRDY);
    return ESP_OK;
fail_dev: /* 设备层错误路径标签（寄存器配置阶段沿用），落回 fail_sync */
fail_sync:
    if (s_bus_mutex != NULL) {
        vSemaphoreDelete(s_bus_mutex);
        s_bus_mutex = NULL;
    }
    return err;
}

esp_err_t ads131m02_read(ads131m02_sample_t *out)
{
    if (out == NULL) {
        return ESP_ERR_INVALID_ARG;
    }
    if (!s_initialized) {
        return ESP_ERR_INVALID_STATE;
    }

    /* 串行化整段「取帧 + 解析」：与维护访问共用同一把锁（见文件头并发模型） */
    if (!ads_bus_lock()) {
        return ESP_ERR_TIMEOUT;
    }

    /* 从引擎消费一帧：DRDY ISR 已直接 kick（M2），这里等信号 + 取槽。
     * 【B8 故障分流】ESP_ERR_INVALID_STATE = 槽满丢帧（瞬态，不计超时统计）；
     * ESP_ERR_TIMEOUT = 等 DRDY 超时（真故障候选，计数供故障判定）。 */
    uint32_t rx[ADS_FRAME_WORDS] = { 0 };
    esp_err_t err = ads_engine_read_frame(rx, ADS_DRDY_TIMEOUT_MS);
    if (err == ESP_ERR_INVALID_STATE) {
        ads_bus_unlock();
        return ESP_ERR_INVALID_STATE; /* 丢帧：透传给调用方区分处理 */
    }
    if (err != ESP_OK) {
        s_read_timeout++;
        ads_bus_unlock();
        return ESP_ERR_TIMEOUT;
    }

    if (err == ESP_OK) {
        /* rx[0] 是 STATUS，rx[1]/rx[2] 为 24bit 补码，rx[3] 高 16bit 为帧 CRC。
         * ⚠ 通道接法与直觉相反（见原理图 V2）：
         *   rx[1] = CH0 = AIN0 = ISENSE± = **电流**
         *   rx[2] = CH1 = AIN1 = 分压/跟随器 = **电压** */
        out->status = (uint32_t)(rx[0] >> 8);
        out->current_raw = ads_sign_extend24(rx[1]); /* CH0 = AIN0 = 电流 */
        out->voltage_raw = ads_sign_extend24(rx[2]); /* CH1 = AIN1 = 电压 */

        /* CRC-16 校验（覆盖帧前 3 字的 9 字节）：错位/损坏帧必须剔除——
         * 毛刺帧的 STATUS 位判据（DRDY0/DRDY1=11b）有 1/4 概率误判为真，
         * 而 CRC 是 16bit，误判率 1/65536，是唯一可靠的帧完整性判据。 */
        uint8_t raw9[ADS_CRC_COVER_BYTES];
        for (int i = 0; i < 3; i++) {
            raw9[i * 3 + 0] = (uint8_t)(rx[i] >> 16);
            raw9[i * 3 + 1] = (uint8_t)(rx[i] >> 8);
            raw9[i * 3 + 2] = (uint8_t)(rx[i]);
        }
        const uint16_t crc_calc = ads_crc16_ccitt(raw9, sizeof(raw9));
        const uint16_t crc_rx = (uint16_t)(rx[3] >> 8); /* 第 4 字高 16bit */
        out->crc_ok = (crc_calc == crc_rx);
        if (!out->crc_ok) {
            s_crc_fail++;
            /* M3 重同步状态机（最小闭环）：连续 4 帧 CRC 错 → 判定帧错位
             * （无 CS 接法下错位不自愈，手册 §8.5.1.7）→ 置重同步请求。
             * ⚠ 不在本函数内直接调 ads_resync()：read() 持有总线锁，而
             * ads_apply_config() 内的寄存器访问函数自带同一把锁，同任务
             * 嵌套取锁即死锁。改为置标志，由采样循环在无锁上下文消费
             * （ads131m02_resync_if_needed）。 */
            if (++s_crc_fail_streak >= ADS_CRC_RESYNC_AFTER) {
                s_crc_fail_streak = 0;
                atomic_store(&s_resync_req, true);
                ESP_LOGW(TAG, "连续 %u 帧 CRC 失败，请求帧重同步", ADS_CRC_RESYNC_AFTER);
            }
        } else {
            s_crc_fail_streak = 0;
        }

        /* 每 4096 帧（≈1s @4kHz）采样一次基线统计（M2 验收观测口）。
         * 【v0.6.3 性能】由 ESP_LOGI 降为 ESP_LOGD：这行每秒一条、走同步 UART，
         * 而读帧路径在 Core1 的采样任务里，串口等待会挤占 DRDY 读取窗口。
         * 默认 log level 为 INFO，故默认**不再输出**；需要验收取数时用
         *   esp_log_level_set("ads131m02", ESP_LOG_DEBUG)
         * 打开即可看到完全相同的字段（app_task 的巡检行也长期提供同一组数据）。 */
        const uint32_t n = ++s_read_ok;
        if ((n & 0xFFFu) == 0u) {
            ads_engine_stats_t es;
            ads_engine_get_stats(&es);
            ESP_LOGD(TAG, "[基线统计] DRDY=%u kick=%u 丢=%u ok=%u crc_fail=%u timeout=%u "
                          "| δ(DRDY→SPI)µs min/avg/max=%u/%u/%u",
                     (unsigned)es.drdy_count, (unsigned)es.kick_count, (unsigned)es.drop_count,
                     (unsigned)n, (unsigned)s_crc_fail, (unsigned)s_read_timeout,
                     es.lat_min_us, es.lat_avg_us, es.lat_max_us);
        }
    }

    ads_bus_unlock();
    return err;
}

esp_err_t ads131m02_resync_if_needed(void)
{
    /* atomic_exchange：原子地「读出旧值 + 写入 false」，即一次性取走请求标志；
     * 采样任务与读帧上下文可能并发，用原子操作可避免重复消费或丢标志。 */
    if (!atomic_exchange(&s_resync_req, false)) {
        return ESP_OK; /* 无请求：常态快速返回 */
    }
    esp_err_t err = ads_resync();
    if (err == ESP_OK) {
        /* 重同步成功恢复流式采样（ads_resync 内部已停流式） */
        ads_engine_set_stream(true);
    } else {
        ESP_LOGE(TAG, "重同步后配置仍失败: %s（保持停流，等待下轮再试）", esp_err_to_name(err));
    }
    return err;
}

uint32_t ads131m02_get_sample_rate_hz(void)
{
    return s_initialized ? ADS_ODR_HZ : 0;
}

void ads131m02_get_stats(ads131m02_stats_t *out)
{
    if (out == NULL) {
        return;
    }
    ads_engine_stats_t es;
    ads_engine_get_stats(&es);
    out->drdy_count = es.drdy_count;
    out->edge_ok = es.kick_count;   /* 语义（M2）：成功 kick 的帧数 */
    out->edge_busy = es.drop_count; /* 语义（M2）：槽满丢弃的帧数 */
    out->read_ok = s_read_ok;
    out->crc_fail = s_crc_fail;
    out->read_timeout = s_read_timeout;
    out->lat_min_us = es.lat_min_us;
    out->lat_avg_us = es.lat_avg_us;
    out->lat_max_us = es.lat_max_us;
}

/** 自检连续采样帧数：全部为 0 才判定"数据无意义"，单帧为 0 属正常 */
#define ADS_SELFTEST_FRAMES 8

esp_err_t ads131m02_selftest(void)
{
    if (!s_initialized) {
        return ESP_ERR_INVALID_STATE;
    }

    /* ---- ① 芯片存在性锚点：ID 寄存器（00h）高字节必须是 0x22 ----
     * 手册复位值 22xxh（高字节含 CHANCNT 固定，低 8 位可变）。
     * 芯片没焊时 MISO 悬空（ESP32 内部弱上下拉下读 0 或随机），
     * ID 读回 0x0000/乱码 → 此处判失败。
     * ⚠ init() 里 ID 不符只告警不失败（兼容硅片版本差异），
     *   但启动自检必须把它当硬失败——这正是"自检通过但测量全 0"的盲区。 */
    uint16_t dev_id = 0;
    esp_err_t err = ads_read_reg(ADS_REG_ID, &dev_id);
    if (err != ESP_OK) {
        ESP_LOGE(TAG, "自检：读 ID 寄存器失败: %s（SPI 通路断或无 DRDY）", esp_err_to_name(err));
        return err;
    }
    if ((dev_id & 0xFF00u) != (ADS_DEV_ID_TYPICAL & 0xFF00u)) {
        ESP_LOGE(TAG, "自检失败：ID=0x%04X 高字节不是 0x22——ADS131M02 缺失/虚焊或 SPI 通路异常",
                 dev_id);
        return ESP_ERR_INVALID_RESPONSE;
    }

    /* ---- ② 寄存器通路可信：GAIN1 回读必须与初始化写入一致 ----
     * init() 写 GAIN1 时若未解锁会被静默丢弃（那里只告警），这里再验一道。 */
    uint16_t gain1 = 0;
    err = ads_read_reg(ADS_REG_GAIN1, &gain1);
    if (err != ESP_OK) {
        ESP_LOGE(TAG, "自检：读 GAIN1 失败: %s", esp_err_to_name(err));
        return err;
    }
    if (gain1 != ADS_GAIN1_VALUE) {
        ESP_LOGE(TAG, "自检失败：GAIN1 回读 0x%04X ≠ 配置 0x%04X（寄存器写入未生效）", gain1,
                 ADS_GAIN1_VALUE);
        return ESP_ERR_INVALID_RESPONSE;
    }

    /* ---- ③ 数据可信度：连续多帧码值不能全 0 ----
     * 芯片在但测量前端未接入（分压/分流器虚焊）时码值恒 0：
     * read() 不报错、旧自检照样通过，但测量数据全是 0——正是待排查现象。
     * 本设备由被测电源供电，正常运行时电压通道必有码值，全 0 即异常。 */
    bool any_nonzero = false;
    for (int i = 0; i < ADS_SELFTEST_FRAMES; i++) {
        ads131m02_sample_t s;
        err = ads131m02_read(&s);
        if (err != ESP_OK) {
            ESP_LOGE(TAG, "自检：第 %d/%d 帧读取失败: %s", i + 1, ADS_SELFTEST_FRAMES,
                     esp_err_to_name(err));
            return err;
        }
        if (s.voltage_raw != 0 || s.current_raw != 0) {
            any_nonzero = true;
            break;
        }
    }
    if (!any_nonzero) {
        ESP_LOGE(TAG, "自检失败：连续 %d 帧电压/电流码值全 0——芯片存在(ID=0x%04X)但测量数据无效，"
                      "排查前端分压 R33/R39、分流器 ISENSE± 是否接入",
                 ADS_SELFTEST_FRAMES, dev_id);
        return ESP_ERR_INVALID_RESPONSE;
    }

    ESP_LOGI(TAG, "自检通过（ID=0x%04X，GAIN1=0x%04X，采样数据非全 0）", dev_id, gain1);
    return ESP_OK;
}

uint32_t ads131m02_drdy_count(void)
{
    ads_engine_stats_t es;
    ads_engine_get_stats(&es);
    return es.drdy_count;
}
