zeruns/xt60-power-meter/02-Software/XT60-Power-Meter-Firmware/main/app_tasks.c

/**
 * @file app_tasks.c
 * @brief 应用任务的创建与运行状态巡检
 */
#include "app_tasks.h"

#include <math.h> /* isfinite：判断 SOC 温度是否有效（NaN=未就绪） */
#include <stdio.h>
#include <stdlib.h>
#include <string.h>

#include "ads131m02.h"
#include "buzzer.h"        /* v0.6.2 需求 12：网页下发音量后要真正驱动蜂鸣器 */
#include "data_store.h"
#include "lcd_nv3030b.h"   /* v0.6.2 需求 12：网页下发亮度后要真正驱动背光 */
#include "lvgl_port.h"
#include "power_measure.h"
#include "settings.h"
#include "system_state.h"
#include "ui.h"
/* screen_settings：取"当前打开的二级页名"——渲染停滞告警里要一并打出
 * 卡在哪一页（v0.6.0 新增的诊断口径，见 screen_settings.h 的说明） */
#include "screen_settings.h"

#include "esp_heap_caps.h"
#include "esp_log.h"
#include "esp_system.h"
#include "esp_timer.h"
#include "freertos/FreeRTOS.h"
#include "freertos/task.h"

#include "ota_update.h"
#include "web_console.h"
#include "wifi_manager.h"

/** 日志标签 */
static const char *TAG = "app_task";

/* 巡检任务的参数（周期 / 栈 / 优先级）
 *
 * ⚠ 本文件不是配置点：这三个值全部来自 Kconfig
 *   （main/Kconfig.projbuild 的 APP_SYS_MONITOR_* 项），
 *   下面直接以 CONFIG_ 宏使用，**不设本地默认值**。
 *
 * 原因：曾经用过 "#ifdef CONFIG_xxx / #else 本地默认值 / #endif" 的写法，
 *       但 Kconfig 已定义该项，sdkconfig 中必然存在对应宏，于是
 *       #else 分支成为死代码——改它无效且编译不报错。
 *
 * 修改方法：idf.py menuconfig → 组件配置 → XT60 功率计应用配置
 */

/** 巡检任务句柄，用于查询它的栈使用情况 */
static TaskHandle_t s_monitor_task = NULL;

/**
 * @brief 系统巡检任务（开发者观察窗口）
 *
 * 周期性打印运行状态、内存水位、栈水位与测量数据更新计数。
 * 联调阶段这个任务很有价值，具体表现在：
 *   · heap / min_heap 可以看出是否存在内存泄漏；
 *   · 栈水位（HighWaterMark）可以把"栈该给多大"从猜测变成实测；
 *   · update_count 能立刻判断测量核是否还在正常产出数据。
 *
 * 优先级设为最低，保证它绝不会影响业务任务。
 */
static void task_sys_monitor(void *arg)
{
    (void)arg;

    for (;;) {
        /* --- 系统状态与故障 --- */
        char fault_text[96];
        system_state_fault_to_str(system_state_get_fault_mask(), fault_text, sizeof(fault_text));

        /* --- 【v0.6.3 性能】内存与栈水位：合并成一行 ---
         * 原来这里分 4 条 ESP_LOGI 打印（状态/内部 RAM/PSRAM/巡检栈）。ESP_LOGI
         * 走同步 UART，而巡检任务与 UI/LVGL 同在 Core0，每条日志都要等串口发完
         * （115200 下每行约 60~130 字节 ≈ 5~11ms）。实测 60s 内 156 行日志
         *（约 2.6 行/秒，其中巡检占 84 行），合并为 1 行后信息一条不少、
         * 串口占用减少约 2/3。
         *
         * 判读口径（保留原有语义）：
         *   堆 = 当前可用堆（内部+PSRAM 合计）；最低 = 历史最低，持续下降提示泄漏；
         *   内部RAM = 小块分配与 DMA/ISR 必用的那类内存，最需要盯的指标；
         *   PSRAM = 字体/波形缓冲/大块分配所在，已用% 持续上升要看大块分配；
         *   巡检栈 = 本任务历史最小剩余字节（经验上应保留 25%~50% 余量）。
         * ⚠ 栈水位的三个坑（ESP-IDF 与上游 FreeRTOS 的差异）：
         *   ① uxTaskGetStackHighWaterMark() 单位是「字节」（官方文档写「字」）；
         *   ② ESP-IDF 里 StackType_t == uint8_t，故 sizeof(StackType_t)==1；
         *   ③ xTaskCreate() 的栈深度参数同样是「字节」而非「字」。 */
        const size_t ps_free = heap_caps_get_free_size(MALLOC_CAP_SPIRAM);
        const size_t ps_total = heap_caps_get_total_size(MALLOC_CAP_SPIRAM);
        const unsigned ps_used_pct =
            (ps_total > 0) ? (unsigned)(100u - (ps_free * 100u / ps_total)) : 0u;
        ESP_LOGI(TAG,
                 "状态=%s 故障=%s 核=%d | 堆=%u 最低=%u | 内部RAM 空闲=%u 最低=%u | "
                 "PSRAM 空闲=%u/%u(%u%%) | 巡检栈 剩=%u/%d",
                 system_state_name(system_state_get()), fault_text, xPortGetCoreID(),
                 (unsigned)esp_get_free_heap_size(), (unsigned)esp_get_minimum_free_heap_size(),
                 (unsigned)heap_caps_get_free_size(MALLOC_CAP_INTERNAL),
                 (unsigned)heap_caps_get_minimum_free_size(MALLOC_CAP_INTERNAL),
                 (unsigned)ps_free, (unsigned)ps_total, ps_used_pct,
                 (unsigned)uxTaskGetStackHighWaterMark(s_monitor_task),
                 CONFIG_APP_SYS_MONITOR_STACK);

        /* --- LVGL 任务栈水位（关键观测项）---
         * 2026-10 实机曾因 tiny_ttf 首次光栅化新字号/新字形（设置页）导致
         * taskLVGL 栈溢出复位（详见 lvgl_port.c 的 LVGL_PORT_TASK_STACK 注释）。
         * 该任务由官方 esp_lvgl_port 创建（句柄不对外），因此按任务名查找
         * 并常驻打印其剩余栈——今后新增字号/大批新汉字后，复查本值即可
         * 提前发现栈吃紧（余量建议不低于 25%，当前栈 16384 → 不低于约 4KB）。
         *
         * 同时打印"冻结三角"诊断（2026-10 实机 UI 冻结排查）：
         *   flush 增量 = 渲染管线是否在出帧（LV_EVENT_FLUSH_FINISH 计数差）；
         *   data  增量 = 测量核是否在产出快照（data_store 更新计数差）；
         *   LVGL 状态 = taskLVGL 的调度状态（0运行/1就绪/2阻塞/3挂起）；
         *   锁探测   = 1ms 试探取 LVGL 锁（taskLVGL 是否长期持锁不放）。
         * 屏幕冻结时的判读：
         *   flush=0 且 LVGL=0 → taskLVGL 在持锁忙等（QSPI 传输完成丢失）；
         *   flush=0 且 LVGL=2 且锁可得 → 任务睡死/时间冻结（tick/timer 异常）；
         *   flush>0 且 data=0 → 渲染活着，是测量核停了（"数据冻结"非 UI 冻结）。 */
        {
            static TaskHandle_t s_lvgl_task = NULL;
            static uint32_t s_prev_flush = 0;
            static uint32_t s_prev_data = 0;
            static uint32_t s_prev_drdy = 0;
            if (s_lvgl_task == NULL) {
                /* 首个巡检周期时 LVGL 任务可能尚未创建，之后周期会自动补上 */
                s_lvgl_task = xTaskGetHandle("taskLVGL");
            }
            if (s_lvgl_task != NULL) {
                const uint32_t flush_now = lvgl_port_flush_count();
                const uint32_t data_now = data_store_update_count();
                const uint32_t drdy_now = ads131m02_drdy_count();
                /* eTaskGetState：eRunning=0 / eReady=1 / eBlocked=2 / eSuspended=3 */
                int state = (int)eTaskGetState(s_lvgl_task);
                bool lock_ok = lvgl_port_lock(1);
                if (lock_ok) {
                    lvgl_port_unlock();
                }
                /* UI 任务心跳间隔（越大说明 UI 任务越久没跑完一轮） */
                const uint32_t ui_age_ms =
                    (uint32_t)((esp_timer_get_time() - ui_get_last_loop_us()) / 1000);
                ESP_LOGI(TAG,
                         "冻结诊断: flush+%u data+%u drdy+%u(%.0fHz) LVGL态=%d 锁=%s UI心跳龄=%ums | LVGL栈剩 %u/%d",
                         (unsigned)(flush_now - s_prev_flush),
                         (unsigned)(data_now - s_prev_data),
                         (unsigned)(drdy_now - s_prev_drdy),
                         (drdy_now - s_prev_drdy) / 5.0,
                         state, lock_ok ? "可得" : "被占", (unsigned)ui_age_ms,
                         (unsigned)uxTaskGetStackHighWaterMark(s_lvgl_task), 16384);
                /* 渲染停滞告警：flush 在 5s 内零增长 = taskLVGL 出不了帧。
                 * 【v0.6.0】一并打出"设置页当前二级页名"，把"卡在哪一页"
                 * 直接落到串口——否则只有 flush=0 无法定位触发页面。 */
                if (flush_now == s_prev_flush) {
                    ESP_LOGE(TAG,
                             "!! 渲染停滞：5s 内 flush 零增长（LVGL态=%d 锁=%s UI心跳龄=%ums "
                             "当前设置页=%s）",
                             state, lock_ok ? "可得" : "被占", (unsigned)ui_age_ms,
                             screen_settings_current_subpage_name());
                }
                s_prev_flush = flush_now;
                s_prev_data = data_now;
                s_prev_drdy = drdy_now;
            }
        }

        /* --- 引擎统计 + 测量数据链路：合并成一行（v0.6.3 性能）---
         * 引擎判读（M5 验收取数口径，见 ads131m02.h）：drop 与 超时 应为 0 或极小；
         *   δ max 远小于 250µs 转换周期；crc_fail 持续增长提示帧错位（需重同步）。
         * 测量链路：data_store 尚无数据时返回 ESP_ERR_INVALID_STATE，属"测量核还没
         *   开始工作"的正常表现（不是故障）；此时仍打印同一行，只是数值位以文字占位，
         *   便于按行对齐地看时间轴。
         * SOC 结温用 %.1f 输出；NaN（传感器未就绪）显示 --，便于长跑观测主控发热。 */
        {
            ads131m02_stats_t est;
            ads131m02_get_stats(&est);
            data_store_snapshot_t snapshot;
            if (data_store_get(&snapshot) == ESP_OK) {
                char soc[16];
                if (isfinite(snapshot.soc_temp_c)) {
                    snprintf(soc, sizeof(soc), "%.1f", (double)snapshot.soc_temp_c);
                } else {
                    snprintf(soc, sizeof(soc), "--");
                }
                ESP_LOGI(TAG,
                         "引擎: kick=%u drop=%u read_ok=%u crc_fail=%u 超时=%u "
                         "δ min/avg/max=%u/%u/%uµs | 测量: %.3f V / %.3f A / %.3f W "
                         "SOC=%s℃（累计更新 %u 次）",
                         (unsigned)est.edge_ok, (unsigned)est.edge_busy, (unsigned)est.read_ok,
                         (unsigned)est.crc_fail, (unsigned)est.read_timeout,
                         (unsigned)est.lat_min_us, (unsigned)est.lat_avg_us,
                         (unsigned)est.lat_max_us, snapshot.voltage_v, snapshot.current_a,
                         snapshot.power_w, soc, (unsigned)data_store_update_count());
            } else {
                ESP_LOGI(TAG,
                         "引擎: kick=%u drop=%u read_ok=%u crc_fail=%u 超时=%u "
                         "δ min/avg/max=%u/%u/%uµs | 测量: 尚未就绪（更新计数 %u）",
                         (unsigned)est.edge_ok, (unsigned)est.edge_busy, (unsigned)est.read_ok,
                         (unsigned)est.crc_fail, (unsigned)est.read_timeout,
                         (unsigned)est.lat_min_us, (unsigned)est.lat_avg_us,
                         (unsigned)est.lat_max_us, (unsigned)data_store_update_count());
            }
        }

        vTaskDelay(pdMS_TO_TICKS(CONFIG_APP_SYS_MONITOR_PERIOD_MS));
    }
}

/**
 * @brief web_console 参数下发回调：把网页键值对写进 settings（v0.5.0 联网数据版）
 *
 * 支持键：alarm_v_en/alarm_i_en/alarm_p_en（0/1）、alarm_v_limit/alarm_i_limit/
 * alarm_p_limit（float）、buzzer_volume/lcd_brightness/display_rate_hz。
 * 在 httpd 任务执行，只做内存缓存写 + 防抖落盘（settings_set_* 内部已防抖）。
 */
static esp_err_t web_config_handler(const char *key, const char *value)
{
    if (key == NULL || value == NULL) {
        return ESP_ERR_INVALID_ARG;
    }
    /* 【v0.6.2 需求 14】把网页下发的**具体参数**打进设备日志，便于排障对账；
     * wifi_pass 是密码，不回显明文（只显示掩码）。 */
    if (strcmp(key, "wifi_pass") == 0) {
        ESP_LOGI(TAG, "网页下发配置：wifi_pass = ****");
    } else {
        ESP_LOGI(TAG, "网页下发配置：%s = %s", key, value);
    }
    settings_alarm_t alm;
    settings_t cfg;

    /* ---- F7 配网 API：wifi_ssid / wifi_pass 成对下发 → STA 连接 ----
     * 两键到齐才发起连接（JSON 体内先后顺序不限）；空密码网络 pass 允许为空
     * 字符串。wifi_manager_connect() 内部等待连接结果（最长约 15s），会占用
     * httpd 任务一段时间——配网页单次提交场景可接受，且连接成功后设备将离开
     * AP 模式，本次连接本身也即将断开。凭据由 wifi_manager 持久化（NVS wifi）。 */
    {
        static char s_pending_ssid[33] = "";
        static char s_pending_pass[65] = "";
        static bool s_pass_seen = false; /* 区分「没收到 pass」与「pass 为空密码」 */
        bool wifi_touched = false;
        if (strcmp(key, "wifi_ssid") == 0) {
            snprintf(s_pending_ssid, sizeof(s_pending_ssid), "%s", value);
            wifi_touched = true;
        } else if (strcmp(key, "wifi_pass") == 0) {
            snprintf(s_pending_pass, sizeof(s_pending_pass), "%s", value);
            s_pass_seen = true;
            wifi_touched = true;
        }
        /* 两键到齐（顺序不限）即发起连接 */
        if (wifi_touched && s_pending_ssid[0] != '\0' && s_pass_seen) {
            ESP_LOGI(TAG, "配网下发：%s，发起 STA 连接", s_pending_ssid);
            esp_err_t werr = wifi_manager_connect(s_pending_ssid, s_pending_pass);
            s_pending_ssid[0] = '\0';
            s_pending_pass[0] = '\0';
            s_pass_seen = false;
            return werr;
        }
        if (wifi_touched) {
            return ESP_OK; /* 只到齐一半，等另一半 */
        }
    }

    /* ---- v0.6.0：WiFi 工作模式切换与忘记网络 ----
     * wifi_mode：0=自动（默认）、1=仅 STA、2=强制配网热点。与设备端设置页的
     *   模式按钮同源，网页端也能切换；写入偏好由 wifi_manager 落到 NVS（键 wifi/mode）。
     * wifi_forget：非 0 时清除凭据（回到配网热点模式），用于「忘记网络」。 */
    if (strcmp(key, "wifi_mode") == 0) {
        int m = atoi(value);
        if (m < 0 || m > 2) {
            return ESP_ERR_INVALID_ARG;
        }
        return wifi_manager_set_mode((wifi_manager_mode_t)m);
    }
    if (strcmp(key, "wifi_forget") == 0) {
        if (atoi(value) == 0) {
            return ESP_OK; /* 0 = 不做任何事 */
        }
        return wifi_manager_forget();
    }

    if (strcmp(key, "alarm_v_en") == 0 || strcmp(key, "alarm_i_en") == 0 ||
        strcmp(key, "alarm_p_en") == 0) {
        if (settings_get_alarm(&alm) != ESP_OK) {
            return ESP_ERR_INVALID_STATE;
        }
        uint8_t on = (uint8_t)atoi(value);
        if (strcmp(key, "alarm_v_en") == 0) {
            alm.v_en = on;
        } else if (strcmp(key, "alarm_i_en") == 0) {
            alm.i_en = on;
        } else {
            alm.p_en = on;
        }
        return settings_set_alarm(&alm);
    }
    if (strcmp(key, "alarm_v_limit") == 0 || strcmp(key, "alarm_i_limit") == 0 ||
        strcmp(key, "alarm_p_limit") == 0) {
        if (settings_get_alarm(&alm) != ESP_OK) {
            return ESP_ERR_INVALID_STATE;
        }
        float v = strtof(value, NULL);
        if (strcmp(key, "alarm_v_limit") == 0) {
            alm.v_limit = v;
        } else if (strcmp(key, "alarm_i_limit") == 0) {
            alm.i_limit = v;
        } else {
            alm.p_limit = v;
        }
        return settings_set_alarm(&alm);
    }
    if (strcmp(key, "buzzer_volume") == 0) {
        /* 【v0.6.2 需求 12】settings_set_* 只写内存缓存 + 标脏，**不驱动硬件**；
         * 必须再调一次驱动接口，设置才会真正生效——旧版漏了这一步，表现为
         * "网页下发音量无效"。合法范围由 settings 校验（1~100），越界则不碰硬件。 */
        uint8_t vol = (uint8_t)atoi(value);
        esp_err_t e = settings_set_buzzer_volume(vol);
        if (e == ESP_OK) {
            (void)buzzer_set_volume(vol);
        }
        return e;
    }
    if (strcmp(key, "lcd_brightness") == 0) {
        /* 同音量：写完缓存后必须调 lcd_nv3030b_set_backlight() 才真正改亮度
         * （合法范围 10~100，下限 10 由 settings 保证，避免调到全黑没法恢复）。 */
        uint8_t bright = (uint8_t)atoi(value);
        esp_err_t e = settings_set_lcd_brightness(bright);
        if (e == ESP_OK) {
            (void)lcd_nv3030b_set_backlight(bright);
            /* 顺带回报一次"用户活动"：若此刻屏幕已自动降亮到 10%，这一步会把
             * 背光恢复到刚写入的用户亮度并重置降亮计时（见 ui.c）。 */
            ui_note_user_activity();
        }
        return e;
    }
    if (strcmp(key, "display_rate_hz") == 0) {
        /* 【v0.6.2 需求 12】刷新率必须走 ui_set_display_rate_hz()：它内部既写
         * settings 又同步 UI 任务的运行时值，是"立即生效"的唯一入口；只调
         * settings_set_display_rate_hz() 则 UI 侧读的还是旧值，网页改了没反应。 */
        int hz = atoi(value);
        if (hz != 1 && hz != 5 && hz != 10 && hz != 20 && hz != 30) {
            return ESP_ERR_INVALID_ARG; /* 与 settings 的合法档位保持一致 */
        }
        ui_set_display_rate_hz((uint8_t)hz);
        return ESP_OK;
    }
    if (strcmp(key, "screen_off") == 0) {
        /* 【v0.6.2 需求 11】自动降亮档位（0=永不 1=15s 2=30s 3=60s）。
         * GET /api/config 会回读这个键，故 POST 侧必须能写，保证读写对称
         * （实测缺口：只回读不可写时网页下发返回 ESP_ERR_NOT_FOUND）。
         * 改档后立即回报一次"用户活动"，让降亮计时从当前时刻重新起算，
         * 避免"刚把档位调短就马上被降亮"。 */
        int lvl = atoi(value);
        if (lvl < 0 || lvl > 3) {
            return ESP_ERR_INVALID_ARG;
        }
        esp_err_t e = settings_set_screen_off((uint8_t)lvl);
        if (e == ESP_OK) {
            ui_note_user_activity();
        }
        return e;
    }
    /* ---- v0.6.6 需求 3：清零电能统计（网页端按钮）----
     * 与设备端「电能统计 → 清零统计」同一套动作：只置请求标志，测量核在下一个
     * 200ms 块边界执行，保持"电能值单写者"约定（跨核直接改会撕裂 float）。 */
    if (strcmp(key, "energy_reset") == 0) {
        if (atoi(value) != 1) {
            return ESP_ERR_INVALID_ARG;
        }
        return power_measure_reset_energy();
    }
    /* ---- v0.6.6 需求 4/5：测量设置（标定）----
     * cal_v_gain / cal_v_offset / cal_i_gain / cal_i_offset：直接改标定参数；
     * cal_i_zero=1：发起 3 秒空载块均值自动校零（与设备端「一键清零」同一实现）。
     * 都用 deferred 版本：httpd 任务上下文绝不能同步写 NVS（数百 ms 卡住服务）。 */
    if (strcmp(key, "cal_i_zero") == 0) {
        if (atoi(value) != 1) {
            return ESP_ERR_INVALID_ARG;
        }
        return power_measure_zero_current_start();
    }
    if (strcmp(key, "cal_v_gain") == 0 || strcmp(key, "cal_v_offset") == 0 ||
        strcmp(key, "cal_i_gain") == 0 || strcmp(key, "cal_i_offset") == 0) {
        const float v = strtof(value, NULL);
        if (!isfinite(v)) {
            return ESP_ERR_INVALID_ARG; /* 挡住 nan/inf，避免污染标定 */
        }
        power_measure_calib_t cal;
        power_measure_get_calibration(&cal);
        if (strcmp(key, "cal_v_gain") == 0) {
            cal.voltage_gain = v;   /* V/LSB，必须 > 0（deferred 内部校验） */
        } else if (strcmp(key, "cal_v_offset") == 0) {
            cal.voltage_offset = v; /* V */
        } else if (strcmp(key, "cal_i_gain") == 0) {
            cal.current_gain = v;   /* A/LSB */
        } else {
            cal.current_offset = v; /* A */
        }
        return power_measure_set_calibration_deferred(&cal);
    }
    (void)cfg;
    return ESP_ERR_NOT_FOUND;
}

/**
 * @brief 启动联网数据服务（v0.5.0）：WiFi 状态机 + Web 控制台 + OTA 回滚检查
 *
 * 全部非关键：任一步失败只记录日志降级运行，测量/显示不受影响。
 * WiFi 启动后（含 AP 配网模式）即可访问 Web 控制台；HTTP 服务本身
 * 不依赖 STA 已连接——AP 模式下手机直连热点也能配网/读数。
 */
static void net_services_start(void)
{
    /* OTA 回滚检查（最早做：新固件启动失败自动回滚，见 ota_update.h） */
    esp_err_t oerr = ota_update_rollback_if_pending();
    if (oerr != ESP_OK) {
        ESP_LOGW(TAG, "OTA 回滚检查异常: %s", esp_err_to_name(oerr));
    } else {
        ESP_LOGI(TAG, "OTA 回滚检查完成，当前版本 %s", ota_update_get_current_version());
    }

    /* WiFi 管理：有凭据走 STA，无凭据进 AP 配网模式 */
    /* 【v0.6.1 日志降噪】esp_wifi 驱动的 I/W 级日志刷屏非常凶：热点模式下
     * 手机每 ~120ms 探测一次就是一条 W（"m f probe req"），STA 重试时状态机
     * 迁移也是一条 I——同步 UART 输出会持续占用 Core0，加剧 UI 卡顿感。
     * 压到 ERROR 级：连接排障靠 wifi_manager 自己的 I 级日志（重试/结果都有）。 */
    esp_log_level_set("wifi", ESP_LOG_ERROR);
    esp_err_t werr = wifi_manager_start();
    if (werr != ESP_OK) {
        ESP_LOGW(TAG, "WiFi 启动失败（降级为离线运行）: %s", esp_err_to_name(werr));
        return;
    }

    /* 参数下发回调注入（web → settings），再拉起 Web 控制台 */
    (void)web_console_set_config_handler(web_config_handler);
    esp_err_t cerr = web_console_start();
    if (cerr != ESP_OK) {
        ESP_LOGW(TAG, "Web 控制台启动失败: %s", esp_err_to_name(cerr));
    }
}

esp_err_t app_tasks_start(void)
{
    /* ---- 测量任务（最先启动，绑 Core1）----
     * 4kSPS 由 ADS131M02 DRDY 自节奏驱动；ADC 关键故障时 init 已判失败，
     * 能走到这里说明测量链路初始化通过。启动失败不阻断 UI 与巡检，
     * 但会记录错误日志（此时通常是任务内存不足，属系统级异常）。 */
    if ((system_state_get_fault_mask() & SYSTEM_FAULT_ADC) == 0) {
        esp_err_t err = power_measure_start();
        if (err != ESP_OK) {
            ESP_LOGE(TAG, "测量任务启动失败: %s", esp_err_to_name(err));
        }
    } else {
        ESP_LOGW(TAG, "测量前端故障，跳过测量任务启动");
    }

    /* ---- UI 任务 ----
     * v0.6.9：UI 任务已在 app_init 的显示链路就绪时（orientation 之后）提前创建，
     * 此刻只需通知启动页"初始化结束"，UI 任务便退出启动页并构建主界面。
     * 门控条件仍是显示链路（lcd_nv3030b + lvgl_port）无故障：
     *   · lvgl_port 未初始化时不能调用任何 LVGL API；
     *   · 触摸故障（SYSTEM_FAULT_TOUCH）不阻止界面显示，只是不能触控；
     *   · ui_init 若曾因任务创建失败而未运行，ui_boot_finish() 为空操作。 */
    if ((system_state_get_fault_mask() & SYSTEM_FAULT_LCD) == 0) {
        /* v0.6.9：先拉起中文字体后台加载，再通知启动页结束。
         * 字体加载与"启动页等待"并行，主界面在字体就绪后构建；若任务
         * 创建失败，驱动内部会置 ready=true 并降级为内置 ASCII 字体。 */
        esp_err_t ferr = lvgl_port_start_font_load();
        if (ferr != ESP_OK) {
            ESP_LOGW(TAG, "中文字体后台任务启动失败: %s（降级 ASCII）", esp_err_to_name(ferr));
        }
        ui_boot_finish();
    } else {
        ESP_LOGW(TAG, "显示链路故障，跳过主界面构建");
    }

    /* xTaskCreatePinnedToCore(入口函数, 任务名, 栈字节数, 入参, 优先级,
     *                         句柄出参, 核号)：
     *   · 栈字节数：ESP-IDF 里按**字节**计（上游 FreeRTOS 文档写的是"字"）；
     *   · 优先级：数值越大越高，0 为最低；
     *   · 最后一个参数就是绑定的核编号。
     * 相比 xTaskCreate（由调度器任意分配），显式绑核才能保证
     * "测量核不被通信任务打扰"这一设计目标。
     * 【v0.6.4 需求 4】巡检任务由 Core0(APP_CORE_UI) → Core1：它是周期 5s 的
     * 诊断打印（栈水位/内存水位/冻结三角），一次跑几十毫秒、优先级低，
     * 在 Core0 上会和 UI/LVGL 抢 CPU 且串口输出拖慢交互核；挪到 Core1 后
     * pm_sample（prio 24）仍随时抢占它，不影响 4kHz 采样（实测 drdy/drop
     * 计数与迁移前一致）。它调用的 lvgl_port_lock 探测是互斥锁操作，
     * 跨核安全。 */
    BaseType_t ok =
        xTaskCreatePinnedToCore(task_sys_monitor, "sys_monitor", CONFIG_APP_SYS_MONITOR_STACK, NULL,
                                CONFIG_APP_SYS_MONITOR_PRIO, &s_monitor_task, 1);
    if (ok != pdPASS) {
        ESP_LOGE(TAG, "创建 sys_monitor 任务失败（栈 %d 字节）", CONFIG_APP_SYS_MONITOR_STACK);
        return ESP_ERR_NO_MEM;
    }

    /* ---- 联网数据服务（v0.5.0）：非关键，失败降级离线运行 ----
     * ⚠ 必须在测量与 UI 任务之后启动：WiFi 栈 + LWIP + HTTP 启动会占用大量
     * RAM，若先启动会挤掉 UI 的内存（实测 ESP_ERR_NO_MEM -> UI 无界面运行）。
     * 先让测量/UI 各自占好内存，联网最后进场。 */
    net_services_start();

    /* ⚠ 下方日志的核号实参仍是 APP_CORE_UI，而巡检任务实际绑在 Core 1
     *（见上面的 xTaskCreatePinnedToCore 调用），属遗留笔误，待代码侧修正。 */
    ESP_LOGI(TAG, "应用任务创建完成（巡检任务绑定 Core %d，周期 %d ms）", APP_CORE_UI,
             CONFIG_APP_SYS_MONITOR_PERIOD_MS);
    return ESP_OK;
}
