zeruns/xt60-power-meter/02-Software/XT60-Power-Meter-Firmware/components/drivers/battery_adc/include/battery_adc.h

/**
 * @file battery_adc.h
 * @brief 电池电压采样驱动（BOARD_PIN_BAT_ADC / IO2）
 *
 * 电路：VBAT -> R32 100kΩ -> IO2 -> R38 100kΩ -> GND，为 1:1 分压，
 * 因此实际电池电压 = 引脚电压 × BOARD_BAT_ADC_DIVIDER_RATIO(=2)。
 * 建议多次采样取均值，并按实际分压电阻误差引入标定系数。
 *
 * 实现要点（详见 src/battery_adc.c）：
 *   使用官方 esp_adc 单次采样 + 校准曲线（硬件支持时）或线性拟合兜底，
 *   内部做 16 次均值；输出已按分压比与标定系数换算成电池端电压。
 */
#pragma once

#include "esp_err.h"

/**
 * @brief 初始化电池采样通道（ADC 单次采样模式）
 * @return ESP_OK 成功
 */
esp_err_t battery_adc_init(void);

/**
 * @brief 读取电池电压
 * @param voltage_mv 输出：电池电压（毫伏），不可为 NULL
 * @return ESP_OK 成功；ESP_ERR_INVALID_STATE 未初始化
 */
esp_err_t battery_adc_read(uint32_t *voltage_mv);
