zeruns/xt60-power-meter/(commit log)

2026-03-04 docs: 添加硬件数据手册并更新README标题
    添加ADS131M02和ESP32-S3系列的数据手册文档
    将README中的项目标题从"or"改为"/"以更准确描述功能
2026-03-05 docs: 添加模数转换器相关规格文档
    添加了三个模数转换器相关的规格文档，包括术语表、ADS131M02中文版机翻文档和ADS131M04评估模块文档
2026-03-09 docs: 将许可证从MIT更改为CERN OHL v2
    更新项目许可证为CERN开放硬件许可证v2强互惠版本，以更好地适应硬件相关项目的需求。新许可证对衍生作品的共享有更严格的要求，并明确了修改版本的发布条件。
2026-10-08 docs(数据手册): 添加多个电源芯片数据手册文档
    添加TPS2116、TLV62084、SY8511BADC等电源芯片的英文及中文版数据手册文档
2026-10-08 新增屏幕资料
    [TK018F3716机构图.dwg]
2026-10-08 docs(数据手册): 规范化数据手册文件命名并补充资料
    - 统一命名为「型号_描述_文档类型_语言[_立创编号].pdf」格式，去除无效的 WJ 文档编号
    - 屏模组资料目录更名为 TK018F3716_1.83寸LCD模组资料，内部例程/图纸同步规范
    - 新增 AHT20 温湿度传感器规格书、TI ZHCA068 模数转换术语表
    - 新增《_命名规范.md》记录命名规则
    [TK018F3716_机构图.dwg]
2026-10-08 chore(生产文件): 新增下板与上板 BOM 生产文件
    - 下板 6 项器件、上板V1 62 项、上板V2 61 项，均含立创商城编号与单价
    - 规格列按采购标准补全：类别/型号/封装/关键参数（精度、功耗、耐压等）
    - 单价为立创商城商品页现价（2026-09-16 查询），价格列含数量×单价合计公式
    [01-上板_V1-BOM.xlsx, 01-上板_V2-BOM.xlsx, 01-下板-BOM.xlsx]
2026-10-08 feat(外壳设计): 新增外壳 SolidWorks 设计与 PCB STEP 模型
    - 外壳装配体：上盖 + 中框（3D 打印件）
    - PCB 参考模型：下板/上板V1 STEP（2026-09-20 导出）
    - 原始 STEP 单文件 55MB 超 Gitee 单文件限制，已加入 .gitignore，以 PCB模型.zip（10.8MB）入库
    - .gitignore 增加 SolidWorks 锁定临时文件（~$*）过滤规则
    [上盖.SLDPRT, 中框.SLDPRT, 外壳装配体.SLDASM]
2026-10-08 feat(硬件工程): 新增立创EDA工程文件与原理图PDF
    - 立创EDA专业版工程（.epro2）：下板/上板V1/上板V2
    - 下板、上板V1、上板V2 原理图 PDF 导出件
2026-10-08 feat(外壳设计): 外壳结构迭代并新增底盖零件
    - 新增底盖.SLDPRT，外壳由上盖+中框+底盖三件式组成
    - 上盖、中框、装配体同步更新（适配板厚与热熔螺母孔位）
    [上盖.SLDPRT, 中框.SLDPRT, 外壳装配体.SLDASM, 底盖.SLDPRT]
2026-10-08 chore(生产文件): 新增 PCB Gerber、贴片辅助文件与外壳 3D 打印文件
    - 01-PCB：下板/上板V1/上板V2 Gerber 压缩包（2026-09-22 导出）
    - 02-贴片：各板贴片坐标(positions)、位号图 PDF、交互式BOM 焊接辅助页
    - 03-外壳3D打印文件：上盖/中框/底盖 3MF 及合并打印文件
    [02-上板_V1-positions.xlsx, 02-上板_V2-positions.xlsx, 02-下板-positions.xlsx, 上盖.3MF, 中框.3MF, 合并打印.3mf, 底盖.3mf]
2026-10-08 chore(生产文件): BOM 单价按立创订单成交价更正
    - 下板/上板V1/上板V2 三份 BOM 的单价统一更正为订单实际成交价
    - 上板V1 恢复总价行 SUM 公式，下板/上板V2 同步重算总价
    - 未直购的 C105226 按替代料 C7432764 成交价 0.8275 元计
    [01-上板_V1-BOM.xlsx, 01-上板_V2-BOM.xlsx, 01-下板-BOM.xlsx]
2026-10-08 feat(外壳设计): 上盖结构迭代并更新 3D 打印文件
    - 上盖模型修改（配合 LCD 沉台与热熔螺母孔位）
    - 重新导出 3D 打印文件：上盖.3MF、底盖.3mf、合并打印.3mf
    - 外壳装配体同步更新
    [上盖.3MF, 上盖.SLDPRT, 合并打印.3mf, 外壳装配体.SLDASM, 底盖.3mf]
2026-10-08 feat(生产文件): 上板改版 V2.1 并更新 Gerber、钢网与 BOM
    - Gerber 上板 V2 → V2.1（板框 90×38mm 不变，移除旧版压缩包）
    - 新增手工焊接用钢网：上板V1/上板V2 钢网文件
    - 上板V1/上板V2 BOM 同步更新
    [01-上板_V1-BOM.xlsx, 01-上板_V2-BOM.xlsx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]
2026-10-08 feat(生产文件): 上板 V1 改版 V1.1 并更新工程与原理图
    - Gerber 上板 V1 → V1.1（板框 90×38mm 不变，移除旧版压缩包）
    - 立创EDA工程与上板V1/V2 原理图 PDF 同步更新
    - 合并打印.3mf 同步调整
    [合并打印.3mf]
2026-10-08 docs(硬件): 添加上下板原理图、外壳设计与生产文件
    - 硬件：上板原理图 V1/V2、下板原理图及立创EDA工程
    - 外壳设计：外壳装配体、PCB 3D 模型与打印模型文件
    - 生产文件：PCB 钢网、贴片位号图与交互式 BOM
    [3D_上板_V1_2026-09-20.step, 3D_下板_2026-09-20.step]
2026-10-08 feat(固件): 添加 XT60 功率计 ESP32-S3 固件工程
    - 基于 ESP-IDF v5.5 的初始固件工程，目标芯片 ESP32-S3
    - 实现 GPIO39 LED 周期闪烁（500ms 翻转）并打印状态日志
    - 控制台配置走 USB-Serial/JTAG，烧录与日志共用 COM5
2026-10-08 feat: 完成 XT60 功率计固件基础架构搭建
    - 新增全部驱动、中间件、服务组件的 CMakeLists.txt
    - 新增各模块头文件接口骨架与核心实现
    - 配置 ESP-IDF 项目分区表与默认 sdkconfig
    - 完成双核任务编排与状态机、板级支持层实现
    [3D_上板_V1_2026-09-20.step, 3D_下板_2026-09-20.step, partitions.csv]
2026-10-08 feat(固件): 实现事件总线与跨核数据仓库
    - 事件总线：FreeRTOS 队列 + 静态订阅表 + 独立分发任务；
    分发时先把回调复制到局部数组、再在临界区外调用，避免回调内部
    再次订阅时自锁死锁
    - 数据仓库：用 seqlock 实现无锁快照，解决测量核 1kHz 写入与
    交互核 30Hz 读取之间的数据撕裂问题（读到的字段不会新旧混搭）
2026-10-08 feat(固件): 实现系统状态机、状态指示灯与蜂鸣器驱动
    - 状态机：改用故障位图自动推导状态，新增降级（DEGRADED）态；
    状态变化通过事件广播，切断了对驱动层的直接依赖（方案 B 依赖倒置）
    - 指示灯：改用 esp_timer 步进式闪烁，不再单独占用任务；
    新增"双闪+长灭"模式以区分降级与正常运行
    - 蜂鸣器：LEDC 输出 4kHz 方波驱动无源蜂鸣器，支持提示音与周期报警；
    响度由编译期常量改为运行时可调变量（Kconfig 降级为出厂默认值）
    - 引脚定义补充蜂鸣器驱动极性与 LEDC 资源分配说明
2026-10-08 feat(固件): 添加配置持久化与设备输出控制服务
    - settings：NVS + 内存缓存 + 防抖落盘三层结构；UI 滑块连续调节时
    只在停止改动 1.5 秒后写一次 Flash，避免加速 NVS 磨损；
    NVS 异常时自动擦除重建，仍失败则用出厂默认值降级运行
    - device_ctrl：订阅系统状态事件驱动指示灯与蜂鸣器；
    初始化时恢复用户保存的响度；为 UI 提供音量读写与立即落盘接口
2026-10-08 feat(固件): 添加应用入口、双核任务编排与分级容错初始化表
    - 启动流程改为初始化表驱动，按故障位区分关键/非关键模块：
    关键模块失败时进入 FAULT 状态但不复位，避免单个外设损坏导致
    无限重启而无法通过串口或 OTA 救回；非关键模块失败仅降级运行
    - 移除 ESP_ERROR_CHECK，改为登记故障位并继续启动
    - 任务统一用 xTaskCreatePinnedToCore 显式绑核，巡检任务增加
    栈水位与堆水位观测；修正栈水位单位（IDF 返回字节而非字）
    [app_init.c, app_init.h, app_tasks.c, app_tasks.h, main.c]
2026-10-08 build(固件): 按 N16R8 调整构建配置与分区表，启用崩溃转储
    - Flash 改为 QIO @80MHz：QIO 只与"八线 Flash"互斥，与八线 PSRAM
    不冲突（两者分时复用数据线，靠片选区分），读带宽较 DIO 翻倍
    - CPU 240MHz、指令/数据缓存 32/64KB、编译优化改为 -O2；
    WiFi 与 LWIP 缓冲改放 PSRAM，为测量与 DMA 腾出内部 RAM
    - 分区表改为双 4MB OTA + 64KB coredump + 8MB storage，正好用满 16MB
    - 启用崩溃转储落 Flash 与 panic 后 3 秒复位延时，
    便于野外设备无串口时的故障取证
    - 修正 3 个在 IDF v5.5 中已更名的配置项，消除 "was replaced" 警告
    [partitions.csv]
2026-10-08 test(固件): 添加功率换算纯逻辑模块与主机单测
    - power_calc 不依赖任何 ESP-IDF 头文件与硬件，可在 PC 上直接编译；
    覆盖最容易出错且上板难发现的点：24 位补码符号扩展（负值易被误读为
    接近满量程的正值）、标定换算、功率与电能积分（含单位换算）、
    双向电流的超限保护
    - 附主机测试脚本，自动寻找编译器；无编译器时友好跳过而非报错
2026-10-08 docs(固件): 添加架构设计文档并补充引脚分配说明
    - 新增 architecture.md：分层与依赖规则、状态机与故障位模型、
    启动分级容错、双核分工、seqlock 原理、配置模型（编译期/运行时两层）、
    诊断手段、ISR 与内存约束
    - hardware_pinout.md 补充总线分配建议与中断/PSRAM 使用约束
2026-10-08 chore: 补充忽略规则，排除 IDE 工作目录与厂商例程临时解压目录
    - 忽略 .trae/（Trae IDE 本地分析文档与会话产物）
    - 忽略 example_extracted/ 与 example_stm32_extracted/（数据手册中厂商例程压缩包的临时解压目录，原压缩包仍保留入库）
2026-10-08 feat(固件): 实现按键、电池ADC、温湿度、加速度计、测量前端与LCD/触摸驱动
    - 补齐全部外设驱动源码：button、battery_adc、aht20、imu_sc7a20h、ads131m02（此前仅有头文件骨架），并完善头文件接口与组件依赖声明
    - 新增 lcd_nv3030b 驱动：基于 esp_lcd + 官方 esp_lcd_spd2010 组件，QSPI 30MHz 驱动 240x284 IPS 面板（MADCTL 硬旋转为 284x240 横屏），RGB565 big-endian，含背光控制与 flush 完成回调；通过 idf_component.yml 声明托管依赖
    - 新增 touch_cst816d 电容触摸驱动（I2C 地址 0x15，含竖屏到横屏的坐标变换）
    - bsp 新增传感器 I2C1 总线初始化（SCL=IO21/SDA=IO47）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
2026-10-08 feat(固件): 集成精简版 LVGL v9.6 与适配层，嵌入子集化中文字体
    - vendor 入库裁剪后的 LVGL v9.6.0 源码（仅保留 sw 渲染后端、tiny_ttf、widgets 与 widgets demo；删除 vg_lite/ThorVG/SDL/nanovg 等平台后端、内置 CJK/dejavu 字体及无用 libs，约 34MB 精简至 15.5MB），作为本地组件避免组件管理器重名拉取
    - 新增 lvgl_port 适配层：284x240 横屏显示 flush（RGB565 big-endian，单缓冲 PARTIAL，基于 SPI 传输完成回调通知 flush_ready 防撕裂）、CST816D 触摸坐标变换接入、esp_timer 心跳、互斥锁，预建 12/14/16/20/24/32/40px 共 7 档字体
    - 中文字体方案：启用 LV_USE_TINY_TTF，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
2026-10-08 feat(固件): 添加启动画面与 widgets 演示，完善分级初始化、硬件自检与 UI 任务门控
    - 新增 ui 服务：白底启动画面（40px 标题 XT60功率计、博客副标题、固件版本号，flex 居中自适应横竖屏），3 秒后进入 LVGL widgets demo 验证显示与触控；界面在 UI 任务内构建
    - app_init 启动表扩充为 15 步，新增按键、电池ADC、AHT20、SC7A20H、ADS131M02、LCD、触摸、lvgl_port 初始化；初始化后执行硬件自检（真实读数据验证），按故障位区分致命与降级
    - app_tasks 新增 UI 任务门控：仅显示链路无故障时启动，触摸故障不阻止界面，UI 启动失败降级为无界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
    [app_init.c, app_tasks.c, ui.c, ui.h]
2026-10-08 build(固件): 新增 LVGL 默认配置并入库组件依赖锁文件
    - sdkconfig.defaults：RGB565 大端像素格式、widgets demo、sysmon 性能监视器、tiny_ttf 中文字体与字形/字偶距缓存、LVGL 内存池加大至 128KB（默认 64KB 跑 demo 会内存断言挂死），并补充 ESPBAUD=921600 烧录波特率说明
    - dependencies.lock 入库：锁定 esp_lcd_spd2010 等托管组件版本，保证换机器可复现同一依赖
2026-10-08 docs(固件): 更新架构设计与硬件引脚分配文档
    - 架构文档：补充 LVGL vendor 入库与组件管理器托管两类第三方依赖的归属规则、15 步启动表与故障位分级、硬件自检流程、显示链路与中文字体方案说明
    - 引脚文档：补充 LCD QSPI、背光、CST816D 触摸及新增传感器的引脚分配
2026-10-09 fix(固件): 修正 ADC 增益编码并重构测量页/波形页与交互体验
    测量准确性:
    - ads131m02: 修正 GAIN1 增益编码错误。TI 增益表为反向编码(0000=128x...0111=1x)，原 0x40 实际配置成 CH0=128x/CH1=8x，导致电压通道满幅削顶、电流偏差 2 倍；改为 0x37(CH0=1x 电压/CH1=16x 电流)，上板诊断确认 V/I/P 自洽
    - power_measure: 直流量改用块内平均(原 RMS 系统性偏大)；STATUS DRDY 帧有效性校验并统计丢弃率(超 50% 自动降级)；4 点滑动平均+一阶低通显示平滑；电能按实际接受样本数积分；每 5s 输出原始码诊断日志
    - 新增 fs_storage 组件：SPIFFS 挂载与字体镜像(FLASH_IN_P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
    [ads131m02.c, ads131m02.h, app_init.c, app_tasks.c, button.c, button.h, button_fsm.c, button_fsm.h]
2026-10-09 fix: 修正ADS131M02通道与增益配置，修复测量值互换问题
    本次提交修复了ADS131M02驱动的关键错误：
    1. 修正通道分配：AIN0为电流通道（16x增益）、AIN1为电压通道（1x增益），与硬件原理图V2实际接法一致，解决了电压电流测量值互换的问题
    2. 修正增益编码：使用TI手册的线性增益表，替换之前错误的反向增益表配置值0x37为正确的0x04
    3. 补充驱动寄存器校验与日志，便于后续调试
    4. 同步更新驱动代码、头文件注释及UI测量页布局，适配新的通道定义
    5. 优化AHT20温湿度传感器的读取逻辑，增加失败计数与恢复提示
    6. 调整UI导航栏与测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
    [ads131m02.c, ads131m02.h, power_measure.c, ui_nav.c]
2026-10-12 build(固件): 迁移至 ESP-IDF v6.1 并改用官方组件管理器托管 LVGL
    ESP-IDF v6.1 适配：GPIO_ISR_IRAM_SAFE 更名为 GPIO_CTRL_FUNC_IN_IRAM；coredump 数据格式/校验改为由 ESP_COREDUMP_ENABLE 自动 select；修正 LCD 复位脚被应用与 esp_lcd 重复配置引发的 GPIO[7] 冲突告警。
    LVGL 图形库与移植层改用 ESP 官方组件：声明 lvgl/lvgl 9.6.0~1 与 espressif/esp_lvgl_port 2.9.0（idf_component.yml 声明、dependencies.lock 锁定），移除 vendor 入库的 LVGL 源码。
    lvgl_port 重构为基于官方 esp_lvgl_port：LVGL 内核/任务/心跳/锁/显示注册交由官方负责；保留中文字体（SPIFFS→PSRAM）、自研触摸输入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
    [app_init.c, button.c, button.h, button_fsm.c, button_fsm.h, lcd_nv3030b.c, lcd_nv3030b.h, ui.c]
2026-10-12 fix(固件): 按数据手册校验并完善 ADS131M02/AHT20/SC7A20H 驱动
    ADS131M02：删除在 3 字帧下无法被锁存的软件 RESET 命令（依据手册 RESET 需整帧时钟，引脚硬复位已等效完成）并更正注释；器件 ID 由精确比对 0x2205 改为按手册复位值 22xxh 只校验高字节 0x22，避免换硅片版本误报。
    AHT20：新增与 ESP-IDF 解耦的纯逻辑 aht20_calc（CRC8 初值0xFF/多项式0x31、湿度量程钳制），读数增加 CRC8 校验，校验不过返回 ESP_ERR_INVALID_CRC；湿度按物理量程 0~100%RH 钳制。
    SC7A20H：更正 HR 位注释（HR 位于 CTRL_REG0/1Fh bit0，CTRL_REG4 bit3 实为 DLPF0），写入值不变。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
    [ads131m02.c, aht20.c, aht20_calc.c, aht20_calc.h, imu_sc7a20h.c]
2026-10-14 chore(repo): 完善忽略规则，排除解析临时产物与工具生成副本
    MinerU 文档解析的 _mineru_* 临时目录、Trae HTML 分享包副本、LVGL PC 模拟器 build/out 构建产物不入库；保留原始数据手册、模拟器源码与文档。
2026-10-14 fix(测量): 采样与电能统计改墙钟驱动，修复实测帧率下刷新停滞与电能误差
    本板 ADC 实际 DRDY 约 320Hz（标称 4kHz，时钟硬件问题）：
    - 快速显示子窗口改为墙钟 25ms 强制输出一帧即时均值，UI 恒定 40Hz
    有数据，不再依赖样本数累积（原方案被拖到约 2.6Hz 导致首页数据不动）
    - 电能/运行时间 dt 改真实墙钟，修正按标称帧率折算约 13 倍的误差
    - 电能清零改 atomic 请求、块边界消费，保持测量核单写者
    - ads131m02 增加 DRDY 边沿计数诊断接口
    - imu_sc7a20h 平放时显式返回 FLAT，不再误判为竖屏触发误旋转
    - app_tasks 增加冻结诊断巡检行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
    [ads131m02.c, ads131m02.h, app_init.c, app_tasks.c, imu_sc7a20h.c, imu_sc7a20h.h, power_measure.c, power_measure.h]
2026-10-14 fix(显示): QSPI 时钟降档并固定面板方向，消除刷屏失锁与渲染挂起
    - QSPI 写显存时钟 30MHz→20MHz：30MHz 持续刷屏数秒后面板失锁
    （ESP_OK 但 GRAM 不更新），信号完整性裕量不足，实测 20MHz 稳定
    - 运行期不再向面板写 MADCTL 方向命令：命令与颜色 DMA 并发会丢失
    传输完成回调、渲染永久挂起（UI 冻结但按键蜂鸣正常），
    方向切换全部改由 LVGL 软件旋转实现，面板方向永久固定 0x68
    [lcd_nv3030b.c]
2026-10-14 feat(ui): 横竖屏自适应布局与旋转触控映射修复
    显示/触控：
    - 显示格式改 RGB565 + swap_bytes（lv_draw_rotate 不支持 SWAPPED，
    旋转输出为垃圾内存导致 90°/180°/270° 花屏）；修正 esp_lvgl_port
    180° 旋转宽高/stride 传参错误
    - 触控 read_cb 只做与旋转无关的玻璃→面板物理坐标校准，各角度
    物理→逻辑旋转交给 LVGL 内置 lv_display_rotate_point（与 flush
    软件旋转精确互逆），修复此前按档位自映射被 LVGL 二次旋转导致的
    触摸反向/与显示差 180° 问题
    - 角度 API（0/90/180/270°）与四方向触摸映射、设置页角度按钮
    界面：
    - 启动页/测量页/波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
2026-10-14 feat(旋转): 新增重力自动旋转服务（SC7A20H 姿态判定）
    按 IMU 重力方向判定握持姿态，防抖确认后切换显示与触摸方向；
    支持开机恢复手动角度、自动/手动模式切换与持久化（settings）。
2026-10-14 build(字体): 新增字形缺字审计工具，子集自动扫描 UI 源码字符
    audit_glyphs.py 比对 UI 源码字符与字体子集 cmap（当前 0 缺失）；
    make_fonts.py 内置扫描 UI 源码字符并自动进子集，新文案无需手工补字。
2026-10-14 build(tools): 新增 LVGL 源码级 PC 模拟器与开发辅助脚本
    tools/ui_sim：与真机同源 LVGL/字体/UI 代码的 headless 模拟器，
    27+ 场景可执行验收流程（触摸文本语义查找、多方向截图、BMP→PNG），
    用于烧录前 UI 走查与回归；构建产物已由 .gitignore 排除。
    tools/mcp：ESP-IDF MCP 服务器启动脚本。
    build_fw.bat / flash_fw.bat：一键构建与烧录快捷脚本。
2026-10-14 build(字体): 重建 TTF 子集，补充四方向箭头等 UI 字形
    电流方向箭头改随屏幕角度自适应（右/下/左/上），子集重新生成并
    经 audit_glyphs 校验 0 缺字。
2026-10-14 docs(固件): 归档功耗/性能优化方案调研文档
2026-10-14 fix(驱动): ADS131M02 自检补芯片存在性校验，OSR 提档抑制丢帧与噪声
    - 启动自检改用 ads131m02_selftest()：ID 高字节 0x22 通信锚点 + GAIN1
    写读一致 + 连续 8 帧非全 0 三道闸门，杜绝「芯片缺失/测量前端未接入
    却自检通过（测量全 0）」的盲区。
    - CLOCK 寄存器 OSR 由 1024 档提至 8x 档（ODR 4k→500SPS）：每样本
    过采样 8 倍降低噪声；拉长转换周期（2ms/帧）使主机读取有余量避开
    转换完成时刻，缓解 SBAS839 §8.5.1.5 所述「读取期间转换完成导致
    DRDY 被抑制」（PCNT 硬件计数实证：读取活动使 DRDY 从 3.9kHz 塌至
    ~310Hz）。实测丢帧率 7~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
    [ads131m02.c, ads131m02.h, app_init.c]
2026-10-14 feat(波形): 数据层时间槽桶聚合重构，显示快照改掐头去尾平均
    - wave_point_t 增加采样时间戳 t_ms；窗口映射改按真实时长（win_ms），
    槽位映射与采样率解耦（修复"未占满刷新慢、占满飞快"的时间尺度问题）。
    - ring_fill_slots_locked 改桶聚合：每槽聚合时段内样本取均值，空桶
    线性插值 + 末端前向保持（≤2 桶）——修复 tier1 采样间隔（40ms）与
    槽宽（41.7ms）不同步导致的"断续竖条碎片"。
    - 显示快照子窗口改掐头去尾均值（去最大最小各一），抵御 ADC 坏帧尖峰
    拉偏显示值（实测稳定 10V 下电压码值偶发近零尖峰，单帧平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
    [power_measure.c]
2026-10-14 feat(波形): 波形页重构——黑底亮线、min/max 包络、量程滞回
    - 背景改示波器风格黑底（COL_WAVE_BG #0A0E14）+ 暗灰格线 + 亮色曲线
    （CH1 绿/CH2 蓝/CH3 橙/CH4 紫），小屏上对比度与聚焦度显著优于白底。
    - 点数 240→480（>屏宽像素），触发 LVGL 内置 min/max 竖线包络
    （示波器 peak-detect 同款，防混叠丢峰）。
    - 格线降密度 5x10→4x8；均值线/min-max 圆点装饰默认关闭（WAVE_DECOR_ENABLE）。
    - 量程扩程加 3% 滞回余量、缩程 4 帧防抖，消除频繁跳变。
    - 时间槽契约（每槽固定时长、NaN 断线）同步至 UI 一比一映射。
2026-10-14 feat(设置): 电流校准一键清零，波形平滑开关持久化
    - 电流校准编辑页新增「一键清零（空载）」：offset 减去当前读数，空载
    读数立即归零，之后接负载从 0 起算（消除前端零点漂移）。
    - 新增 settings.wave_smooth（NVS 键 wave_smt）持久化波形曲线平滑开关。
    - screen_wave 平滑扩展至双通道（原仅平滑主轴，副轴电流噪声直出）。
    - ui_sim mock_settings/mock_power_measure 同步新字段与时间槽口径。
2026-10-14 fix(ui): 首页循环滑动修复，启动页进度条与故障弹窗
    - ui_nav：indev RELEASED 回调改 lv_async_call + scroll_to_x 直接操作
    tileview 滚动，绕开与弹性回弹动画的冲突（修复首页右滑环回失效）。
    - splash：进度条加宽至屏宽 80%，新增进度阶段文字（初始化系统/加载
    字库/初始化传感器/准备界面）。
    - ui：启动进度完成后读取 system_state 故障位，有外设初始化失败则
    msgbox 弹窗列出故障项，点"确定"后再构建主界面；无故障直接进入。
    - screen_measure：快速菜单滑板升降动画 + 顶部拖拽把手 + 上/下滑手势
    （screen_wave 风格）。
    - sim_scenes 同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
    [ui.c, ui_nav.c]
2026-10-14 perf(显示): LVGL 双缓冲 40 行块与任务优先级上调，QSPI 提速 23MHz
    - lvgl_port：渲染缓冲 20→40 行块（减 flush 次数）、双缓冲开启
    （渲染与 DMA 并行）、LVGL 任务优先级 4→10（减少被抢占）。
    内存代价约 +45KB 内部 RAM，余量充足。
    - lcd_nv3030b：QSPI PCLK 20→23MHz（写显存提速，命令时序不变）。
    - sdkconfig.defaults：关闭 LV_USE_SYSMON/PERF_MONITOR（性能验收
    完成，恢复无角标界面）。
2026-10-15 fix(方向): 自动旋转竖屏两向角度按实测对调
    SC7A20H 姿态→屏幕角度映射表：PORTRAIT 90°→270°、PORTRAIT_INV
    270°→90°（横屏两向不变）。2026-10 实机标定结果，修正竖屏自动旋转
    方向相反的问题。
    [orientation.c]
2026-10-15 chore(repo): 忽略 AI 辅助开发调试产物目录
    .claude/ 为 AI 辅助开发工具的运行时产物（调试记录等），结论已沉淀
    于代码注释与 docs/，不纳入版本管理。
2026-10-15 fix(波形): 自动量程上下留白提至 12%，波峰波谷不再贴边
    用户反馈 5% 留白仍偏紧、波形贴 chart 边框极难观测。留白比例
    5%→12%（WAVE_RANGE_PAD_FRAC）：信号占图面约 3/4 高度，上下各留
    清晰呼吸空间（示波器惯例）。chart range 与轴刻度同步使用同一留白，
    峰值落在约 88% 处，均值线换算保持一致。
2026-10-15 fix(驱动): 整帧改读 4 字并校验输出 CRC，根治帧错位毛刺
    根因：ADS131M02 帧固定 4 字 [STATUS/CH0/CH1/输出CRC]（SBAS839 §8.5.1.7，
    输出 CRC 不可关闭、恒在帧尾），驱动此前每帧只读 3 字。无 CS 接法下
    一次 DRDY 假边沿即字计数错位，读到 [CH1][STATUS][CH0] 等错位帧——
    毛刺值恰为 STATUS 字本身（实测 I 尖峰 0x050300 = STATUS 0x0503<<8），
    且错位持续数秒不自愈。
    修复：
    - 帧长 3→4 字（96 SCLK），命令/寄存器访问同步整帧；
    - CRC-16/CCITT 校验（多项式 0x1021、初值 0xFFFF，覆盖帧前 3 字 9 字节），
    采样结构新增 crc_ok，错位/损坏帧直接剔除（STA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
    [ads131m02.c, ads131m02.h, power_measure.c]
2026-10-15 fix(波形): 自动量程每格最小分辨率——电压 1V/格、电流 0.1A/格
    微小信号被自动量程过放大成全屏巨浪，观测失真。新增量程量化：
    当留白后跨度不足 4 格 × 最小分辨率（电压 4V、电流 0.4A）时，
    以信号中心对称扩到最小跨度。chart range 与轴刻度同步量化值，
    每通道按单位（V/A）自动选择对应最小分辨率。
2026-10-15 fix(波形): 量程格值改 1-2-5 标准序列，刻度锚定整格值
    电压每格 1/2/5/10V…、电流每格 0.1/0.2/0.5/1A…（仪表行业标准格值
    序列），量程边界锚定格值整数倍——5 条格线全部落在整格值倍数上，
    读数可直接按格数心算（用户要求"格子都是整数，如 1V、2V、0.1A、
    0.5A、1A、2A"）。固定 4 格、下边界向下取整到格值倍数、上边界 =
    下边界+4×格值；floorf 加 1e-3 抵消浮点误差。
2026-10-15 fix(波形): 底部实时/平均数据改定宽列布局，数值跳动不再左右晃
    原先整行拼成单个字符串，数值正负号/位数跳变会让后续数字整体左右
    晃动，小屏上难以盯读。改为每个测量量占一个定宽列：
    - 列内数值右对齐定宽框，单位固定列右端，数值向左生长不推挤；
    - 列宽按屏宽均分自适应横/竖屏，列数随波形模式 1~3 列变化；
    - 数值字体加大到 20px（单位 12px、行首"实/均" 16px）；
    - 数据行整体下移、行距拉大，图表相应微缩 8px 以保持不裁切。
    已通过 LVGL 模拟器截图验证三列对齐、显示完整。
2026-10-15 docs: 新增开源 README，修正架构文档过时描述
    - 新增根目录 README.md：项目简介、硬件概要、快速开始（构建/烧录）、
    目录结构、文档导航、开发约定、常见问题与参与贡献，面向开源使用者；
    - architecture.md 修正与现状不符的描述：外部依赖改组件管理器托管
    （LVGL 升级步骤同步改写）、目录结构去掉已移除的 lvgl/ vendor 目录、
    LVGL 任务栈更正为 16384 字节、后续里程碑同步当前实现状态。
2026-10-15 docs: 全项目补充教学级中文注释，讲解 ESP-IDF/FreeRTOS/LVGL API
    面向开源读者（含未学过 ESP-IDF 的初学者）补充详细注释，仅注释变化、
    代码逻辑零改动（已用剥离注释逐 token 比对验证，并编译通过）：
    - 每个函数补齐 Doxygen（@brief/@param/@return/@note）；
    - 关键逻辑讲"为什么这么做"（设计取舍、踩坑记录）；
    - ESP-IDF / FreeRTOS / LVGL API 调用处就地讲解功能与参数含义
    （如 xTaskCreatePinnedToCore 栈单位为字节、nvs_commit 才落盘、
    lv_chart_set_div_line_count 参数为线数而非格数、seqlock 双序号校验等）；
    - 覆盖 power_measure（39%）、settings、syste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
2026-10-15 fix(ui): 波形数据行布局微调与显示健壮性修复
    - 波形底部"实时/平均"数据行：数值字体 20px→16px、前缀→14px，单位
    12px 垂直居中于行内（原先与数值顶对齐，视觉上像"上标"飘在右上角）；
    行距重排、图表回收 8px，均行底离底边留空避开圆角裁切；
    - 修复旋转重建后 roller 两阶段编辑状态残留导致的点击逻辑错位
    （重建前调用 roller_edit_cancel）；
    - 测量页 fmt_val 对 NaN/inf 显示 "----"，坏帧不再被当成真实 0 值；
    - 修正波形量程留白注释（5%→12%，与 WAVE_RANGE_PAD_FRAC 一致）。
    横竖屏均已过 LVGL 模拟器截图验证。
2026-10-15 feat(ui): 设置页纯按键焦点体系，修复断触连翻两页与启动弹窗卡死
    三项交互缺陷修复（对应项目审计 P0-1 / P0-2 与实机反馈）：
    1. 滑动断触连翻两页（实机反馈）：长距离滑动时电容触摸偶发断触被
    LVGL 切成两段独立手势，两段各过半页宽即连翻两页。新增"断触续接
    吞没"——间隔 <250ms、起止点距 <35px、上段为显著水平滑动时认定
    续接，冻结 tileview 吞掉续接段拖动，上段吸附动画停在目标页；
    三条件同时满足才吞，不误伤正常快速连翻。重建时吞没状态归零。
    2. 启动故障弹窗卡死（P0-1）：等待循环无超时且按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
    [ui.c, ui_nav.c]
2026-10-15 fix(测量): 并发竞态与数值口径修复（NVS 落盘/临界区/故障位/电能精度）
    对应项目审计 P1 群（跨核/ISR 并发）与 P2 数值问题：
    - save_persist() 三处跨核调用无互斥，并发 nvs_set_blob/commit 交错：
    新增落盘互斥锁串行化全段，快照拷贝单独短锁（保持 set_calibration
    "调用即持久化"语义）；
    - 电能清零在采样任务内同步 NVS commit（可达数百 ms，期间丢 DRDY 帧）：
    改为块边界只改内存 + 置脏标志，由辅助任务落盘，采样路径不再碰 NVS；
    - ring_fill_slots 自旋锁内做万点级聚合会卡住 Core1 采样：临界区只
    memcpy 快照，聚合/插值移到锁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
    [power_measure.c, power_measure.h, system_state.c]
2026-10-15 fix(驱动): SPI/I2C 并发竞态修复与文档失配清理
    对应项目审计 P1/P2 驱动层问题：
    - ads131m02：寄存器访问（init/selftest/诊断）不持总线互斥，运行期与
    采样并发时"清残留 DRDY"会互相吞信号、帧交错错位。新增 bus_lock
    原语，全部 SPI 访问统一加锁，DRDY 等待改锁内不可分割序列；
    - lcd_nv3030b：清屏信号量被 ISR 回调 give 的同时 init 任务可能正在
    删除（use-after-free 窗口）。改信号量常驻不删，新增 waiting 标志
    分流回调；
    - aht20 / imu_sc7a20h：init 中途失败已挂 I2C 器件但错误路径不回滚，
    重试重复挂载同地址泄漏句柄。失败路径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
    [ads131m02.c, ads131m02.h, aht20.c, buzzer.c, imu_sc7a20h.c, lcd_nv3030b.c, lcd_nv3030b.h, touch_cst816d.c]
2026-10-15 docs: 开源合规三件套与 README 宣发口径校准
    对应项目审计 P0-3 / P1-E5 / P1-E7：
    - 新增 LICENSE：MIT 许可证（版权人 zeruns，2026）；
    - 新增 THIRD_PARTY.md：第三方组件许可清单（lvgl 9.6 MIT、
    esp_lvgl_port / esp_lcd_spd2010 / cmake_utilities Apache-2.0、
    Noto Sans SC OFL 1.1），版本对照 dependencies.lock 核实；
    - 新增 CONTRIBUTING.md：中文贡献指南（环境、构建烧录、UI 回归、
    代码规范、分层与引脚约束、中文 Conventional Commits 原子提交）；
    - README 校准空桩宣发：双 OTA / WiFi / Web 控制台标注"规划中、
    接口骨架"，消除宣传与实现落差；电能落盘周期 10s→3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
2026-10-15 chore(工程): CI 骨架、构建脚本参数化与版本号接入
    对应项目审计 P0-4 / P1-E1/E2/E4：
    - 新增 .github/workflows/ci.yml：ESP-IDF v6.1 容器跑 idf.py build，
    依赖失败输出排查指引；
    - 新增 tools/ci/run_ci.ps1：本地一键回归（build + 主机单测 + ui_sim，
    [scene] !! 告警数为 0 才过），退出码供 CI 判定；
    - build_fw.bat / flash_fw.bat：IDF_PATH 已设则用之、否则回退本地路径；
    烧录串口参数化（flash_fw.bat COM5，缺省 COM3）；
    ⚠ 两个批处理改为纯 ASCII：cmd 按 GBK 代码页读 .bat 时 UTF-8 中文
    多字节会吞掉换行符导致解析错乱（实测 flash_fw.bat 直接语法崩坏）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
2026-10-15 docs: 新增项目全量审计与演进报告（HTML）
    五路并行静态审计（驱动/服务中间件/UI/工程化/功能缺口）汇总报告：
    42 项发现（P0 4 / P1 17 / P2 21）+ 15 项功能路线图（价值×复杂度）+
    三阶段修复甘特图。本轮已按该报告完成阶段 A（开源合规）与
    阶段 B（健壮性收敛）修复，报告作为开源项目健康度档案保留。
2026-10-16 fix(驱动): 修正 ADS131M02 OSR 注释算术错误与宏命名
    - 原注释称"OSR=8x 档，ODR = 4.096MHz / 8 = 500Hz"，算术不成立
    （4.096MHz/8 = 512kHz）；实际配置为 OSR=8192 档（OSR[2:0]=110），
    ODR = 4.096MHz / 8192 = 500Hz，全文统一 OSR=8192 口径
    - ADS_CLOCK_VALUE 误称 0x030E（那是芯片复位值），实际写入值为
    0x031A（HR + OSR=8192 + 保留位置 1），注释同步更正
    - 宏 ADS_CLOCK_OSR_8X 更名为 ADS_CLOCK_OSR_8192，消除命名歧义
    - 手册编号 SBAS839 更正为 SBAS853（ADS131M02 数据手册）
    [ads131m02.c, ads131m02.h]
2026-10-16 docs(测量): 统一 500Hz 采样率口径并修正 DRDY 抑制根因表述
    - power_measure / power_calc / data_store 注释中的 1kHz、4kHz 旧口径
    统一为 500Hz（2ms 样本周期），三级缓冲 tier 速率改为 500/50/1.25Hz
    - DRDY 塌频根因由"MCLK 异常"误判修正为手册 §8.5.1.5 的读取窗口
    跨越转换完成时刻抑制机制（4kHz 档实测塌到约 310Hz 的正解）
    - data_store 写入节奏修正为 40Hz（每 25ms 显示子窗写一次快照，
    200ms 块统计另行累计），块边界为墙钟 200ms 时间比较触发
    [power_calc.h, power_measure.c, power_measure.h]
2026-10-16 docs(工程): 同步任务编排表与全项目采样率口径
    - app_tasks.h 任务规划表改写为与实现一致的编排表：task_power_calc、
    task_input 等规划任务从未实现，实际为 pm_sample/pm_aux 等 8 个任务，
    含核绑定、节奏与优先级；architecture.md 双核分工表同步
    - architecture.md、sdkconfig.defaults 中 1kHz/1ms 采样旧口径统一为
    500Hz（2ms），DRDY 中断频率 4kHz 更正为 500Hz
    - README 与审计报告中 4kSPS 残留修正为 500SPS（审计报告差异表的
    历史发现记录行保留原样）
    - 历史规划快照（.trae 规划文档、xt60-optimization-plan.html）按
    原始口径保留不改
    [app_tasks.c, app_tasks.h]
2026-10-16 feat(驱动): ADS131M02 迁移到 SPI3+GDMA 帧引擎，DRDY ISR 直启采样帧
    自研最小 SPI3+GDMA 帧引擎（ads131m02_engine）替代 spi_master：spi_master
    的事务启动 API 均为任务上下文语义（queue_trans 入队即启动、polling_start
    不可在 ISR 内调用），无法在 DRDY 下降沿后确定性地发起读帧。引擎把"启动
    一帧"压缩为 ISR 内的几条寄存器写（描述符重臂 + gdma_ll 启动 +
    spi_ll_user_start），DRDY→SPI 启动延迟 δ 由任务调度级降至中断级。
    实现要点（均为实机实证定位，原因就地固化在注释中）：
    - 外设上电必须走 spicommon_periph_claim：它负责 PCR 寄存器接口总线时钟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
2026-10-16 feat(测量): 恢复 4kHz 采样率并同步下游口径与波形平滑
    驱动侧 CLOCK 改 OSR=1024（ODR=4kHz）后，同步测量链路与全项目口径：
    - power_measure：采样率 500→4000Hz，块样本 100→800（块周期仍为墙钟
    200ms），tier1 降采样 10→80 点（tier1 速率保持 50Hz）；
    - 波形轻滤由 4 点改 8 点滑动平均：OSR=1024 的单样本噪声约为 8192 档的
    √8≈2.8 倍，8 点均值把显示噪声压回原水平（统计与电能仍用原始样本，
    不受轻滤影响）；
    - data_store / power_calc / app_tasks / docs/architecture.md /
    sdkconfig.defaults / README / 审计报告中 500Hz、2ms、OSR=8192 等旧口径
    统一为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
2026-10-16 feat(设置): 电流一键清零改 1 秒均值，修复按压反馈与弹窗叠放卡死
    三项设置页交互改进（同一轮实机反馈驱动）：
    1. 电流零点一键清零改用"按下后 1 秒内的平均值"：原实现取点击瞬间的单帧
    快照，偶发坏帧会被永久烧进零偏。改为异步 lv_timer 每 40ms 轮询
    data_store，累计约 25 帧（40Hz 快照，自带掐头去尾）后取均值，不阻塞
    UI 任务与 LVGL 锁；采样期间提示"正在清零"，结束弹出含采样时长/帧数/
    均值的复核结果；带重复点击保护，触摸与物理按键共用同一 CLICKED 回调。
    2. 触摸按压反馈不可感知：按下态原仅把底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
2026-10-16 docs(测量): 新增 ADS131M02 4kHz 采样可行性分析与实施方案
    两份技术文档，作为 4kHz 采样攻关的决策依据与实施记录：
    - ads131-4khz-dma-feasibility.md：论证"DMA + DRDY 中断能否解决 4kHz 不
    达标"。结论：单纯把读取改 DMA 不能解决——根因是 SPI 事务启动相位不
    确定，而 spi_master 的启动 API 均为任务上下文语义；须由 DRDY ISR 直接
    触发预配置的 GDMA 才能锁定读窗相位。含时间预算（20MHz 下 96bit 帧仅
    4.8µs、读窗占 250µs 周期约 4%）与手册依据（SBAS853 §8.5.1.5 的 DRDY
    抑制机制、§6.6 SCLK 时序上限、§6.7 t_p(SCDO)）。
    - ads131-4khz-implementatio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
2026-10-17 fix(驱动): 维护帧改 ISR 直启修复寄存器通路，补 IRAM 保护链与帧重同步容错
    问题：4kHz 引擎迁移后 RREG/WREG 命令不被芯片识别——寄存器读回全是
    STATUS(0x0503)、命令回显串到错误帧，自检读 ID 失败导致系统卡 INIT、
    采样任务不启动（上板实测）。
    根因：维护帧走「任务取信号量→再 kick」，DRDY 边沿到 kick 之间的任务
    调度延迟使命令帧落到错误帧窗；流式帧因 ISR 直启不受影响。
    - 维护帧改为 DRDY ISR 直启（任务置请求→ISR 边沿 kick→通知完成），
    消除调度延迟对帧对齐的影响；set_stream(false) 时无条件 drain 同步
    信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
    [ads131m02.c, ads131m02.h, ads131m02_engine.c]
2026-10-17 feat(测量): 仪器功能批——峰值统计/累计容量/告警保护，NVS 精度与故障分流下游
    v0.2.0 仪器功能批（F1/F2/F3）与数值口径修复：
    - F1 峰值统计：块均值口径的 V/I/P 峰谷值随快照下发（data_store 新增
    v_max/v_min/i_max/i_min/p_max/p_min 字段），本次上电累计、清零随
    电能清零语义
    - F2 累计容量：电流墙钟积分得 Ah，与电能并列 double 累计，NVS 持久化
    并掉电恢复（新增 pmdw/pmah 双精度键）
    - F3 告警保护：settings 新增告警阈值配置（三阈值+三使能，防抖落盘，
    blob 键 alarm_cfg）；测量核块边界判定越限（DATA_ALERT_OVP/OCP/OPP），
    上升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
    [power_calc.c, power_measure.c]
2026-10-17 fix(ui): 告警界面落地，修复字体缺字与温湿度占位误判
    - 告警 UI（F3 配套）：告警上升沿模态弹窗（按键/触摸确认，恢复自动关
    闭，不堆叠）、测量页顶部告警横幅（按位拼文案，隐藏不挤动布局）、
    设置页告警设置子页（三阈值步进调节+三使能开关，纯按键焦点可达，
    FOCUS_MAX 扩至 10，网格焦点跳过空位）
    - 峰值/容量显示（F1/F2 配套）：底部两行小字（V/I/P 峰谷对 + Ah 容量 +
    温湿度），fmt_val NaN 显示 ----，布局横竖屏自适应
    - 字体缺字修复：审计发现 5 字缺失（阈/咔/哒/−/⚠）显示为方框——
    字体子集生成于新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
    [ui.c, ui.h]
2026-10-17 feat(联网): WiFi/Web 控制台/OTA 三组件落地与启动编排（v0.5.0 主体）
    - wifi_manager：STA/AP 配网状态机（无凭据开热点 XT60-Meter-XXXX），
    事件驱动+内部任务模型（回调零 NVS/零阻塞），指数退避重试，NVS
    凭据自管（命名空间 wifi），扫描列表查询，forget/connect API
    - web_console：HTTP 仪表页+WebSocket 5Hz 实时推送+GET /api/state，
    参数下发经回调注入（middleware 不依赖 services），POST /api/config
    支持告警阈值/亮度/音量/刷新率设置
    - ota_update：HTTPS 下载→镜像头校验→A/B 写入→自检门禁→回滚语义
    （rollback_if_pending 处理 PENDING_VERIFY），独立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
2026-10-17 ci: 主机单元测试接入 Linux CI（gcc 直跑三套件）
    主机单测是纯 C 无平台依赖（power_calc/button_fsm/aht20_calc），
    Linux gcc 可直接编译运行——新增独立 job 与本机 run_host_tests.ps1
    同源同参执行，替代此前仅构建不做功能验证的门禁缺口。
2026-10-17 chore(工程): 发布 v0.2.0 可信仪器版，统一测量口径文档与规划产物入库
    - version.txt 升 0.2.0（版本唯一来源，发版 tag 与之对应）
    - 数值口径统一：README/architecture 的 RMS 表述改为块均值（直流口径，
    约 200ms 窗平均），与实现一致；功能特性补峰值/容量/告警/联网骨架
    - CONTEXT.md：领域词汇表（4kHz 采样链路/墙钟块/单写者/维护模式/
    软件旋转等稳定术语，防文档漂移复发）
    - docs/adr/0001：4kHz 采样链路技术路线决策记录（OSR=1024+20MHz+
    DRDY ISR 直启 GDMA 的取舍与约束）
    - docs/xt60-prd-2026-10.html：产品需求与分步实施计划（V0 收口→
    v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
2026-10-17 feat(联网): WiFi 内存适配打通 AP 配网，CSV 导出与 WS 实时推送
    - WiFi 启动内存适配（上板实测根因链）：SPIRAM_MALLOC_ALWAYSINTERNAL
    8KB/16KB 会把 WiFi static rx buffer（1600B/个）强制推入内部 RAM 而
    esp_wifi 对该池要求 DMA 能力内存，「malloc buffer fail → rx buffer 0 个
    → esp_wifi_init NO_MEM」（内部 RAM 尚有数十 KB 空闲）；阈值降到 1KB
    使该池走 PSRAM 后分配成功。配套：静态收发缓冲按低吞吐场景调小
    （RX2/TX4/DYN_RX12，BA_WIN=2 满足编译期一致性校验）、管理短缓冲
    32→6（range 下限）、内部预留 32K→16K
    - AP 配网打通：热点 XT60-Meter-XXXX + DHCP 1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
2026-10-17 feat(ui): 波形设置持久化、恢复出厂、自动息屏与 WiFi 状态页（v0.5.0）
    - B20 波形持久化：时间窗/显示模式切换时写 settings（防抖落盘，
    确定时 save_now），create/旋转重建时恢复；越界回默认 10s 窗 /
    电压+电流模式（与旧版默认一致，PM_WAVE_MODE_VI=3）
    - F6 恢复出厂：设置网格第 8 格入口，确认弹窗列出清除项（用户设置/
    电能统计/WiFi 网络，标定保留，不可恢复），依次
    settings_restore_factory → power_measure_reset_energy →
    wifi_manager_forget（逐项容错），纯按键焦点可达
    - F4 自动息屏：按键输入更新时间戳，超时（档位×30s）熄背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
2026-10-17 chore(工程): 发布 v0.5.0 联网数据版
    v0.5.0 范围：WiFi AP 配网（热点+网页引导）、Web 控制台（实时 WS 推送/
    参数下发/CSV 导出）、OTA A/B 回滚配置、体验批（自动息屏/波形设置
    持久化/恢复出厂/WiFi 状态页）。上板实测：热点 XT60-Meter-C888 +
    192.168.4.1 + 控制台 5Hz 推送全链路可用。
2026-10-17 fix(联网): 修复 WiFi 内存链崩溃与 beacon 不广播，打通 STA 全链路（上板实测）
    端到端联调暴露三连环问题，逐一实测定位并修复：
    1. beacon 不广播（配网热点扫不到，Windows 判 RSSI 255/网络不可用）：
    SPIRAM_MALLOC_ALWAYSINTERNAL 阈值（16K/8K/1K 三档均中招）把 WiFi
    beacon 缓冲（752B）强制推入内部 RAM 导致「alloc eb len=752 fail」，
    beacon 发不出 + WiFi 驱动任务 NULL 解引用崩溃。阈值降 512（低于
    beacon 缓冲）后该池走 PSRAM，beacon 恢复正常。
    2. STA 连接后 phy_track_pll_init 崩溃（esp_timer_create 要求
    MALLOC_CAP_INTERNAL，WiFi 稳态吃掉约 85KB 内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
    [app_tasks.c, ui.c]
2026-10-19 fix(设备端): 修复设置页 IP 显示反序与满电电压口径，取消页面循环翻页
    - wifi_manager：按 lwIP 小端语义取低字节在前格式化 IP，此前 192.168.1.12
    被显示成 12.1.168.192（上板实测确认）
    - battery_percent：满档电压由 4.2V 改为 4.15V，对齐 TP4057 充电截止电压
    - ui_nav：删除端页朝外滑动与按键取模的环形翻页，滑动/按键到首末页即止
    （移除 wrap_goto_async，tileview 自身弹性回弹即到头效果）
    [ui_nav.c]
2026-10-19 feat(设备端): 首页电能条支持 Wh/Ah 点击切换，接入 SOC 结温采集链
    - screen_measure：电能数据条可点击，在 Wh / Ah 间循环切换并给一声短鸣反馈；
    底部小字行不再恒显 Ah，改由该行按需显示
    - power_measure：接入 esp_driver_tsens，初始化时安装并启用芯片内部温度
    传感器（-10~80℃），task_aux 周期读取，失败不影响测量主链路
    - data_store：快照新增 soc_temp_c（NaN = 未就绪），沿用温湿度的空值语义
    - app_tasks：巡检日志追加 SOC 温度输出，便于长跑观测主控发热
2026-10-19 feat(网页): 网页控制台重构为四页签面板，扩展数据字段与波形图
    - 导航四页签：实时数据 / 波形图 / 设置 / 日志
    - 波形图（Canvas 2D，本地 5Hz 累积环形缓冲 3600 点）：V/I/P 三通道叠加、
    1s~10min 时间窗、暂停、拖动回看历史（绝对时间冻结）、十字光标读数、
    锁定量程、清空、波形 CSV 导出，比设备端波形页更完善
    - 数值小数位复用设备端 fmt_val 的动态规则（<1 五位 / <100 四位 /
    <10000 两位 / <1e6 整数 / 更大科学计数，NaN 显示 ----），两边屏显一致；
    新增 SOC 结温与累计容量卡片，告警时顶部红条提示
    - 设置页封装固件真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
2026-10-19 chore(工程): 发布 v0.5.1 设备 UI 与网页面板增强版
    - version.txt 升至 0.5.1（固件 app_desc 与 OTA 回滚检查同步）
    - README 补充联网与网页控制台能力描述，修正 wifi_manager/web_console
    “规划中/接口骨架”的过期表述与三页“循环滑动”描述
    - architecture.md §12 缺口表移除已落地的 wifi_manager / web_console 行
2026-10-19 feat(设备端): WiFi 配网增强与设置页 UI 卡死修复
    - WiFi：新增工作模式偏好（自动/仅 STA/配网热点）、热点扫描、密码键盘配网
    与忘记网络；状态栏改为按连接状态显示 4 格信号条（断连/弱/中/强/配网热点）
    - 告警设置：点击数值弹出 LVGL 数字键盘直接输入，与 －/＋ 步进并存
    - 卡死修复：清除 LVGL 回调内的同步 NVS 写入（校准一键清零改用 deferred 版，
    亮度/音量/角度/息屏等 7 处改用非阻塞 settings_request_save），UI 任务栈由
    12KB 提升到 16KB 与 taskLVGL 对齐，消除校准页/电能统计页卡死
    - 仿真器：补充 wifi_manager 桩、FreeRTOS/es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
    [power_measure.c, power_measure.h]
2026-10-19 feat(网页端): 控制台升级为五页签面板并接入 WiFi 扫描配网
    - 实时数据：功率为 Hero 主读数，电压/电流/功率、累计量、电源链路、环境结温
    按四层字号递减排布；新增 WiFi 状态/RSSI 信号条与告警状态卡
    - 波形图：网格加密为 8×4（参考设备端示波风格），底部改为三张通道统计卡
    （当前值最大，最小/最大/平均按统计类型分色并带单位）；修复卡顿——改用
    requestAnimationFrame 合并重绘、按画布像素宽度抽稀曲线、统计值降频更新，
    删除每秒强制重绘，仅在波形页可见时绘制
    - 设置：新增 WiFi 搜索列表选点、密码配网、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
    [app_tasks.c]
2026-10-19 chore(工程): 版本号提升到 0.6.0 并清理过期审计产物
    - version.txt 0.5.1 → 0.6.0（本次为 WiFi 配网增强 + 网页控制台升级）
    - 移除已过期的 project-audit-2026-10 审计报告产物目录
2026-10-19 fix(系统): 修复 UI 概率卡死与自动复位——小分配内存策略根因修复
    根因：SPIRAM_MALLOC_ALWAYSINTERNAL=512 把 LVGL（clib malloc）高频小分配
    （建对象/每秒数十次 label 刷新的 strdup）与 WS 10Hz 每客户端 350B 发送
    缓冲全部强制挤入仅剩 ~19KB 的内部 RAM，碎片化耗尽后 lv_malloc 返回 NULL，
    渲染/布局路径解引用崩溃 abort 复位——表现为任意页面概率卡死、校准页
    卡几秒自动复位（TWDT PANIC 未开启，复位只能来自 abort）。
    - sdkconfig(.defaults)：ALWAYSINTERNAL 512 → 0，malloc 先内部、不足自动
    溢出 PSRAM，分配不再因阈值失败（实测内部 RAM 空闲 19KB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
    [app_tasks.c]
2026-10-19 feat(设备端): WiFi 扇形图标三态显示、扫描结果独立页与启动页去蓝条
    - 状态栏 WiFi 图标重做：弃用 4 格自绘信号条（蜂窝语义不符），改为
    LV_SYMBOL_WIFI 扇形图标——已连接按 RSSI 四档配色（绿/绿/黄/红）、
    连接中黄、热点模式品牌蓝 + AP 徽标、未连接灰图标叠加斜杠（WiFi off）
    - WiFi 扫描结果拆到独立二级页：旧版 12 行列表内嵌主页（一次创建约
    百个对象，内存压力大的帮凶），独立页给列表完整可滚高度，支持
    重新扫描；主页只留入口按钮
    - 启动页：移除顶部 4px 品牌蓝通栏（用户反馈观感突兀），品牌色改由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
2026-10-19 chore(工程): 版本号提升到 0.6.1 并同步文档
    - version.txt 0.6.0 → 0.6.1（UI 卡死根因修复 + WiFi 图标/扫描页/启动页）
    - README 功能特性补齐 v0.6.x 能力（WiFi 配网三档模式、扫描独立页、
    状态栏图标四态、网页五页签、10Hz 推送、/api/wifi/scan 等新接口）
    - architecture.md 补充小分配内存策略（ALWAYSINTERNAL=0）的演进史与
    根因说明；里程碑段落同步 wifi_manager/web_console 当前形态
2026-10-20 feat(设备端): 修复 UI 交互问题并新增无操作自动降亮
    - 焦点框按需显示：未按物理键时不显示蓝色选中框，按下方向键才出现
    - 方向键切换选中项时用 scroll_to_view_recursive 逐级上滚，选中下方项不再看不到
    - 自动旋转灵敏度提高：驱动侧平放/横竖判据改为带权阈值（约 35 度触发），服务侧采样周期 200 降至 150ms、确认次数 6 降至 3（稳定窗口 1.2s 降至 450ms）
    - 新增自动降亮：无操作 15/30/60 秒（档位可设）后背光降至 10%，触摸与按键均重置计时并立即恢复用户亮度
    - 告警弹窗显式中文字体避免方框；告警文案去掉 U+26A0 改用全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
    [app_tasks.c, imu_sc7a20h.c, orientation.c]
2026-10-20 feat(WiFi): 设备端显示配网热点密码并扩大字库扫描范围
    - 新增 wifi_manager_get_ap_pass() 只读接口；WiFi 设置页在配网模式下显示热点密码，用户可据此连接 WPA2 加密热点完成配网
    - 修正把配网热点描述为开放的过时表述（日志与头文件注释）
    - 字库子集与缺字审计的扫描范围由 services/ui/src 扩大到整个 components，消除上游组件文案漏字；内嵌网页因由浏览器字体渲染而排除
    - 依据新文案重新生成 Noto Sans SC 子集 TTF（缺字审计 0 缺失）
2026-10-20 feat(网页端): 波形网格改为 5x10 并新增配置回读与设备信息接口
    - 网页波形图纵向 5 格、横向 10 格；每通道设最小格子值（电压 1V、电流 0.1A），格子锚定 1/2/5/10 标准整数序列，刻度按格子值决定小数位，直接读数
    - 新增 GET /api/config（回读全部可下发设置，键名与 POST 一致，便于上位机读-改-写）与 GET /api/info（版本/IDF 版本/IP/MAC/运行时间/内部与 PSRAM 内存水位/WiFi 状态）
    - API 文档页补充上述接口说明与字段表，页脚接口清单同步更新
    - 参数下发日志与提示改为输出下发的具体 JSON 内容，便于排障对账
2026-10-20 chore(工程): 版本号提升到 0.6.2 并同步文档
    - README 更新功能特性：自动降亮、WPA2 配网热点与密码显示、网页波形 5x10 网格与单格最小值、新增 GET /api/config 与 /api/info 接口
    - architecture 文档补充字库扫描范围口径与 v0.6.2 接口/自动降亮说明
2026-10-20 fix(网页端): 补齐自动降亮档位下发键并修正 API 文档口径
    - GET /api/config 会回读 screen_off，但 POST 侧未实现该键，实机下发返回 ESP_ERR_NOT_FOUND（读写不对称）；现补上档位写入，并在改档后重置降亮计时
    - API 文档澄清：orientation_auto/angle 与 wave_window/mode/smooth 为只读项，须在设备端设置页调整；POST 键表补充 screen_off 说明
    - 实机验证：screen_off 置 1 后静置 15.0s，日志出现 [自动降亮：无操作超过 15s，背光降至 10%]，随后用户活动恢复正常亮度
    [app_tasks.c]
2026-10-20 feat(设备端): WiFi 扫描页改版与设置子页跟随网页下发实时同步
    - WiFi 扫描页把「重新扫描」按钮移到标题栏右侧（宽度按屏幕自适应），内容区只留 1 行状态提示：横屏列表可见 3 行、竖屏 4 行（原横屏仅 2 行）
    - 新增 subpage_open 暴露标题栏指针，供子页在标题栏挂操作按钮，为内容区腾高度
    - 设置子页亮度/响度滑条与数值、自动降亮档位按钮随外部（网页控制台）下发实时同步：在 5Hz 刷新里对比 settings 值，按住滑条时不回写、值未变不重绘、写滑条期间抑制回调以防重复落盘
    - UI 模拟器：新增 4 个场景（横/竖屏扫描页布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
2026-10-20 feat(网页端): API 页签重写为分接口文档
    - 新增「快速上手（3 步）」：读数据 / 改设置 / 接实时推送，每步给浏览器地址 + curl + PowerShell + 最小 JS 片段
    - 每个接口一张卡片：用途、请求示例、响应示例 JSON（取设备实测值）、字段含义表（含类型/单位）、错误码与处理建议
    - 新增错误码总表（400 bad_json/invalid_arg、413、404、405、500、503），并修正 POST 参数表的键名口径（alarm_v_en/alarm_i_en 等与 GET /api/config 回读一致）
    - 每张卡片带「▶ 到测试台试一次」按钮：预填测试台方法/路径/请求体并滚动过去
2026-10-20 perf(系统): 日志降噪、WS 缓冲常驻化与 LVGL 渲染/任务栈调优
    - 日志降噪：巡检 4 条内存/栈日志合并为 1 行、引擎统计与测量行合并为 1 行；ads131m02 每秒「基线统计」由 ESP_LOGI 降为 ESP_LOGD（需要时用 esp_log_level_set 打开）。实测 60s 日志 156 行 → 48 行（2.60 → 0.80 行/秒），减少 Core0 同步 UART 占用
    - 网页 WebSocket 推送改用常驻发送槽（启动时一次性分配到 PSRAM，8×512B≈4KB），去掉每帧 per-client 堆分配/释放；槽忙则跳过本帧（快照流下一周期自然带新数据）
    - LVGL 心跳周期 5ms → 16ms：最高刷新需求为测量页 30Hz 与波形页 25Hz，5ms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
2026-10-20 chore(工程): 版本号提升到 0.6.3、修复 version.txt 配置依赖并同步文档
    - 修复：version.txt 只被 file(READ) 读一次，改版本号后增量构建不会重新配置，固件版本号会停留在旧值（实测改成 0.6.3 后 /api/info 仍报 0.6.2）；现声明为 CMAKE_CONFIGURE_DEPENDS，改版本号必触发 reconfigure
    - README/architecture 同步 v0.6.3：扫描页重扫按钮入标题栏、设置子页跟随远程下发、API 页分接口文档、性能改动与实测数据
2026-10-20 feat(网页端): 设置表单打开即回填设备当前值并将推送提速到 15Hz
    - 打开页面即 GET /api/config 回填告警使能/阈值、亮度、音量、刷新率与 WiFi 模式（此前显示 HTML 默认值，直接应用会把错误默认值覆盖写进设备）
    - WS 推送周期 100ms 降至 66ms（约 15Hz）：任务只做 snprintf+常驻槽拷贝+异步排队，且已迁 Core1，不影响交互核
    - 轮询兜底通道 200ms 降至 100ms；全文案（链路标识/日志/API 文档/缓冲时长）同步 10Hz 改 15Hz，并修正波形页遗留的 4x8 网格描述为 5x10
2026-10-20 feat(测量): 新增恒开的过温告警（机内温度超过 60 度）
    - data_store 新增 DATA_ALERT_OTP 位（bit3）：与过压/过流/过功率（用户可关）不同，过温属硬件保护恒定生效，阈值 60 度为 S3 结温降额的保守预警点
    - 测量核块边界判定：数据源为 SOC 内部温度传感器（pm_aux 每 2s 更新），无有效读数不判避免误报，读侧竞态最多延迟 2s
    - 设备端呈现：告警弹窗新增机内温度一行（含降温提示），测量页顶部红条新增过温字样
    - 网页端呈现：横幅与告警状态卡新增过温（bit3），API 文档 alert_mask 说明同步
2026-10-20 perf(系统): 低优先级周期任务迁 Core1 并提升版本到 0.6.4
    - orientation（150ms I2C 转屏）、web_console_ws（15Hz 推送）、sys_monitor（5s 巡检）三个低优先级非交互任务由 Core0 迁 Core1：操作全部跨核安全（I2C 总线锁/无锁快照读/LVGL 互斥锁探测），优先级远低于 pm_sample(24) 可随时被抢占
    - 实测迁移后：巡检日志核编号=1，drdy 保持 4000Hz、drop/crc_fail 无增长、无 panic；Core0 专注 UI/LVGL/httpd/WiFi
    - httpd 评估后留守 Core0（handler 含 NVS 写与 OTA flash 擦写，与采样核分离更稳妥），理由已注释固化
    - architecture.md 双核分工表重写（含不迁移项清单）；READ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
2026-10-20 feat(测量): 过温告警改为双数据源取高者并调整阈值为 65 度
    - 判定改为「SOC 结温」与「AHT20 机内温度」两者任一超过阈值即置位，覆盖单源盲区（前者测主控自身发热、后者测机内空气/结构温升）
    - 阈值 60℃ 调整为 65℃：兼顾提前预警与避免满载正常温升误报（S3 结温上限约 105℃，锂电池长期建议不超过 60~65℃）
    - 阈值提为宏 PM_OVER_TEMP_C，判定处先用局部变量取两个源的快照再比较，避免两次读之间被更新导致判断撕裂；刻意不加 aux 互斥锁（4kHz 采样任务等锁会破坏 DRDY 读取窗口）
    - 设备端告警弹窗同时显示两路温度（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
2026-10-20 feat(字库): 中文字库由 GB2312 一级扩展到一级+二级共 6763 字
    - 此前只含一级 3755 字，中文 WiFi 名里的二级汉字显示为方框；现补入二级区（区码 D8~F7，3008 字），子集从 4075 扩到 7078 码点 / 7075 字形
    - 实测容量：单字重 2088KB、两字重 4175KB；storage 挂载后可用 7346KB，烧录后已用 4208KB（57.3%），剩余约 3.1MB（余量 43%），可放下
    - 运行期两套 TTF 整读入 PSRAM 由 2.2MB 升至 4.1MB，实机 PSRAM 使用率 38%→62%（仍剩 3.2MB），字体加载 16/16 成功、无回退
    - 未扩到 GBK 全量（约 21003 字）：按实测 0.29KB/字形推算两字重约 12MB，装不进 8MB 分区；GBK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
2026-10-20 feat(网页端): 实时数据支持读数刷新帧率与电压电流功率分色
    - 新增「读数刷新」档位 15/10/5/2/1 Hz：设备发送速率与波形缓冲仍为 15Hz 全速，仅本页数字刷新按设定节奏；低于 15Hz 时把期间收到的多帧做算术平均再刷新（低档读数更稳），累计量与状态量取最新帧不参与平均
    - 电压/电流/功率三卡片分色（绿/蓝/橙，与波形图三通道同色），卡片边框与标签同步着色，形成色标
    - 告警状态卡片的说明补充过温
2026-10-20 chore(工程): 版本号提升到 0.6.5 并同步字库容量与过温说明
    - README：过温改为双数据源任一 >65℃、字库范围、网页读数刷新帧率与三色区分
    - architecture：字体方案补入 GB2312 一级+二级的完整容量账（flash 4175KB/余量 3.1MB、PSRAM 约 4.1MB）、GBK 全量为何放不下的推算、以及 OTA 不含 storage 的提醒；里程碑补 v0.6.5
2026-10-20 docs(工程): 新增固件组成与烧录指南并同步注释口径
    - 新增 docs/build_and_flash.md：5 个镜像的作用/偏移/大小表、分区表解读、为何字体独立放 storage（OTA 更新不到）、idf.py/flash_fw.bat/网页 ESPConnect 三种烧法与参数、该烧哪些文件的判断表、OTA 限制、烧录后确认清单与排错表
    - README 烧录章节补镜像组成表与改字库必须全量烧录的提醒，并加入文档索引；CONTRIBUTING 补烧录范围提醒（含 app-flash 的适用边界）；flash_fw.bat 顶部补英文备注（该文件保持 ASCII-only）
    - make_fonts.py 顶部说明由「GB2312 一级 3755 字」更正为「一级+二级 6763 字」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
2026-10-20 fix(工程): 删除合并后遗留的旧 button 组件骨架
    master 上的 drivers/button（仅 CMakeLists + button.h 骨架）与 develop 实际使用的 drivers/key_button 重名：两者都会被 ESP-IDF 当组件编译，button.h 符号冲突会导致 master 构建失败。删除旧骨架，使 master 与 develop 内容完全一致。
    [button.h]
2026-10-20 feat(测量): 电流零点校准改为测量核 3 秒块均值
    - 新增 power_measure_zero_current_start()/is_running()/last_avg()：请求经原子量交给测量核，在 200ms 块边界累计电流块均值，满 3 秒（15 块）后把 current_offset 按抵消均值调整并 deferred 落盘，不阻塞 4kHz 采样
    - 为什么搬到测量核：块均值是电流的权威口径（与正式测量同源），不受显示平滑/抽取影响；3 秒 15 块比 UI 侧读 40Hz 显示帧的 1 秒约 25 帧更抗毛刺；UI 与网页共用同一实现，口径一致
    - 设备端「一键清零」改为调用该接口，UI 只保留 100ms 轮询等采样结束并弹结果；提示文案由 1 秒改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
2026-10-20 feat(联网): 新增电能清零与标定读写接口
    - POST /api/config 新增键：energy_reset=1（清零电能/容量/运行时间，测量核块边界生效）、cal_i_zero=1（空载 3 秒块均值校零）、cal_v_gain/cal_v_offset/cal_i_gain/cal_i_offset（标定参数，均走 deferred 落盘，httpd 任务不写 NVS）
    - 参数校验：非 1 的清零请求与 nan/inf 标定值一律拒绝；增益 >0 由 deferred 内部把关
    - GET /api/config 新增 cal_* 四个标定字段与 cal_zero_running（供网页轮询 3 秒采样是否结束），应答缓冲 384→640 字节
    - web_console 增加 power_measure 依赖（与既有 settings 依赖同理：展示层只读查询）
2026-10-20 feat(网页端): API 页改为编号卡片与就地测试，实时页分色并新增清零与标定
    - API 页按 ip-query/api-docs 的结构重构：8 张编号卡片（圆标+标题+说明+端点行+示例行），接口清单集中在 API_DOCS 一处，增删接口只改数据；每张示例行带「▶ Test」就地发真实请求，结果展开显示 HTTP 状态码/耗时/字节数/正文，替代原先把请求填进测试台的两步操作
    - 实时数据页「当前功率」主读数颜色改为 #f0883e，与下方功率卡片一致（同一物理量同色，避免误以为是两个量）
    - 实时数据页新增「清除电能统计」按钮：二次确认后 POST energy_reset，测量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
2026-10-20 chore(工程): 版本号提升到 0.6.6 并同步文档
    - README：网页端补测量标定、清除电能、API 卡片式文档；architecture 里程碑补 v0.6.6（含校零搬进测量核的理由）
2026-10-20 fix(测量): 电流小信号死区归零，修复空载读数跳动与电能虚假累积
    - 根因：1mΩ 分流器 + PGA 16x 下 1 LSB=8.94µA，单帧噪声 σ≈2mA（5s 原始码峰峰≈17mA），25ms 显示子窗残余 σ≈0.2mA，叠加数百 µA 零点温漂，空载末位（10µA 分辨率）乱跳，且 P=V×I 噪声使电能缓慢虚假累积
    - 处理：|I|<2mA 时，25ms 显示子窗与 200ms 块均值同步归零（读数/峰谷/告警/电能同口径）；三级波形缓冲仍写原始样本，示波页不受影响
    - 验证：1mA 死区实测 2 分钟 8/1165 帧越界（-1.02~-1.21mA）；改 2mA 后空载 3 分钟 1730 帧全为 0，电能零漂移；串口确认 4kHz 帧率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
    [power_measure.c]
2026-10-21 feat(UI): 波形纵轴刻度去尾零；快速菜单清零改二次确认
    - 波形页纵轴刻度去掉多余的 0：3.00V→3V、0.200A→0.2A（trim_num_tail，含负零归一；刻度锚定 1-2-5 格值，去零不损失信息）。宿主测试 11 用例全过，模拟器截图确认
    - 首页快速菜单的「清除电能统计」先弹确认框（K1=取消/K2=确定），与设置页同一实现：对话框基础设施由 screen_settings.c 上移为共享模块 ui_msgbox.{c,h}（顶层图层模态+压暗遮罩+中文字体+按键取消/确定+叠窗防御），设置页只留薄封装，调用点零改动
    - ui_nav 把模态弹窗按键设为最优先路由（任何页面 K1/K2 都归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
2026-10-21 fix(UI): 弹窗宽度随屏幕方向自适应，修复竖屏左右被裁
    - 根因：共享弹窗硬编码 250px、msgbox 类默认 260px，竖屏逻辑宽度仅 240px，左右各溢出 5~10px 被裁掉
    - 新增 ui_msgbox_fit_width()：宽度 = min(屏宽-24, 280)，横屏 260 / 竖屏 216；正文标签宽度为 content 的 100%，缩窄后长文本自动换行
    - 统一覆盖三处弹窗：共享提示/确认框、启动故障提示、测量告警弹窗（ui.c）
    - 监听 LV_EVENT_RESOLUTION_CHANGED：弹窗开着时转屏自动重新适配宽度并居中，共享弹窗与告警弹窗均处理
    - 模拟器新增竖屏确认框场景：实测 x1=12 x2=227（屏宽 240，无越界），全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
    [ui.c]
2026-10-22 feat(系统): 启动页内嵌小子库并重排初始化顺序，发布 v0.6.9
    - 启动页改用编入 app 分区的 Noto 极小子集（tools/fonts/make_splash_font.py 自动收集 197 字、34KB/字重），lvgl_port 同步创建 12/14/16px 常规 + 40px 粗体四个实例（实测 4ms），首帧即完整中文，不再等待 SPIFFS 全量字库；子集创建失败才回退 ASCII
    - 显示链路（LCD/触摸/LVGL/IMU/方向）前移到第 9~13 步，fs_storage 后移到 orientation 之后（仅主界面全量字库后台任务需要）；启动页显示 18 步初始化 + 5 项自检的真实进度，屏幕点亮由 1.42s 提前到约 1.09s，主界面约 5.37s，全量字库就绪前不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
2026-11-09 feat(脚本): 构建与烧录脚本保留结果窗口，自动化可跳过暂停
    - build_fw.bat / flash_fw.bat 结束时打印成功/失败摘要（构建产物路径、烧录排查清单），并 pause 保持窗口，双击即可查看结果
    - 自动化跳过暂停：nopause 参数、XT60_NO_PAUSE=1、CI=1；真实退出码始终透传，ESP-IDF 环境初始化失败也有明确提示
    - tools/ci/run_ci.ps1 设置 XT60_NO_PAUSE=1，避免回归卡在暂停提示
    - 两只 .bat 保持纯 ASCII + CRLF，避免 cmd 在 GBK 代码页下解析错误
2026-11-09 docs(工程): 全面校核并修正代码注释与项目文档
    - 逐模块审查 68 个 .c/.h（驱动/BSP、中间件、业务服务、UI、入口编排、PC 工具链与主机测试），修正与实现不符的注释并补充初学者向说明；脚本比对确认全部为纯注释变更
    - 关键修正：ADS131M02 帧 3 字改 4 字（含 CRC）与 RREG 位域、LCD 初始化序列来源与不点背光、IMU 平放/横屏判据、快照 24B 改 68B、启动页子集 197 字/34KB/4ms、方向去抖 150ms x 3、设置页定时器 100ms、LVGL/UI 任务栈与节拍
    - 文档同步：hardware_pinout（QSPI 23MHz、缓冲 40.9KB、ADS 4 字帧、RGB565+swap_bytes、27 GPIO）、architecture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
    [ads131m02.c, ads131m02_engine.c, ads131m02_engine.h, aht20.c, aht20.h, app_init.c, app_init.h, app_tasks.c]
2026-11-09 docs(README): 修正目录锚点、补齐英文版并互链
    - 目录重写为 14 章 + 19 个子章节 + 推荐阅读共 37 条，删除不存在的附录（图片拍摄清单），锚点 0 失效
    - README.en.md 按中文版完整重写：14 章结构、表格/代码块/提示块逐节对应，41 张图片 URL 与顺序完全一致
    - 中英文顶部互链（中文文档 / English）
    - 同步修正 TE 引脚（当前固件未使用）与 OTA（拉取式、无网页上传入口）的描述
2026-11-10 docs: 添加立创开源页面界面截图
2026-11-11 docs(发布): 新增立创开源文案与博客稿，更新项目入口链接
    - docs/oshwhub-description.md：立创开源平台发布文案（标题 32 字符、简介 83 字符、Markdown/HTML 描述）
    - docs/blog-xt60-power-meter.md：开源分享文章稿（设计参数、硬件、固件、复刻与资料下载）
    - 根 README：补充立创开源工程链接，区分 Gitee / GitHub 仓库入口（GitHub 镜像待补充）
    - docs/images 下 37MB 候选封面与截图未入库：文档均使用图床直链，避免仓库膨胀
2026-11-11 docs(README): 同步中文版头部信息到英文版
    - 徽章改为空格分隔，与中文版排版一致
    - 联系方式改为列表：补充 OSHWHub 工程链接、Gitee/GitHub 双仓库入口、电子/单片机技术交流 QQ 群
2026-11-11 chore(文档): 移除已迁移的立创文案与博客稿源文件
    - 两份发布稿已迁移到独立渠道维护，仓库内不再保留，避免与最新文案产生双份事实源
    - 全仓库已确认无引用，不影响 README 与文档索引
2026-11-11 docs(README): 补充 GitHub 仓库与 QQ 群入口，联系方式改为列表
    - 顶部信息块改为列表排版，徽章之间增加空格分隔
    - 新增 GitHub 仓库地址与电子/单片机技术交流 QQ 群，立创工程链接同步为已发布地址
2026-11-11 docs(README): 补充演示视频链接并同步英文版
    - 顶部信息块填入 B 站演示视频地址，替换待补充占位
    - 英文版同步为同一视频链接，保持中英文头部信息一致
