zeruns/xt60-power-meter/(notices)

Notices in the files:
README.md:
License: CERN OHL-S v2
